skeezix/zikzak/photos/parts-shipment-may27.jpg

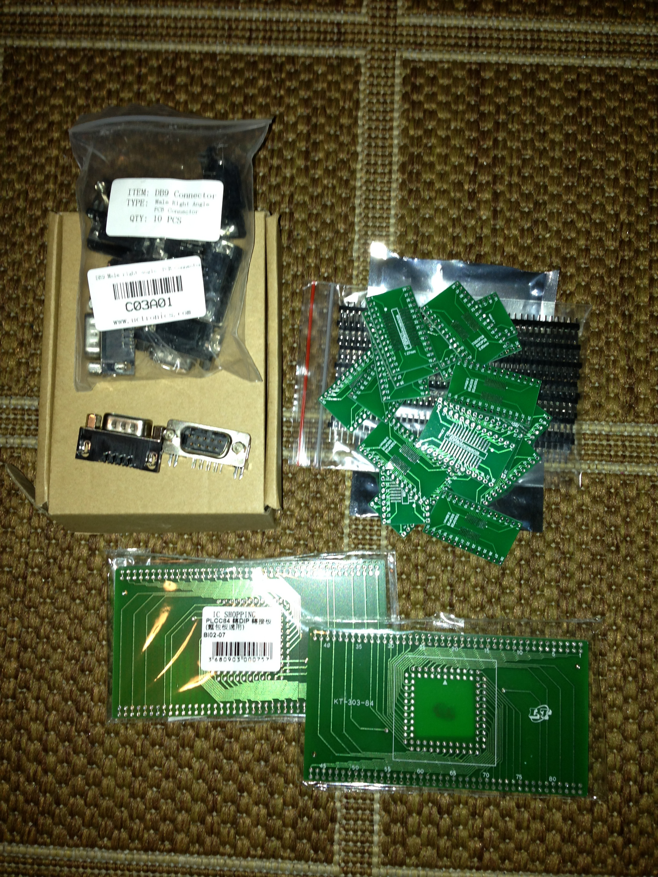
photos/parts-shipment-may27.jpg
