skeezix/zikzak/photos/zik80/zikcase/3d-print-proto/3dprinted-top-001.jpeg

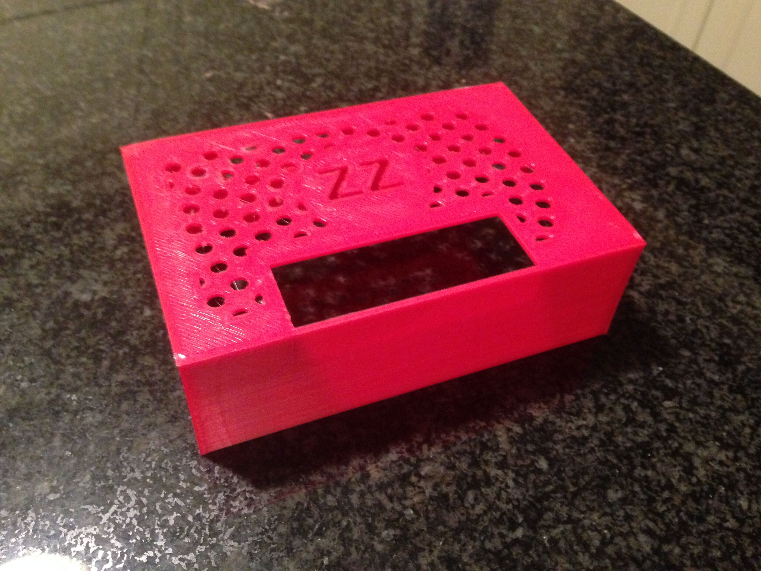
photos/zik80/zikcase/3d-print-proto/3dprinted-top-001.jpeg
