skeezix/zikzak/README.md

zikzak
======

Home designed and built retro-inspired computer; build a full computer from scratch, without using modern do-it-all chips
