skeezix/zikzak/zikzak3-gpu-c-linedemo/notes.txt

See also Pyro Electric:
http://www.pyroelectro.com/tutorials/arduino_basic_vga/software.html
