skeezix/zikzak/zikcart/protocard_2x18/cart-slot-pinout.pdf

Sheet1

36 pin (18x2)
805 Series 3.96mm (0.156”) Pitch 36P 18PX2 PCB Card Edge Connector

Top edge, female edge connector, facing into the mouth of it

## LEFT

TOP | 1 | 2 | 3 | 4 | 5 | 6
| VCC33 | A10 | A9 | A8 | A7 | A6
BOTTOM | 1 | 2 | 3 | 4 | 5 | 6
| VCC5 | A11 | A12 | A13 | A14 | A15

VCC5 – on bottom, since many through-hole parts need 5V so bottom is fine VCC33 – on top, since many surface mount parts may need 3.3V so top is better

Zikzak cartridgr

7 | 8 | 9 | 10 | 11 | 12 | 13
A5 | A4 | A3 | A2 | A1 | A0 | D0
7 | 8 | 9 | 10 | 11 | 12 | 13
A16 | A17 | A18 | A19 | A20 | A21 | D7

## RIGHT

14 | 15 | 16 | 17 | 18
D1 | D2 | D3 | /WE | /CE
14 | 15 | 16 | 17 | 18
D6 | D5 | D4 | /OE | GND
