skeezix/zikzak/zikcart/protocard_2x18/cart-slot-pinout.ods

Zikzak cartridgr
36 pin (18x2)
805 Series 3.96mm (0.156”) Pitch 36P 18PX2 PCB Card Edge Connector
Top edge, female edge connector, facing into the mouth of it
 | LEFT |  |  |  |  |  |  |  |  |  |  |  |  |  |  |  |  | RIGHT
TOP | 1 | 2 | 3 | 4 | 5 | 6 | 7 | 8 | 9 | 10 | 11 | 12 | 13 | 14 | 15 | 16 | 17 | 18
 | VCC33 | A10 | A9 | A8 | A7 | A6 | A5 | A4 | A3 | A2 | A1 | A0 | D0 | D1 | D2 | D3 | /WE | /CE
BOTTOM | 1 | 2 | 3 | 4 | 5 | 6 | 7 | 8 | 9 | 10 | 11 | 12 | 13 | 14 | 15 | 16 | 17 | 18
 | VCC5 | A11 | A12 | A13 | A14 | A15 | A16 | A17 | A18 | A19 | A20 | A21 | D7 | D6 | D5 | D4 | /OE | GND
VCC5 – on bottom, since many through-hole parts need 5V so bottom is fine
VCC33 – on top, since many surface mount parts may need 3.3V so top is better
power on left, gnd on right
includes /CE even though likely not used
Addresses on left
Data on right
least-significant-bits for address and data both on top, so easier to probe the stuff that changes more (the low-end address increment for instance)
