skeezix/zikzak/lazarus-pics/bottom-right-data-lines-25.jpg

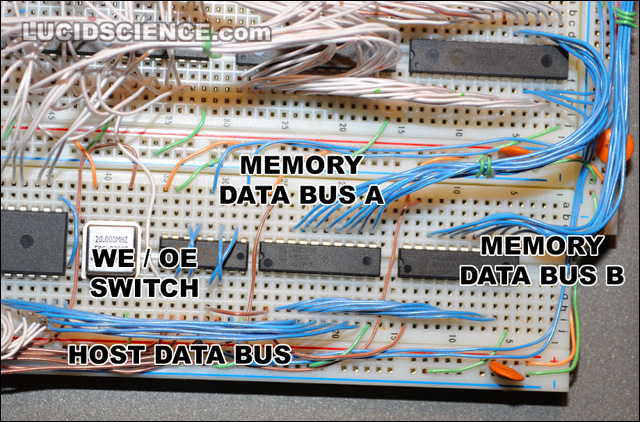
lazarus-pics/bottom-right-data-lines-25.jpg
