skeezix/zikzak/lazarus-pics/control-lines-schem15.jpg

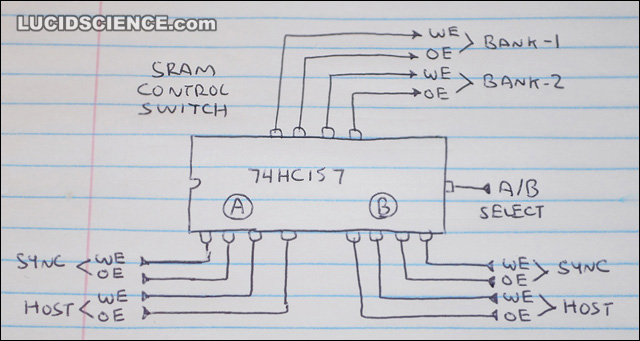
lazarus-pics/control-lines-schem15.jpg
