skeezix/zikzak/lazarus-pics/lazarus-layouts-6.jpg

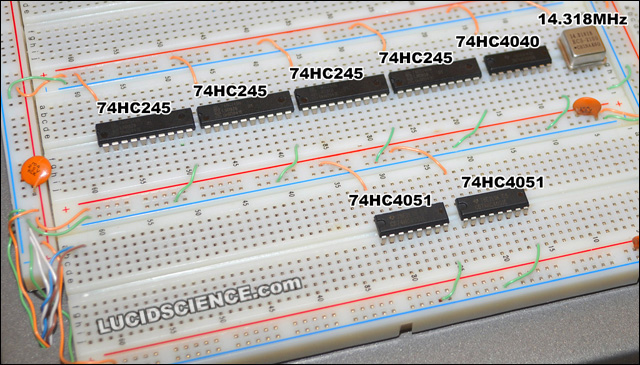
lazarus-pics/lazarus-layouts-6.jpg
