skeezix/zikzak/lazarus-pics/lazarus-layouts-11-great.jpg

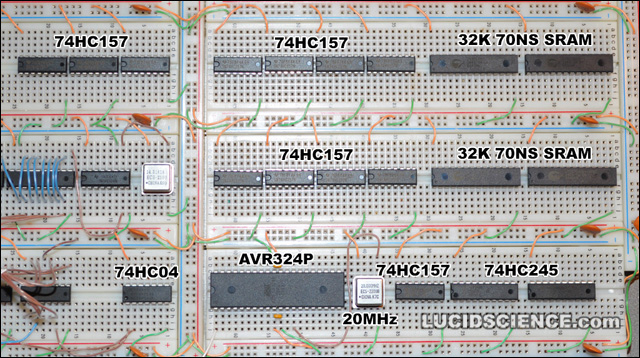
lazarus-pics/lazarus-layouts-11-great.jpg
