skeezix/zikzak/lazarus-pics/lazarus-layouts-14.jpg

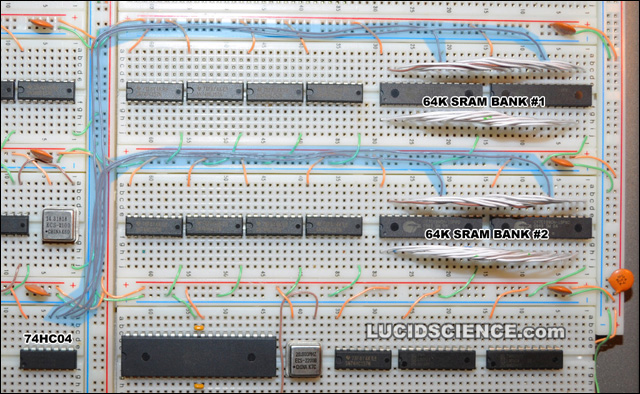
lazarus-pics/lazarus-layouts-14.jpg
