skeezix/zikzak/lazarus-pics/lazarus-layouts-16.jpg

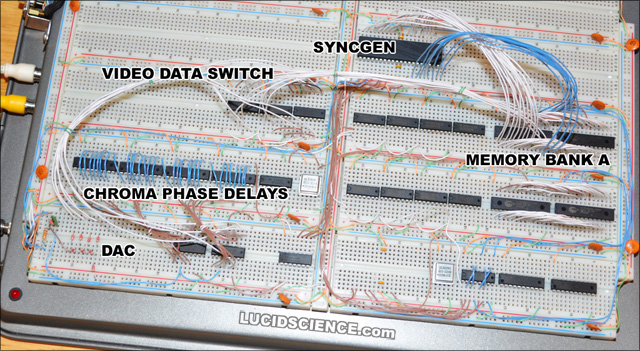
lazarus-pics/lazarus-layouts-16.jpg
