skeezix/zikzak/lazarus-pics/switcher-20.jpg

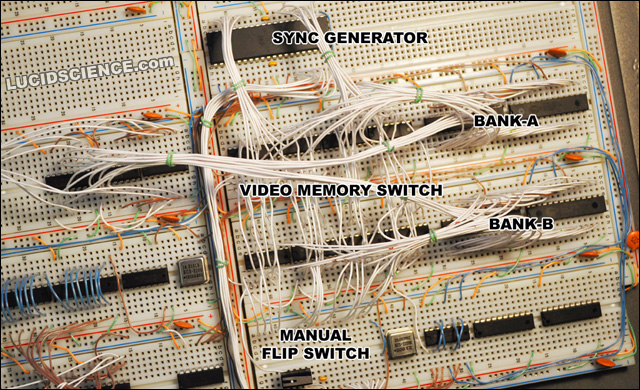
lazarus-pics/switcher-20.jpg
