skeezix/zikzak/lazarus-pics/switcher-schem-19.jpg

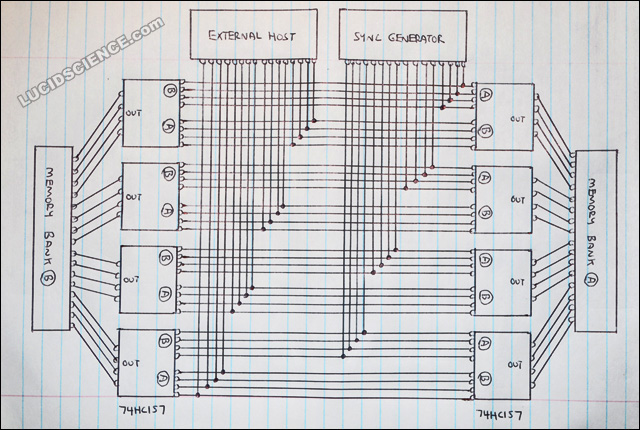
lazarus-pics/switcher-schem-19.jpg
