skeezix/zikzak/photos/atmega644-vic20-text-mode.jpg

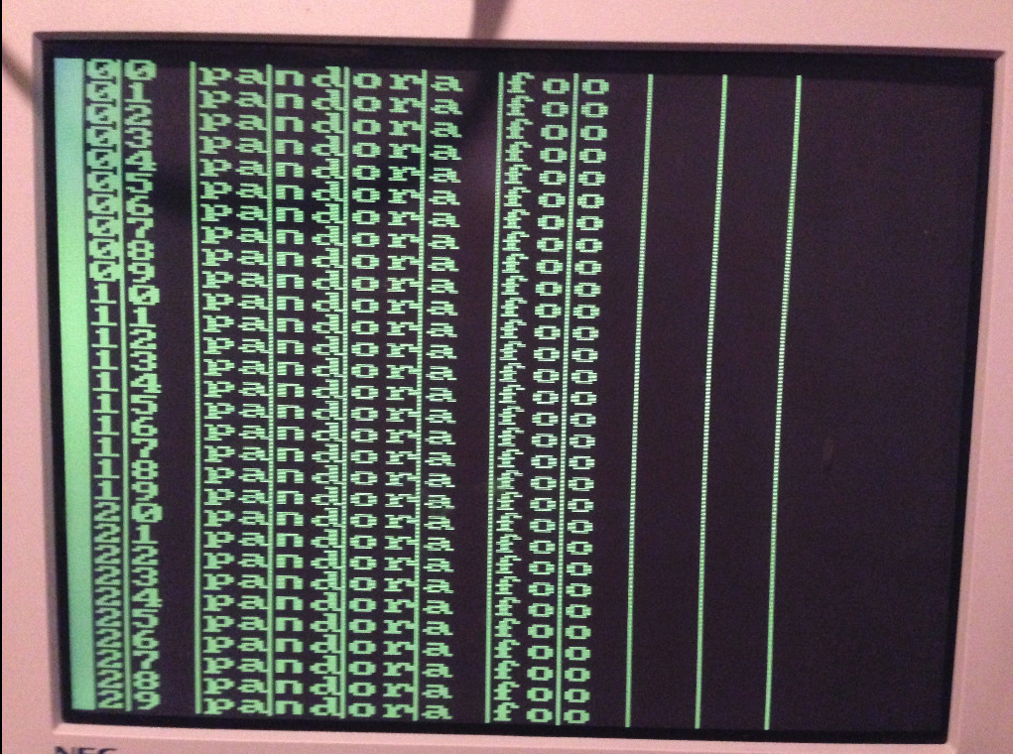
photos/atmega644-vic20-text-mode.jpg
