skeezix/zikzak/photos/zik80/base1-gpu2-power1-001.jpg

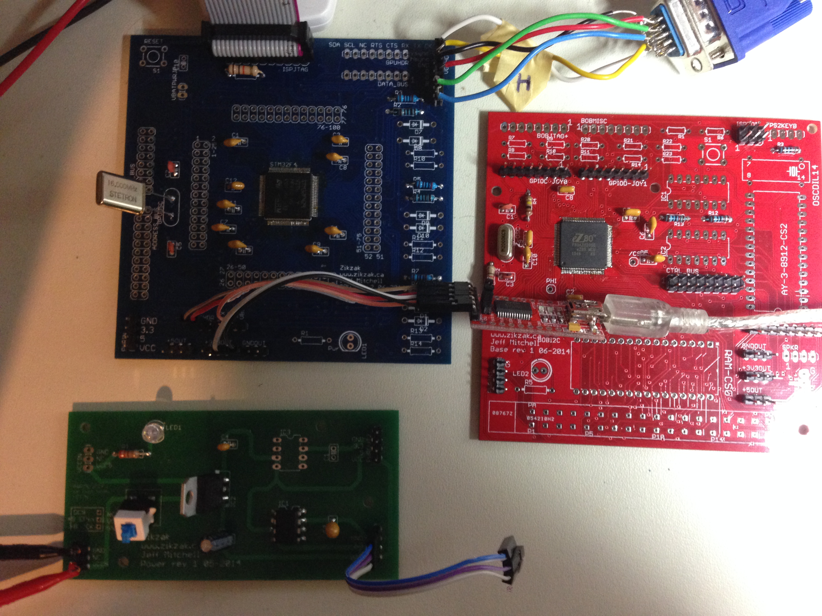
photos/zik80/base1-gpu2-power1-001.jpg
