skeezix/zikzak/photos/zik80/gpu-rev2-001.jpg

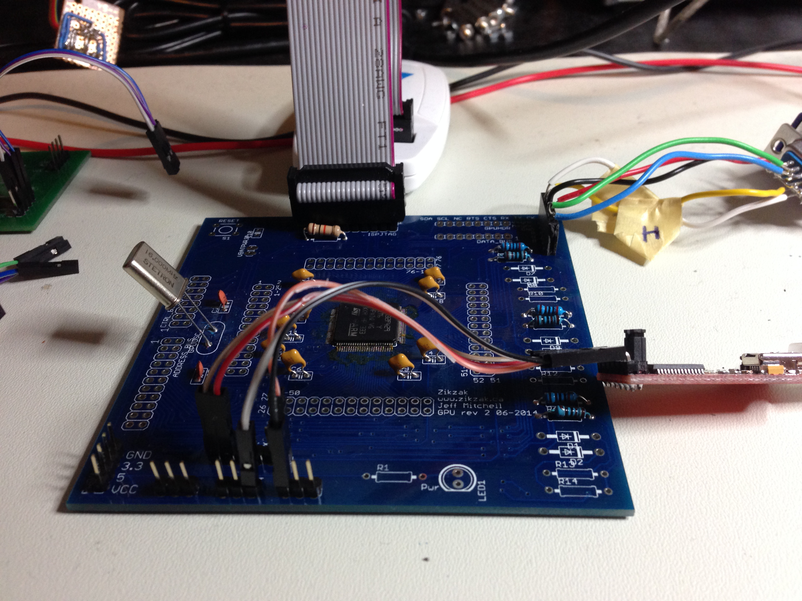
photos/zik80/gpu-rev2-001.jpg
