skeezix/zikzak/photos/zik80/gpu-rev2-rev1-comparison-001.jpg

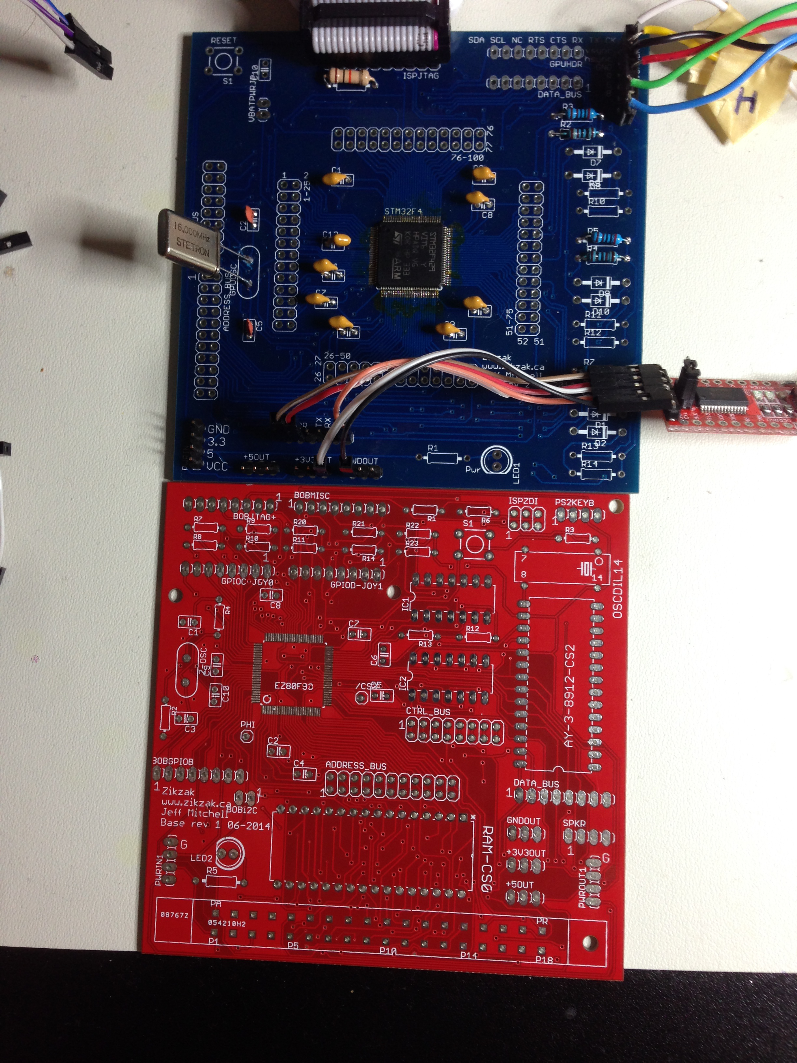
photos/zik80/gpu-rev2-rev1-comparison-001.jpg
