skeezix/zikzak/photos/zik80/gpu_and_power_frontback.jpg

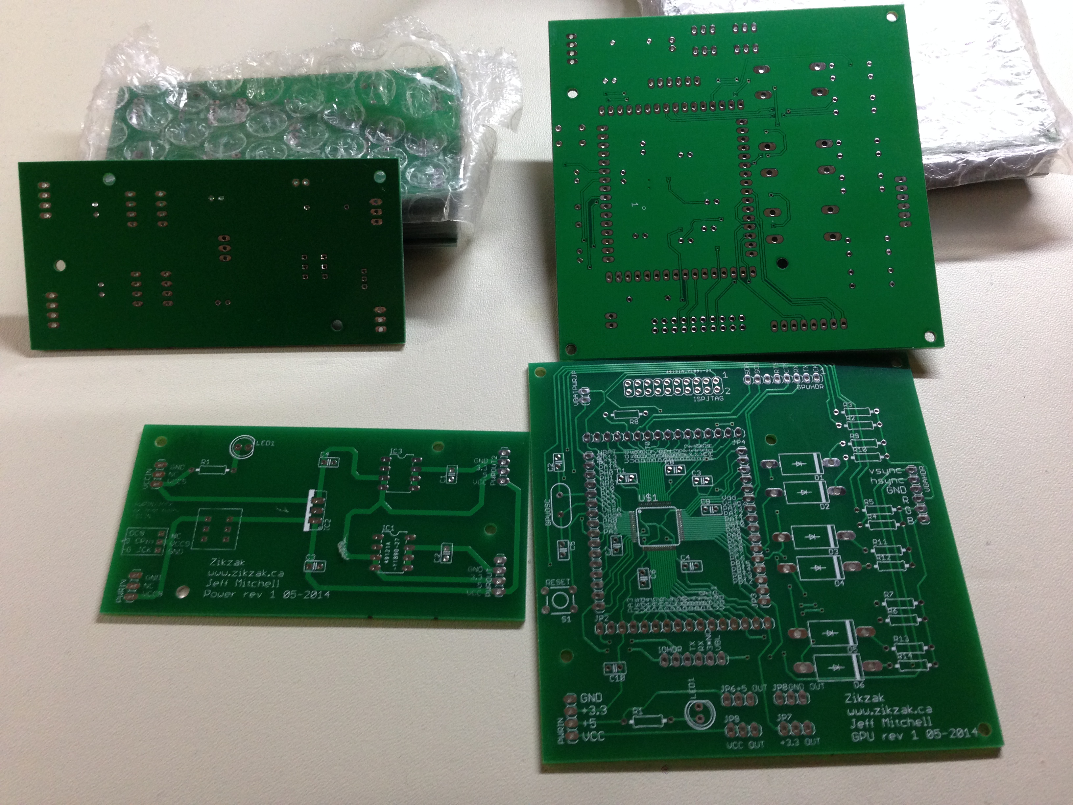
photos/zik80/gpu_and_power_frontback.jpg
