skeezix/zikzak/photos/zik80/gpu_frontback.jpg

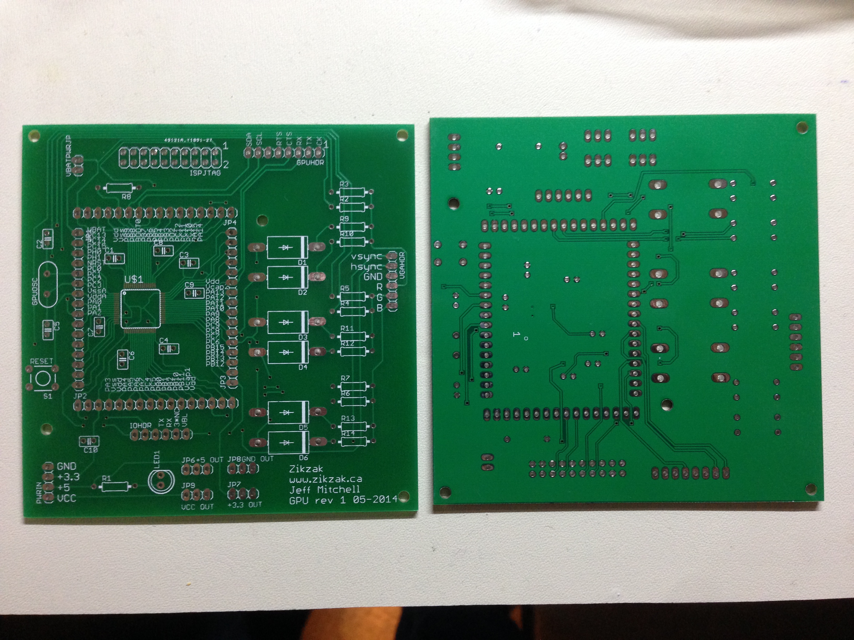
photos/zik80/gpu_frontback.jpg
