skeezix/zikzak/photos/zik80/gpu_proto_r1_running_001.jpg

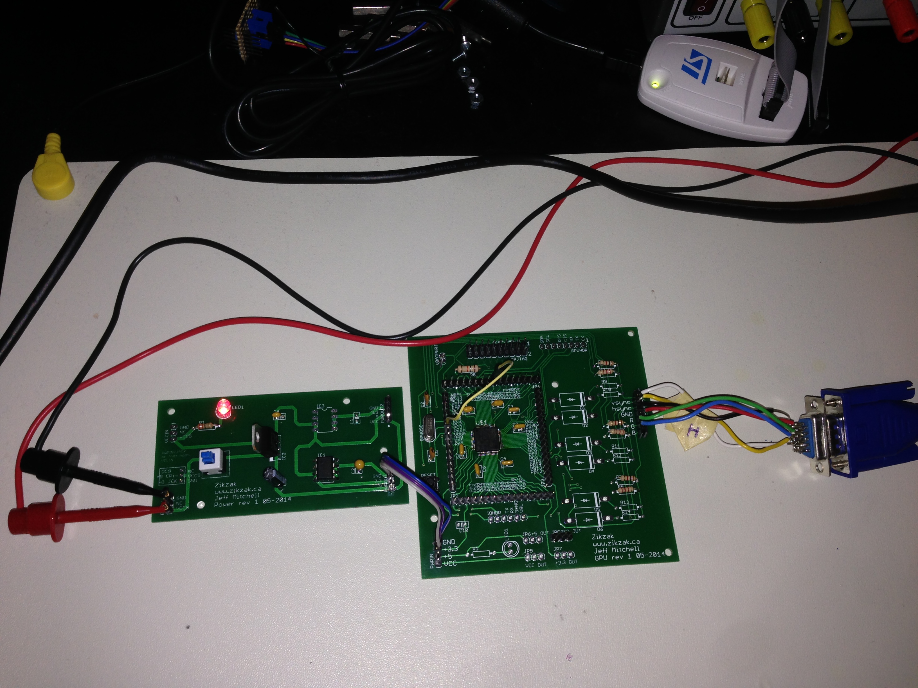
photos/zik80/gpu_proto_r1_running_001.jpg
