skeezix/zikzak/photos/zik80/sram-wtf-cs-oe.bmp

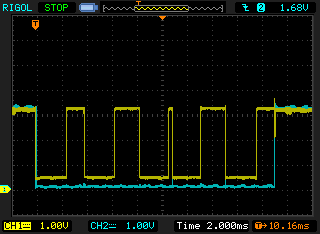
photos/zik80/sram-wtf-cs-oe.bmp
