skeezix/zikzak/photos/zik80/zik80-sbc-pcb-populated-45.jpg

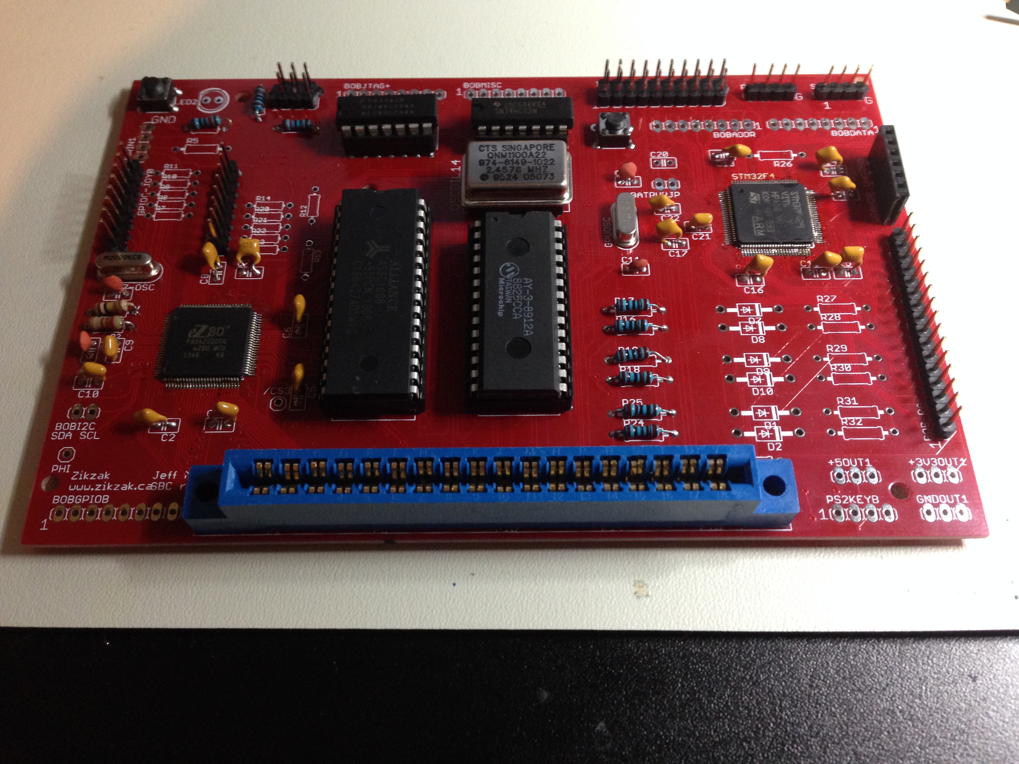
photos/zik80/zik80-sbc-pcb-populated-45.jpg
