skeezix/zikzak/photos/zik80/zik80-sbc-pcb-populated-90.jpg

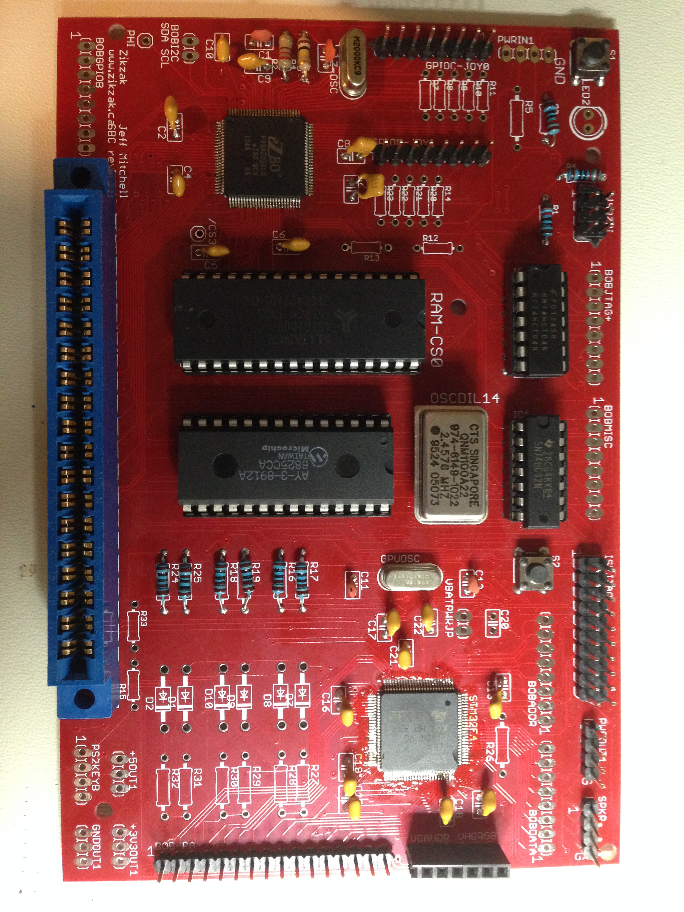
photos/zik80/zik80-sbc-pcb-populated-90.jpg
