skeezix/zikzak/photos/zik80/zik80-sbc-pcb-top.jpg

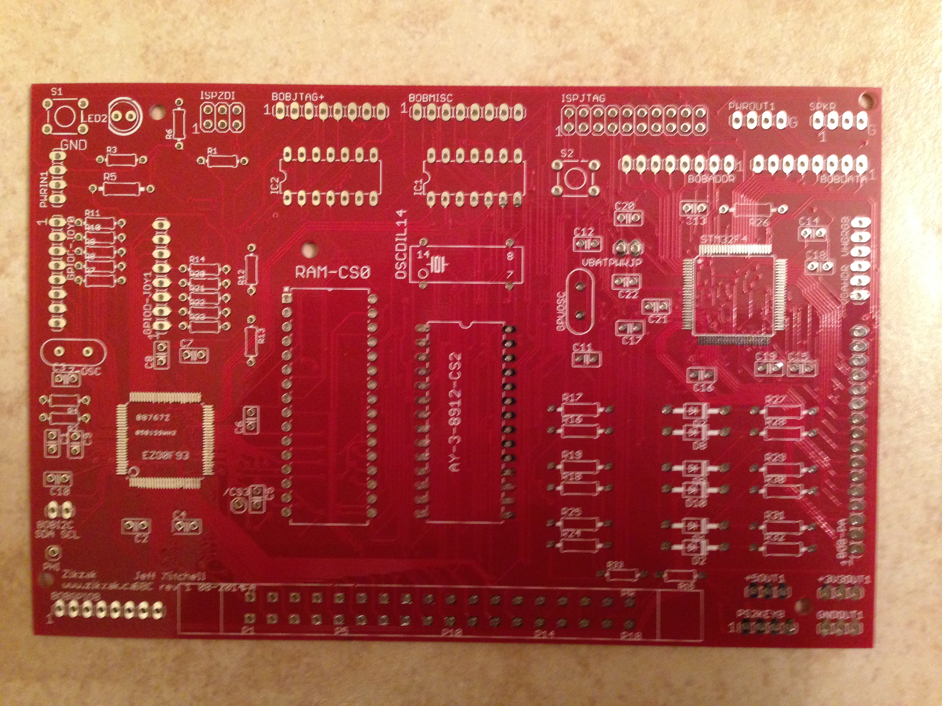
photos/zik80/zik80-sbc-pcb-top.jpg
