skeezix/zikzak/photos/zik80/zik80-sbc-pcb-topbottom.jpg

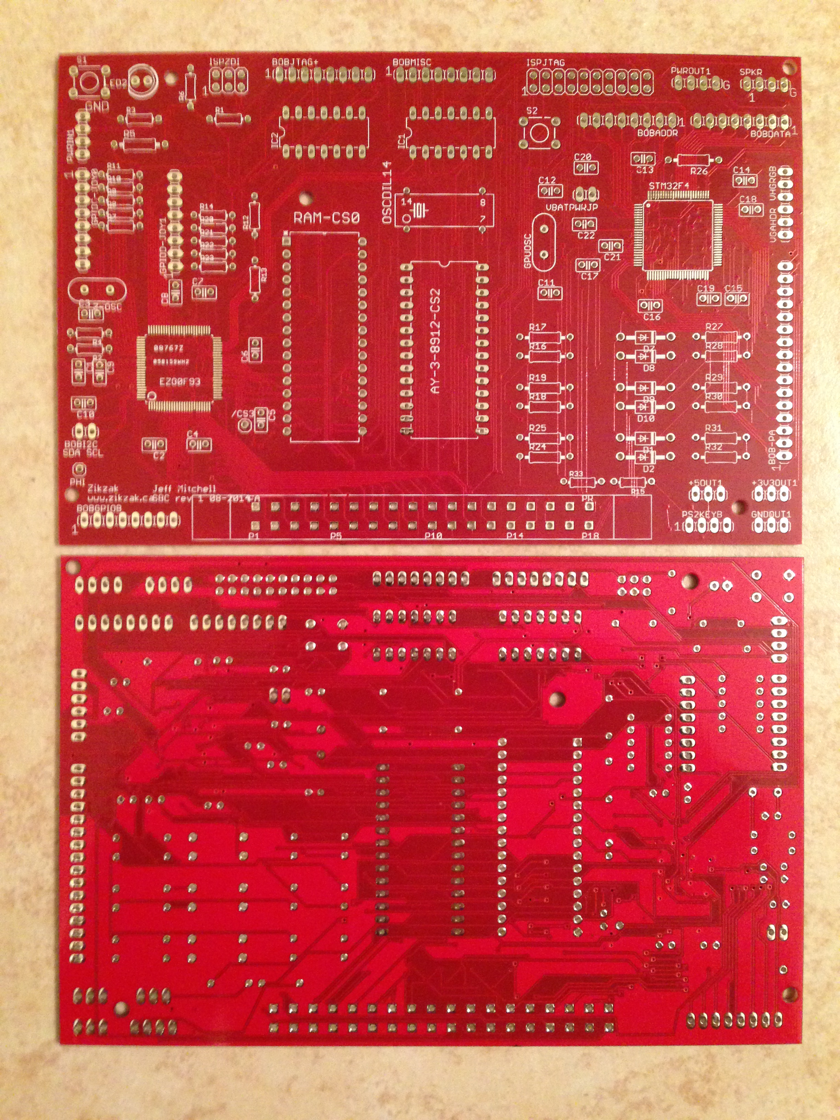
photos/zik80/zik80-sbc-pcb-topbottom.jpg
