skeezix/zikzak/photos/zik80/zikbase_with_cart_001.jpg

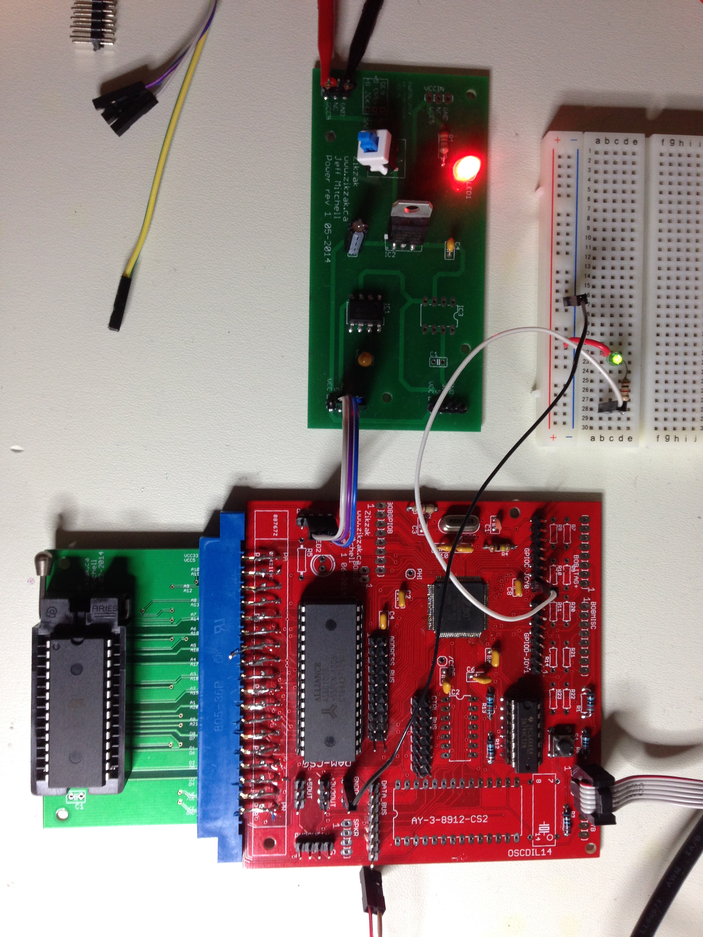
photos/zik80/zikbase_with_cart_001.jpg
