skeezix/zikzak/photos/zik80/zikzak-gpu+cpu-cthulhu-ribbons-001.jpg

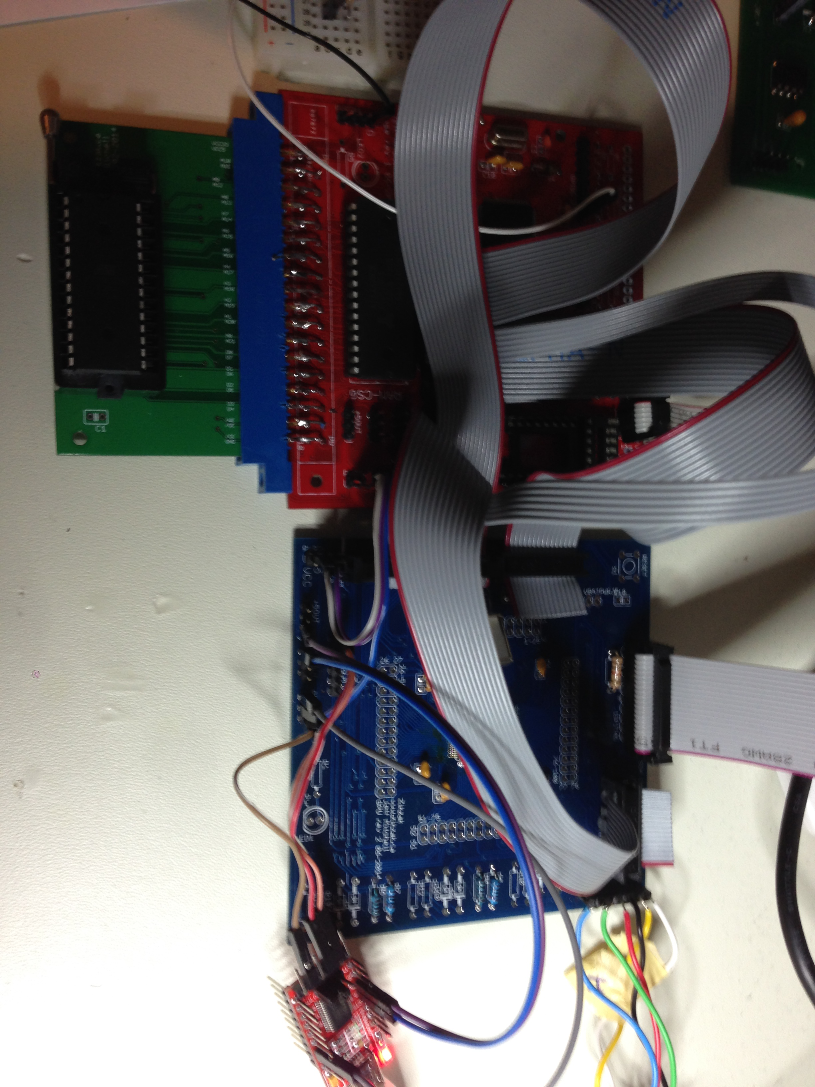
photos/zik80/zikzak-gpu+cpu-cthulhu-ribbons-001.jpg
