skeezix/zikzak/photos/zik80/zikzak-gpu+cpu-sram-framebuffer-001.jpg

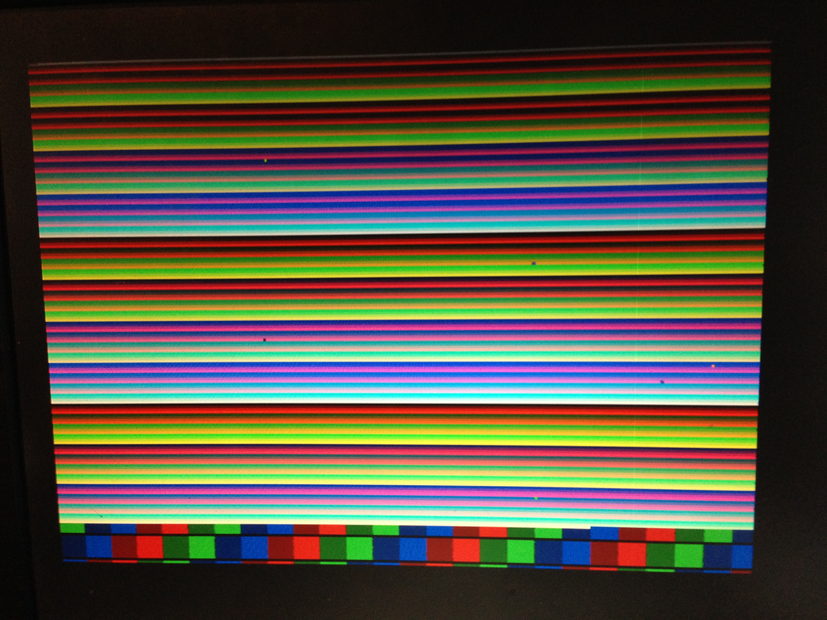
photos/zik80/zikzak-gpu+cpu-sram-framebuffer-001.jpg
