skeezix/zikzak/photos/zik80/zz-sbc-r3-001.jpg

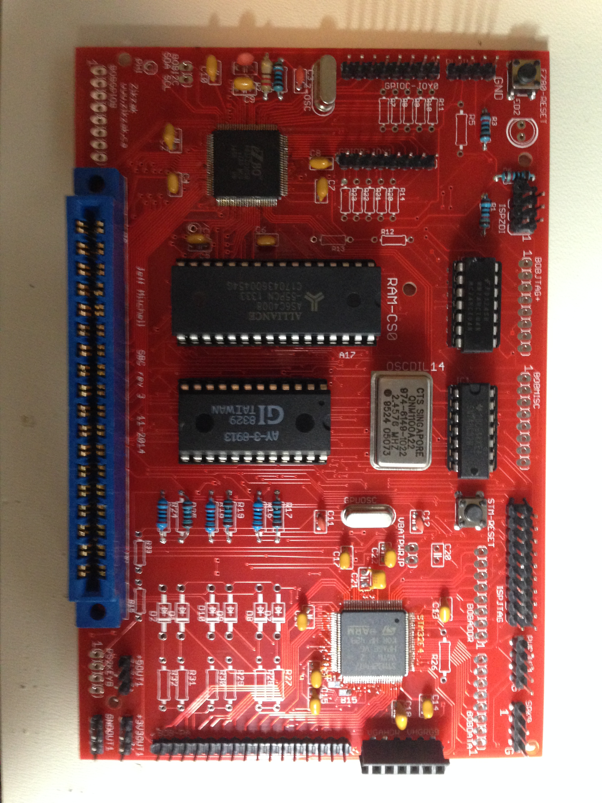
photos/zik80/zz-sbc-r3-001.jpg
