skeezix/zikzak/photos/zik80/zz-sbc-r3-002.jpg

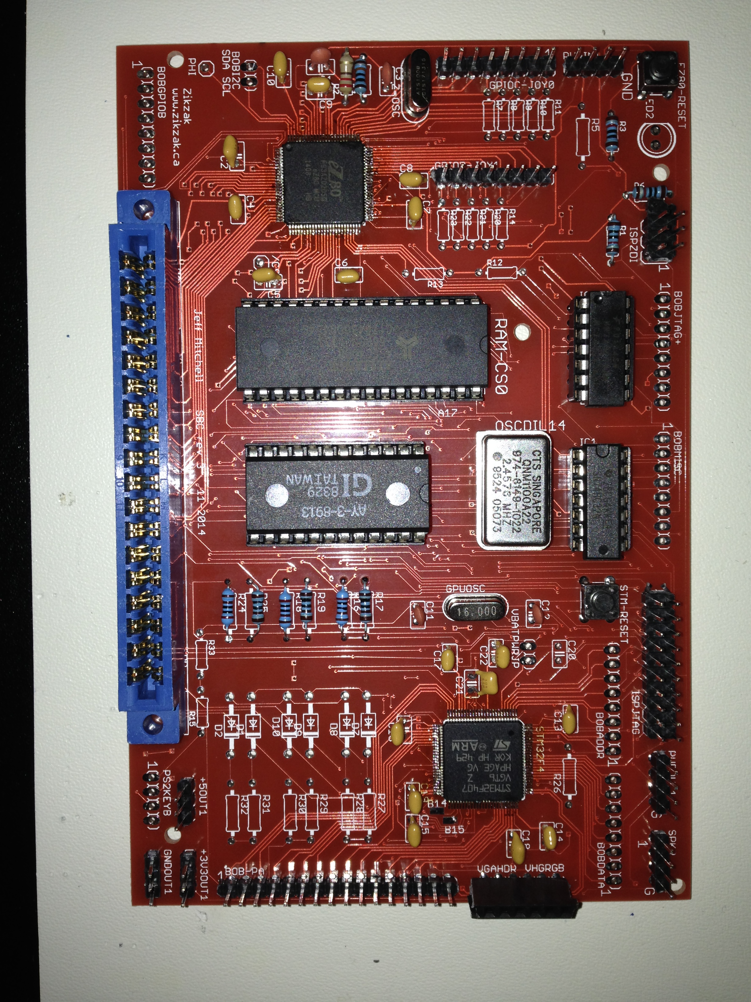
photos/zik80/zz-sbc-r3-002.jpg
