skeezix/zikzak/photos/zik80/zz-sbc-r3-003-RESIZE86.jpg

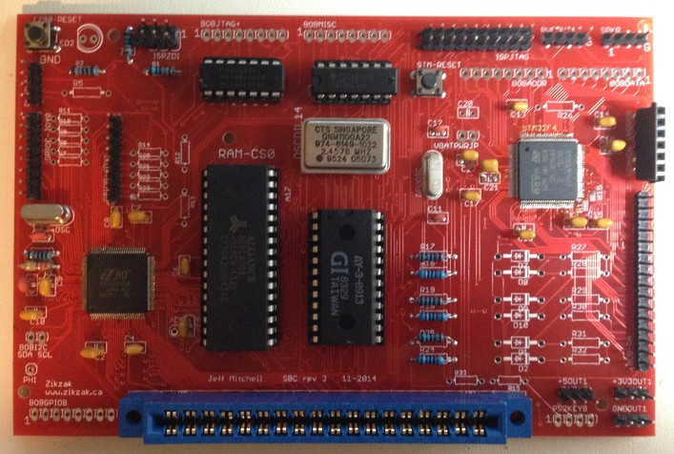
photos/zik80/zz-sbc-r3-003-RESIZE86.jpg
