skeezix/zikzak/photos/zik80/zz-sbc-r3-004-withcart.jpg

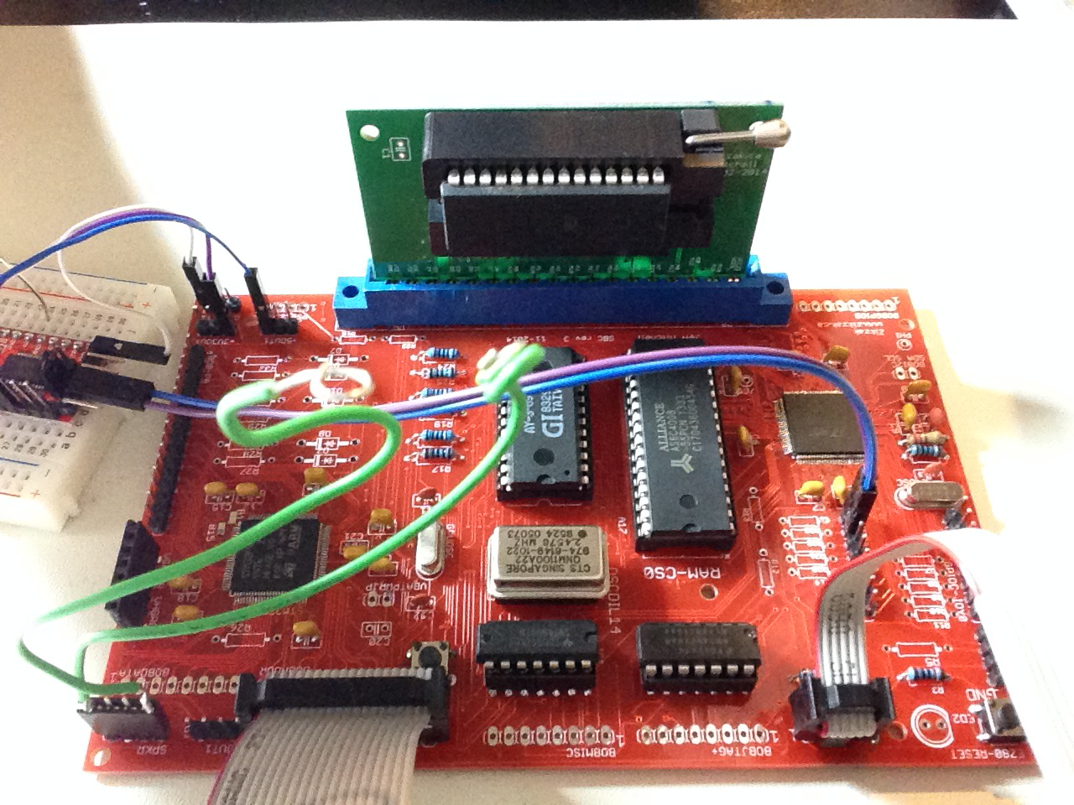
photos/zik80/zz-sbc-r3-004-withcart.jpg
