skeezix/zikzak/photos/zik80/zz-sbc-r3-iso-RESIZE86.jpg

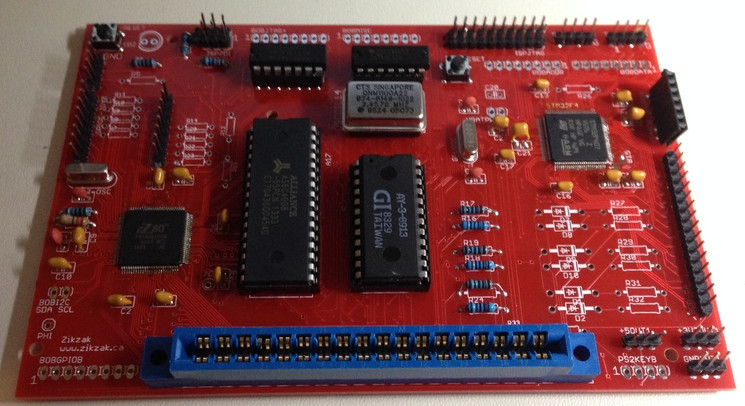
photos/zik80/zz-sbc-r3-iso-RESIZE86.jpg
