skeezix/zikzak/photos/zik80/zz-sbc-r3-iso.jpg

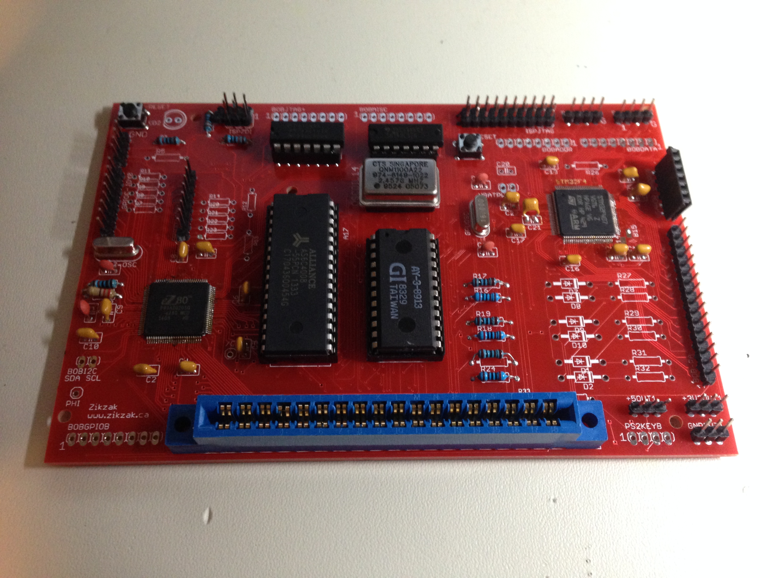
photos/zik80/zz-sbc-r3-iso.jpg
