skeezix/zikzak/photos/zik80/zzr3-shield-r1-progress/zikshield r1 on ZZr3 - 001 - hooked up.jpg

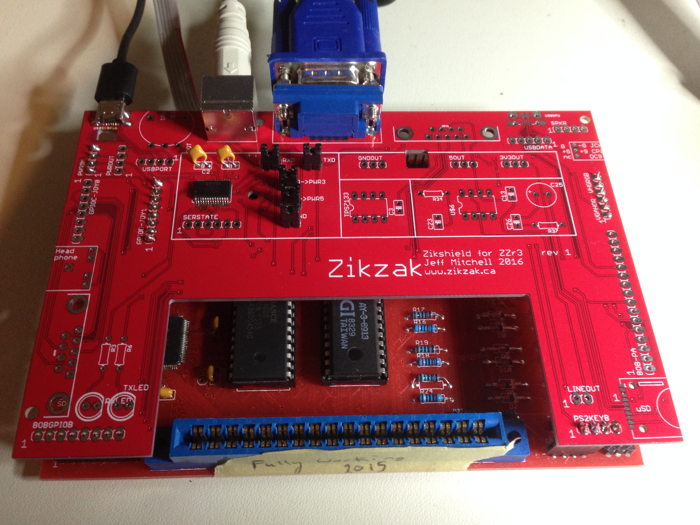
photos/zik80/zzr3-shield-r1-progress/zikshield r1 on ZZr3 - 001 - hooked up.jpg
