skeezix/zikzak/photos/zik80/zzr3-shield-r1-progress/zikshield-wip-002-with-connectors.jpg

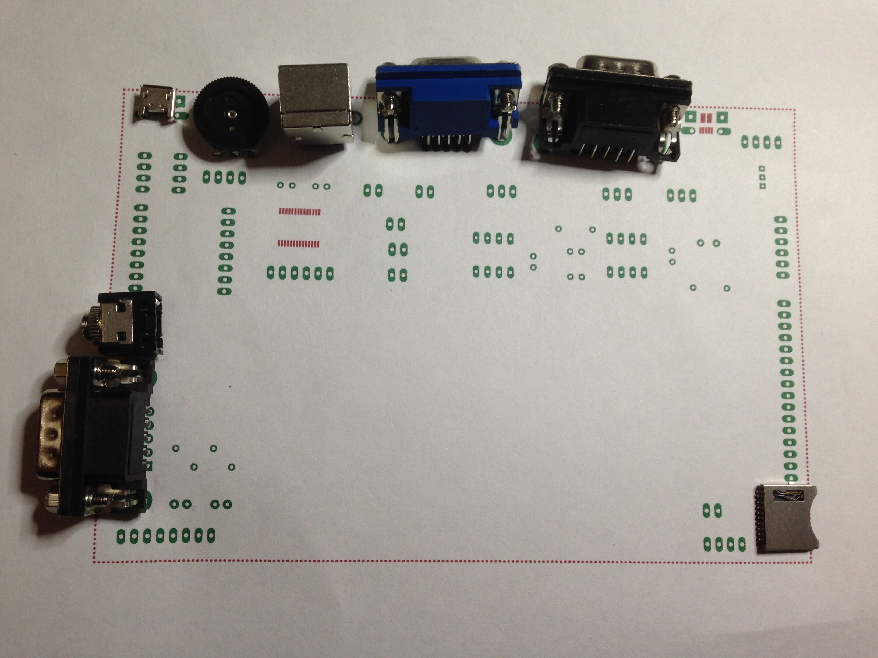
photos/zik80/zzr3-shield-r1-progress/zikshield-wip-002-with-connectors.jpg
