skeezix/zikzak/photos/zik80/zzr3-shield-r1-progress/zzr3-just-pads-etc.png

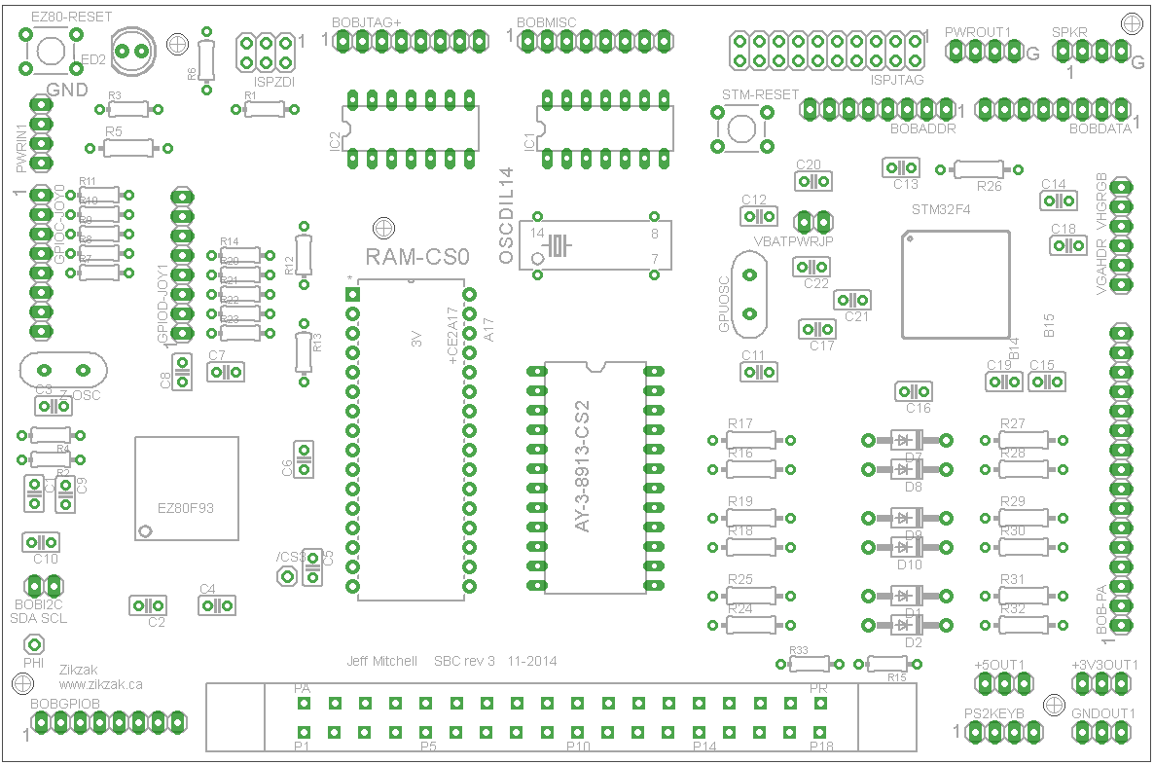
photos/zik80/zzr3-shield-r1-progress/zzr3-just-pads-etc.png
