skeezix/zikzak/photos/zik80/zzr3-shield-r1-progress/zzr3-shield-r1-layout-wip-002.png

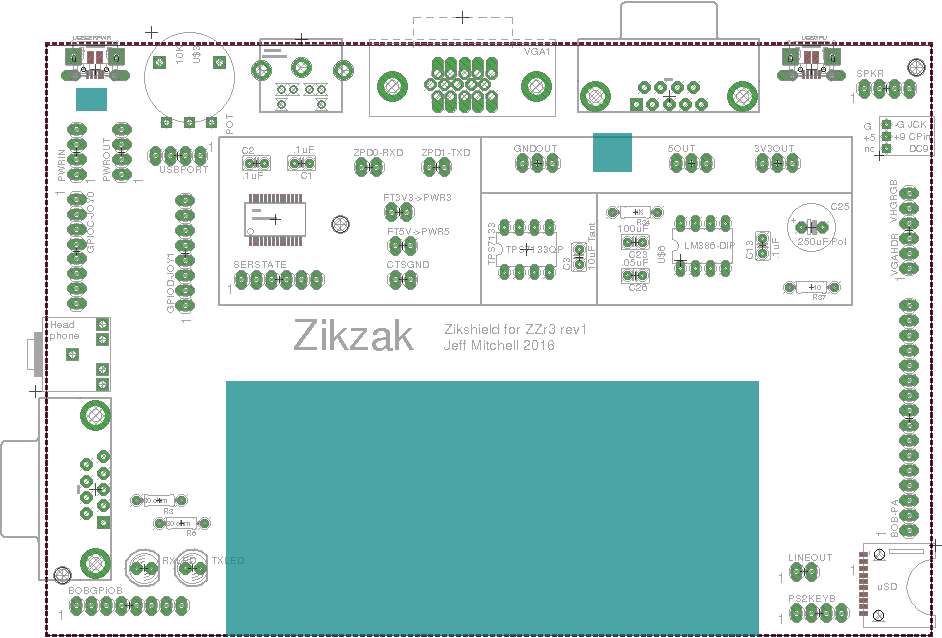
photos/zik80/zzr3-shield-r1-progress/zzr3-shield-r1-layout-wip-002.png
