skeezix/zikzak/photos/zikzak1-ntsc-mono-line-001.jpg

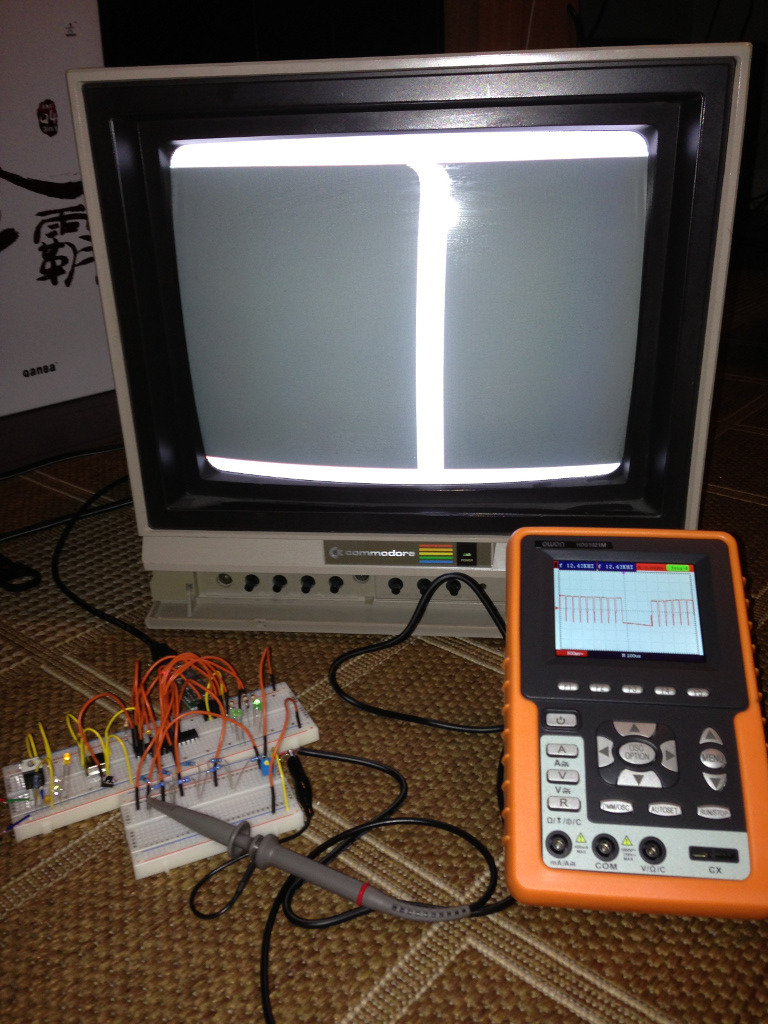
photos/zikzak1-ntsc-mono-line-001.jpg
