skeezix/zikzak/photos/zikzak2-vga-000-schem.jpg

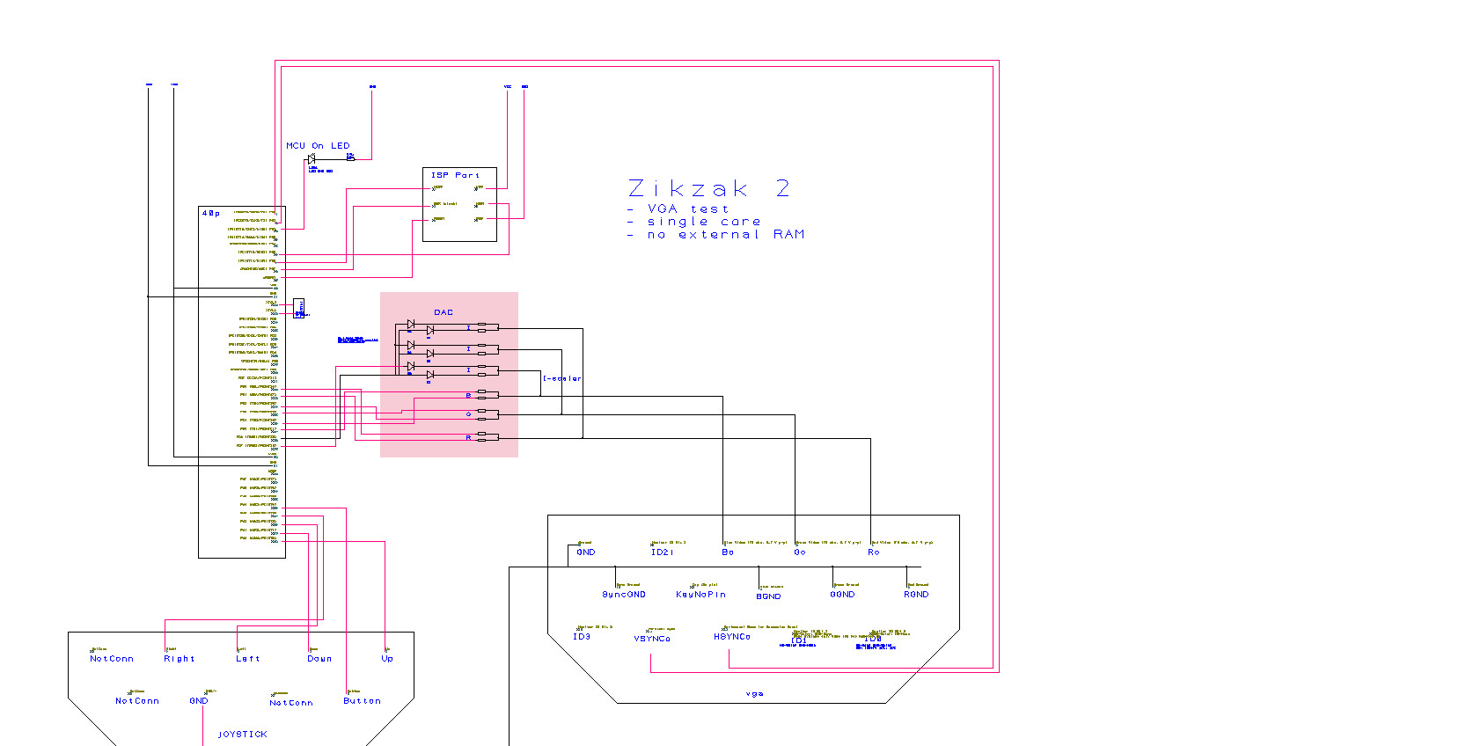
photos/zikzak2-vga-000-schem.jpg
