skeezix/zikzak/photos/zikzak2-vga-001-bb.JPG

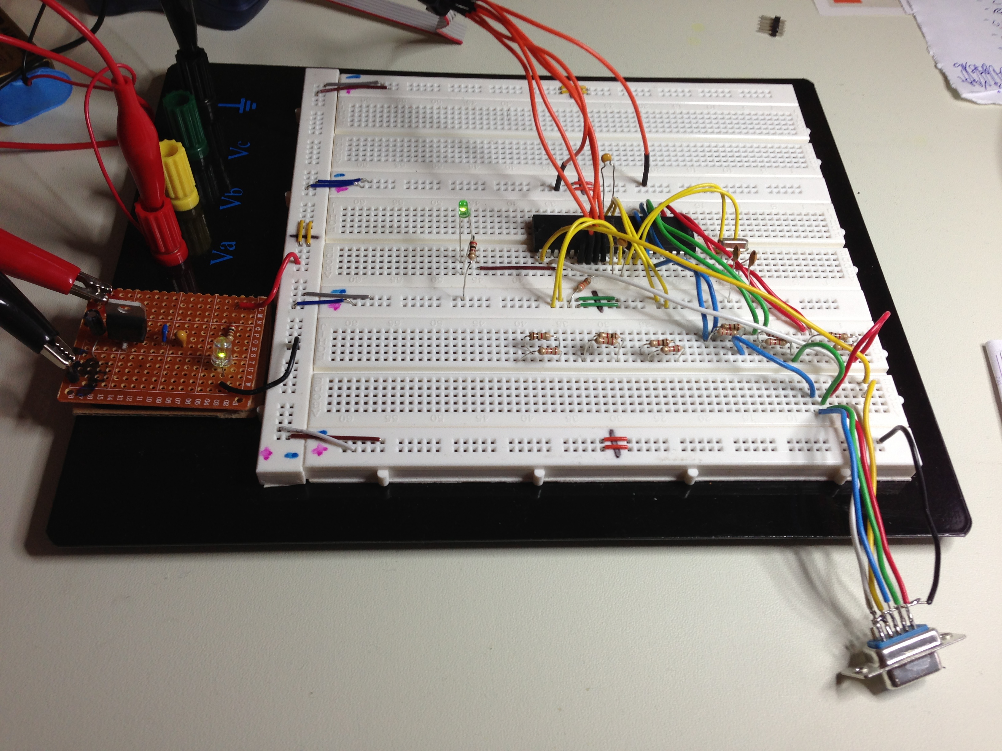
photos/zikzak2-vga-001-bb.JPG
