skeezix/zikzak/photos/zikzak2-vga-002-colour1.jpg

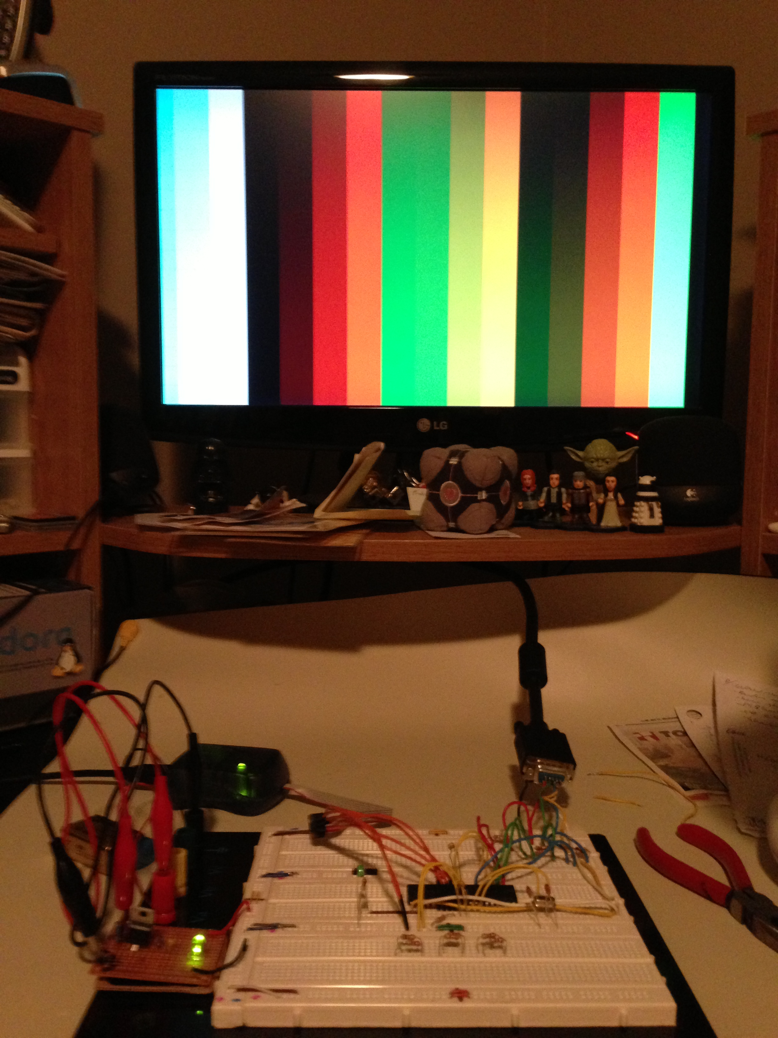
photos/zikzak2-vga-002-colour1.jpg
