skeezix/zikzak/photos/zikzak2-vga-002-colour2.jpg

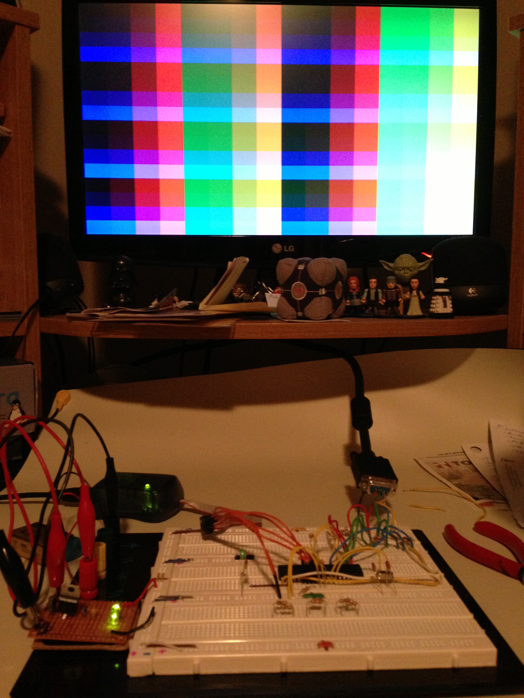
photos/zikzak2-vga-002-colour2.jpg
