skeezix/zikzak/photos/zikzak2-vga-002-redbar-r.JPG

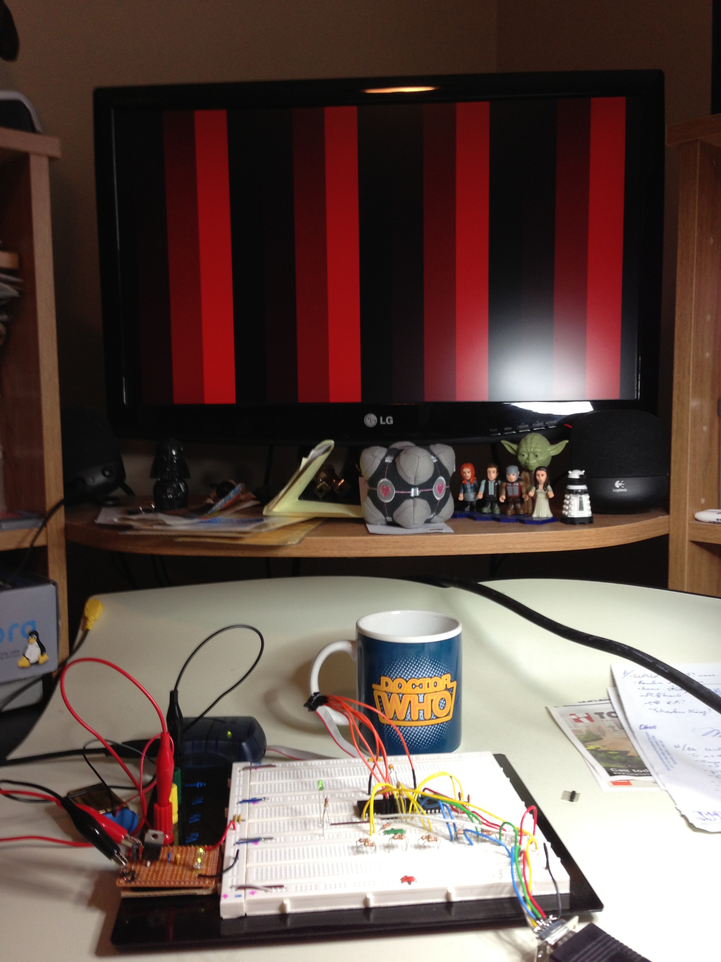
photos/zikzak2-vga-002-redbar-r.JPG
