skeezix/zikzak/photos/zikzak3-gpu-memswitch-complete.JPG

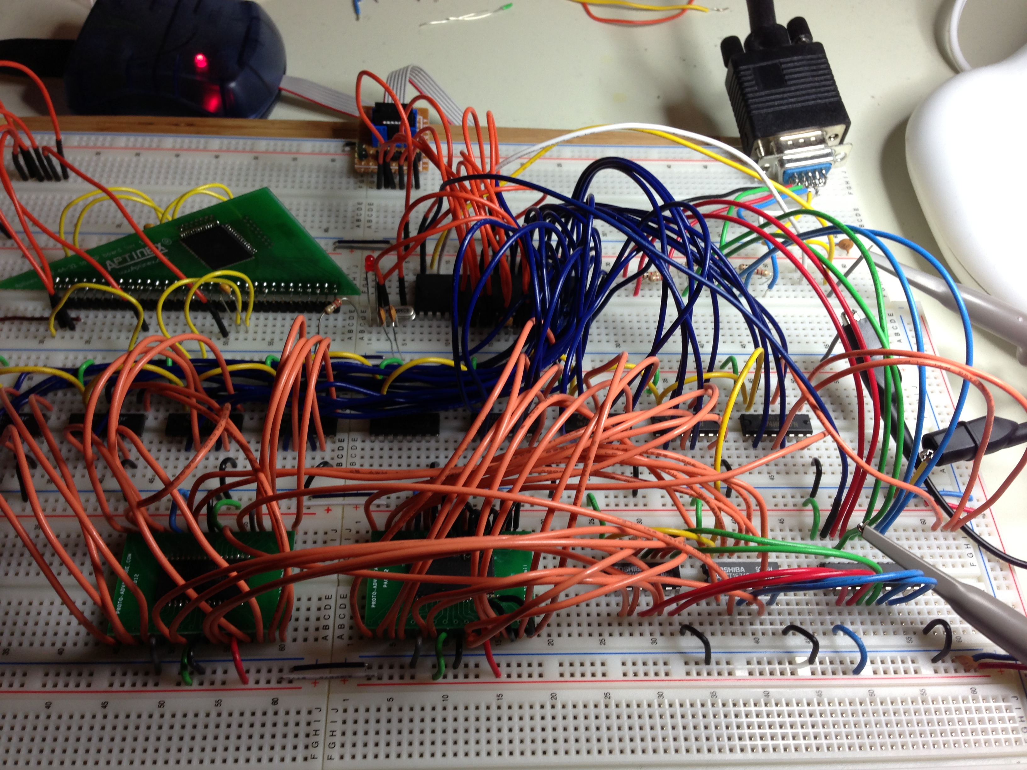
photos/zikzak3-gpu-memswitch-complete.JPG
