skeezix/zikzak/photos/zikzak3-memswitch2.png

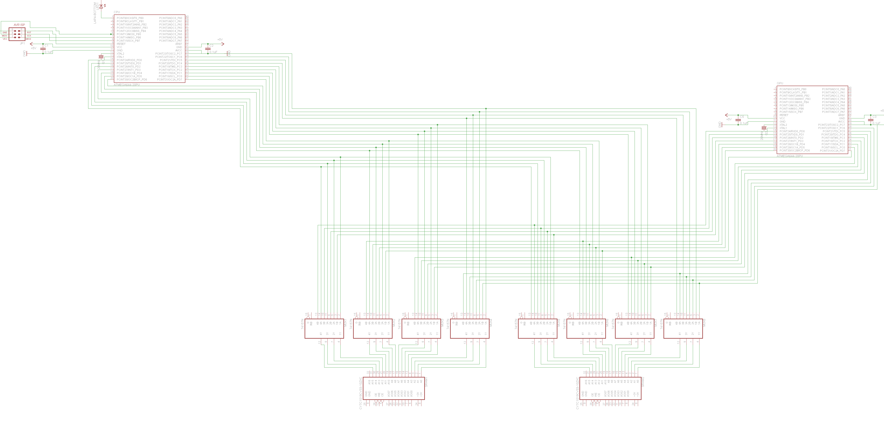
photos/zikzak3-memswitch2.png
