skeezix/zikzak/photos/zikzak3-memswitch3.png

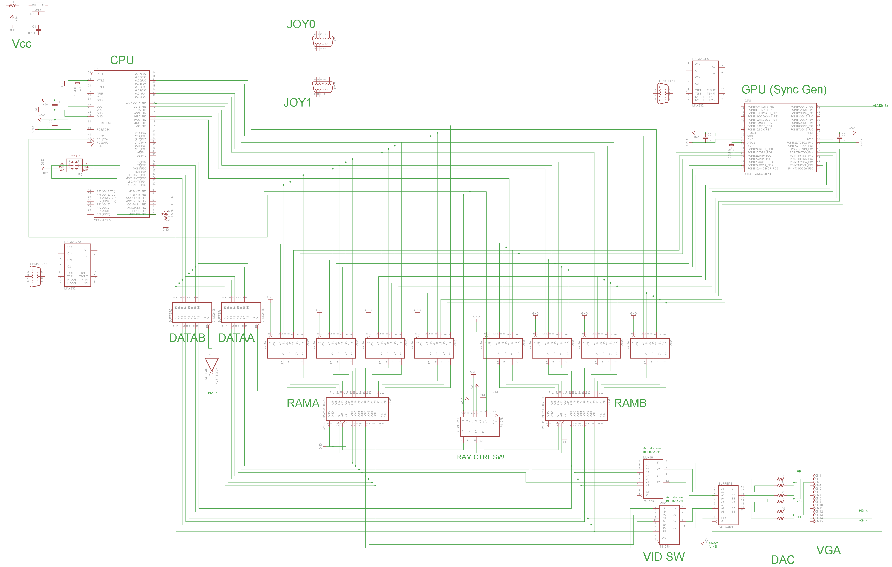
photos/zikzak3-memswitch3.png
