skeezix/zikzak/photos/zikzak_giant_breadboard.jpg

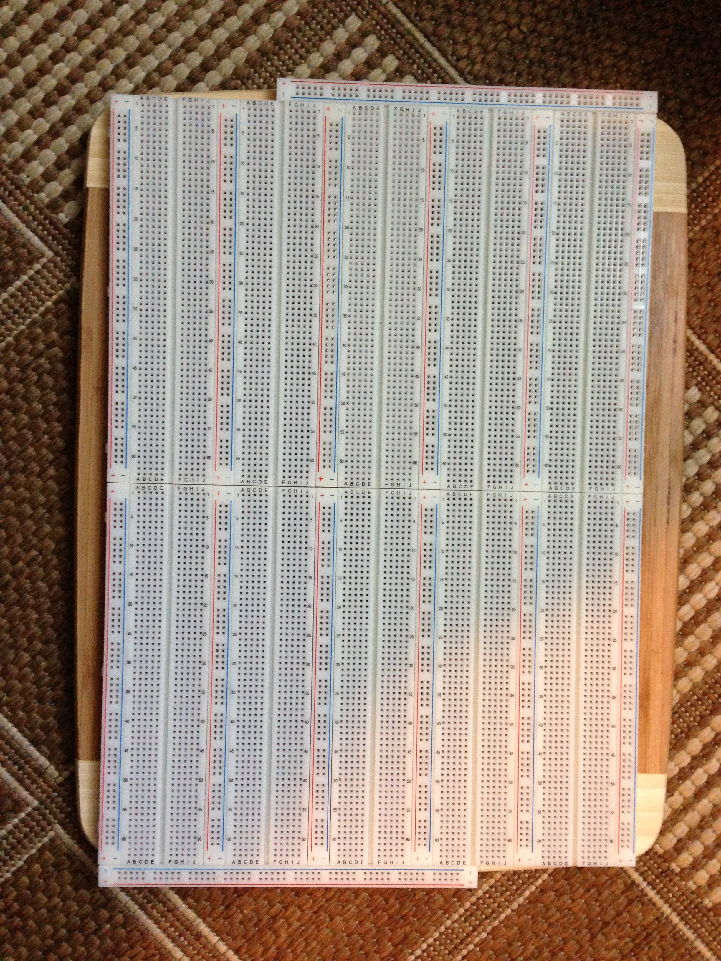
photos/zikzak_giant_breadboard.jpg
