skeezix/zikzak/photos/zikzak_memswitch001.png

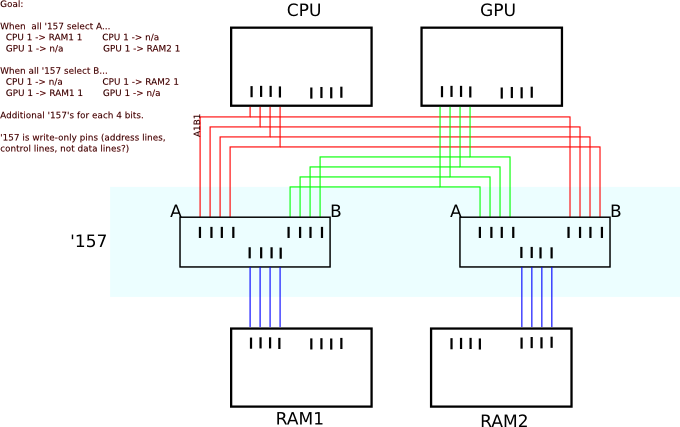
photos/zikzak_memswitch001.png
