skeezix/zikzak/zik80/_reference/stm32f4-vga-build/Documentation/Schematic.png

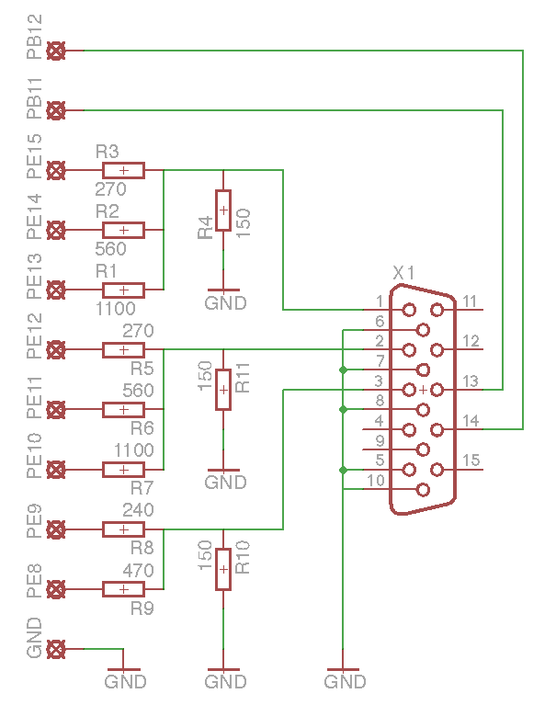
zik80/_reference/stm32f4-vga-build/Documentation/Schematic.png
