skeezix/zikzak/zik80/audio-gen/ym6-file-format-html/ym6_files/news_data/fondpageblanc.gif

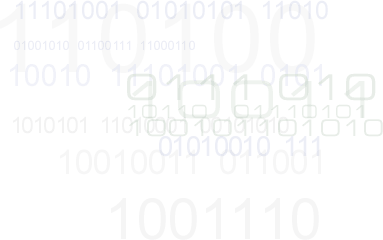
zik80/audio-gen/ym6-file-format-html/ym6_files/news_data/fondpageblanc.gif
