skeezix/zikzak/zik80/downconvert/alinktothepast_screen.jpg

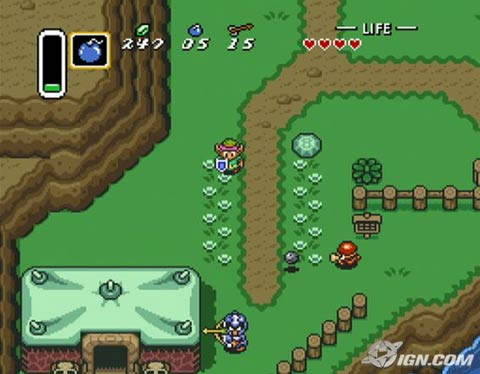
zik80/downconvert/alinktothepast_screen.jpg
