skeezix/zikzak/zik80/downconvert/firefly_mmo.jpg

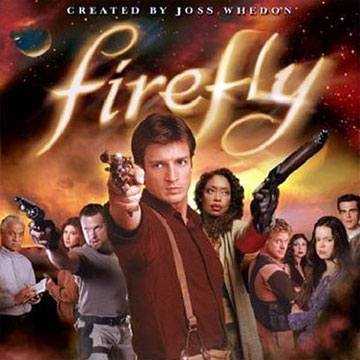
zik80/downconvert/firefly_mmo.jpg
