skeezix/zikzak/zik80/downconvert/gabi.jpg

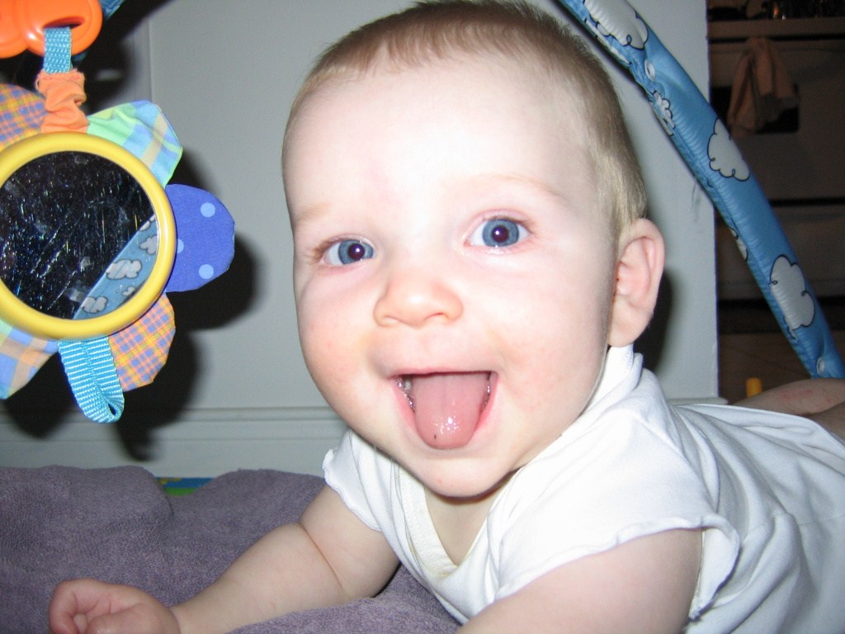
zik80/downconvert/gabi.jpg
