skeezix/zikzak/zik80/downconvert/yuehui-tang-01.jpg

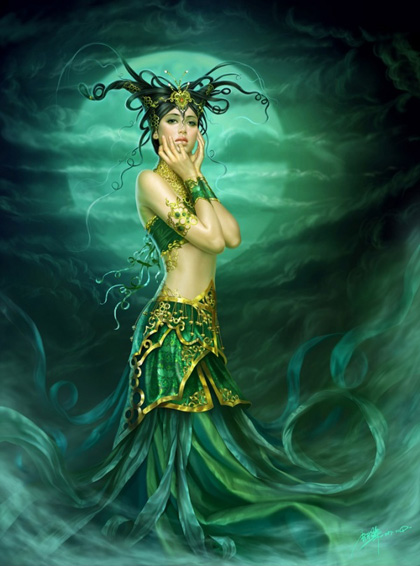
zik80/downconvert/yuehui-tang-01.jpg
