skeezix/zikzak/zik80/schem/zik80-001-schem.png

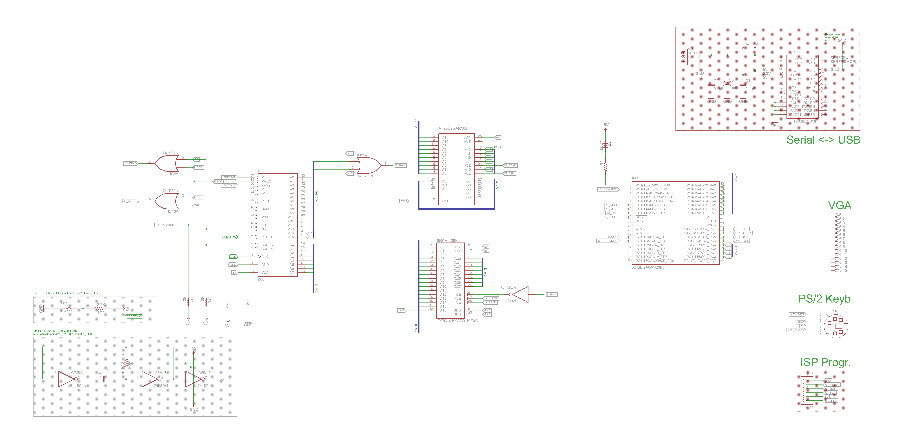
zik80/schem/zik80-001-schem.png
