skeezix/zikzak/zik80/schem/zik80-002-schem.png

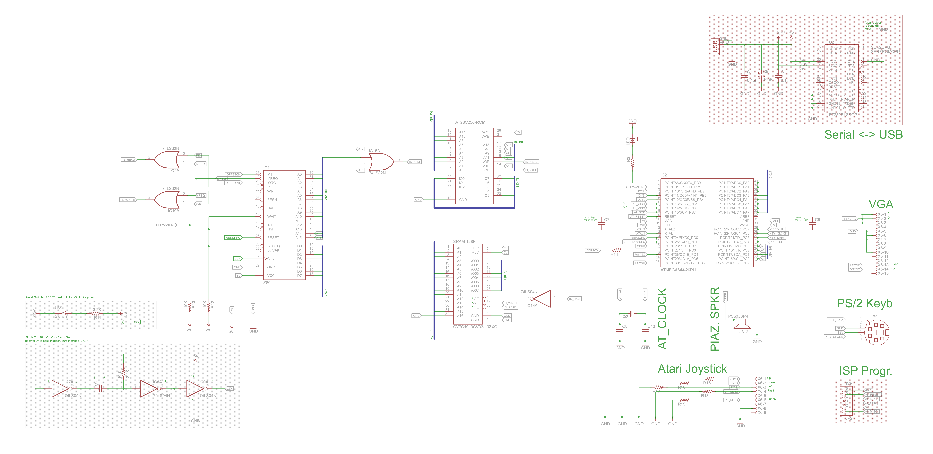
zik80/schem/zik80-002-schem.png
