skeezix/zikzak/zik80/schem/zik80-003-schem.png

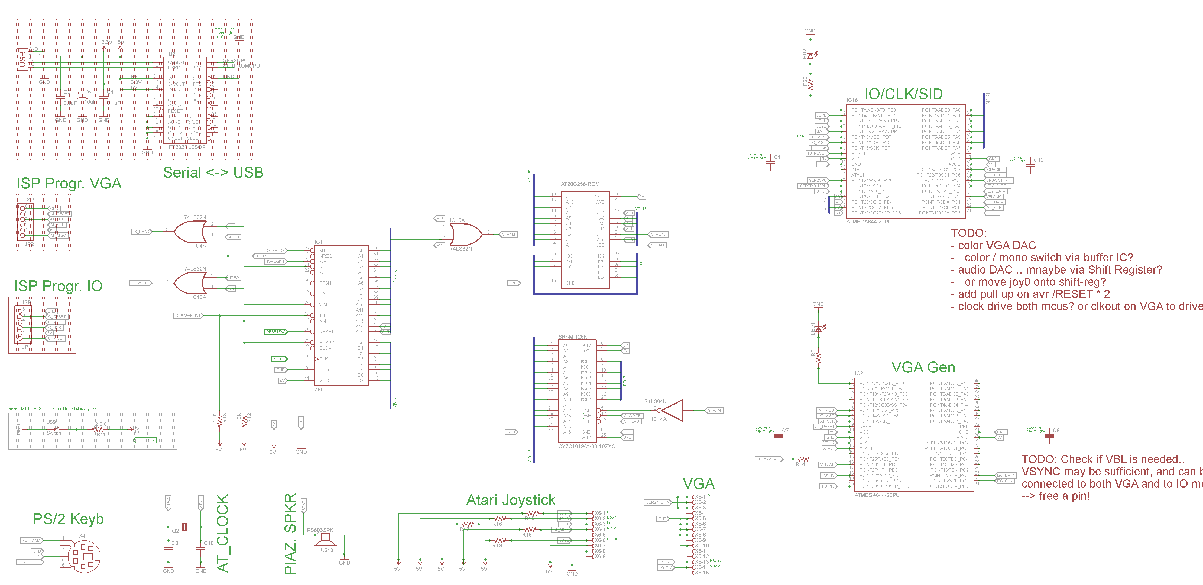
zik80/schem/zik80-003-schem.png
