skeezix/zikzak/zik80/schem/zik80-base-bussed-rev1-schem.png

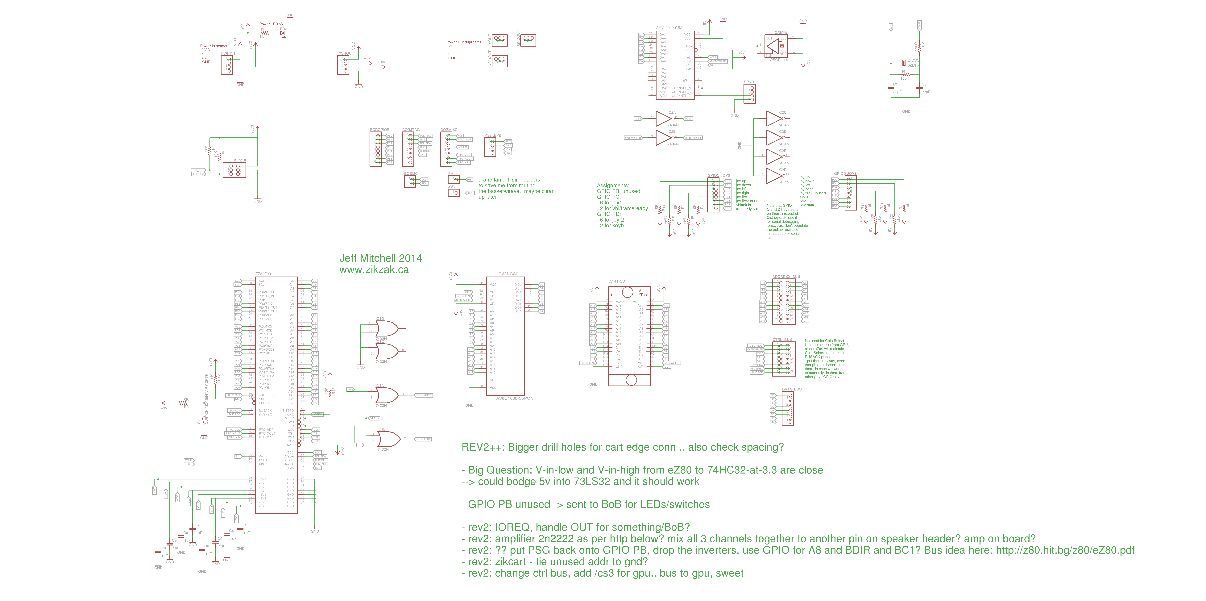
zik80/schem/zik80-base-bussed-rev1-schem.png
