skeezix/zikzak/zik80/schem/zik80-base-pwr-001.png

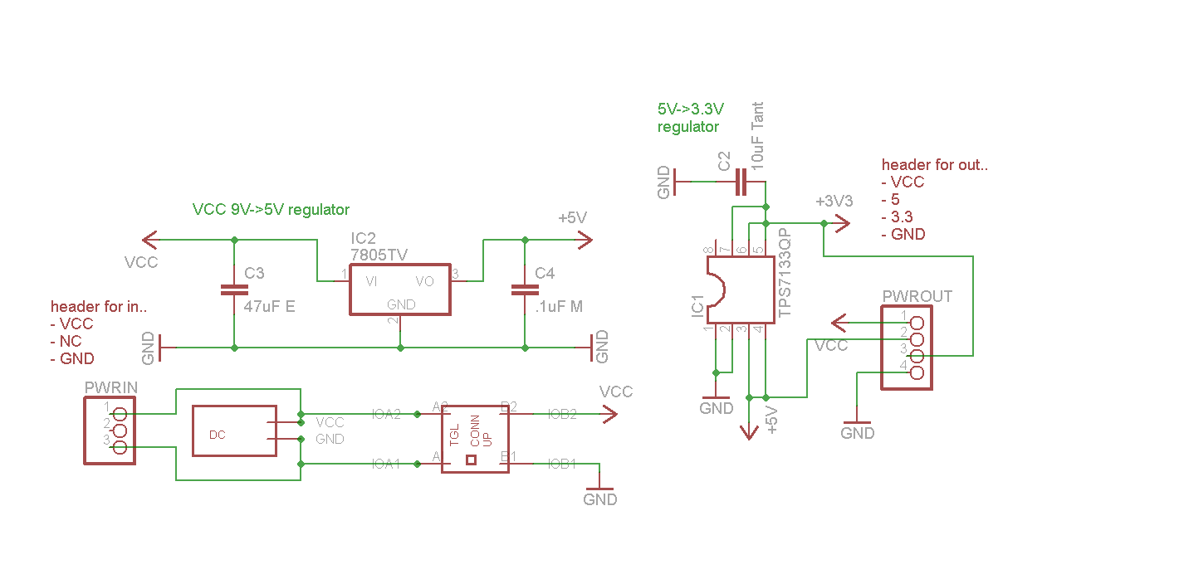
zik80/schem/zik80-base-pwr-001.png
