skeezix/zikzak/zik80/schem/zik80-gpu-pcb-002.png

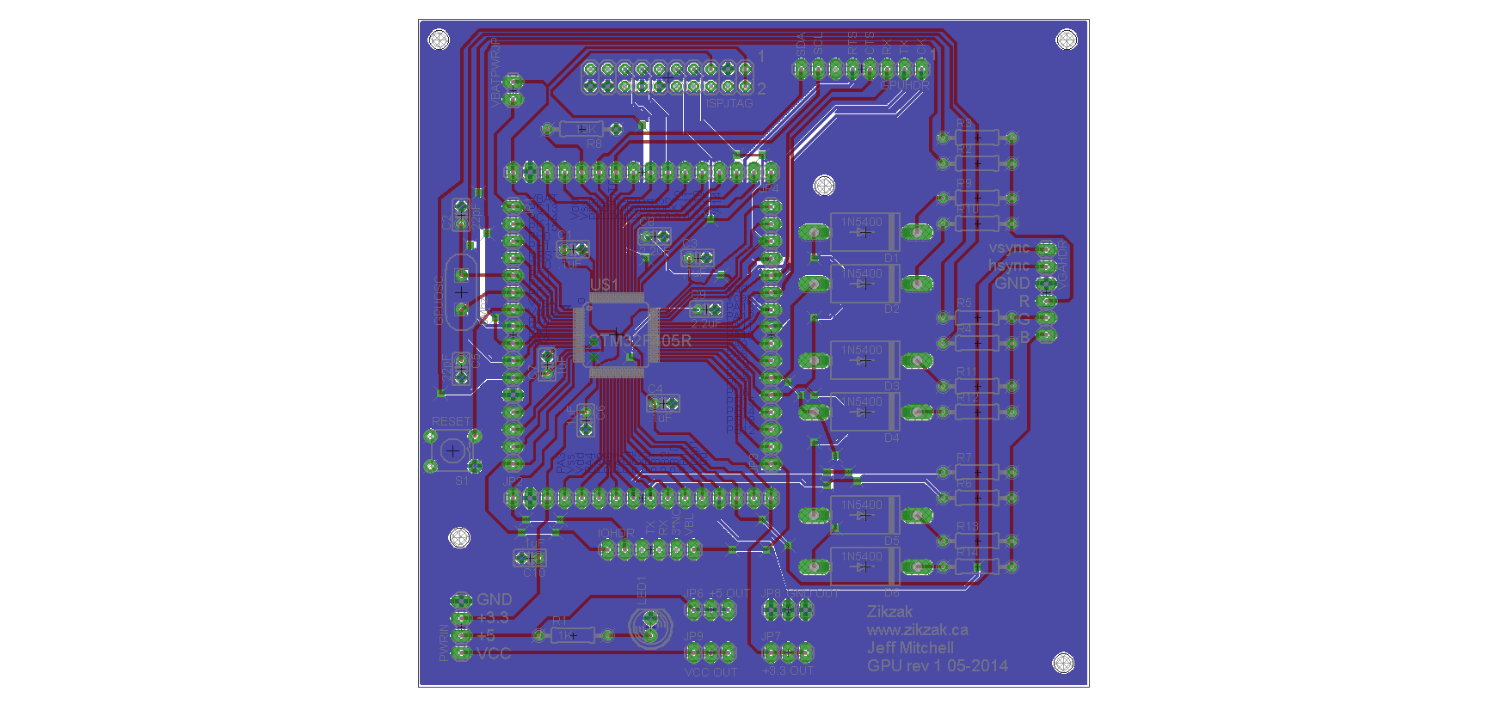
zik80/schem/zik80-gpu-pcb-002.png
