skeezix/zikzak/zik80/schem/zik80-gpu-schem-001.png

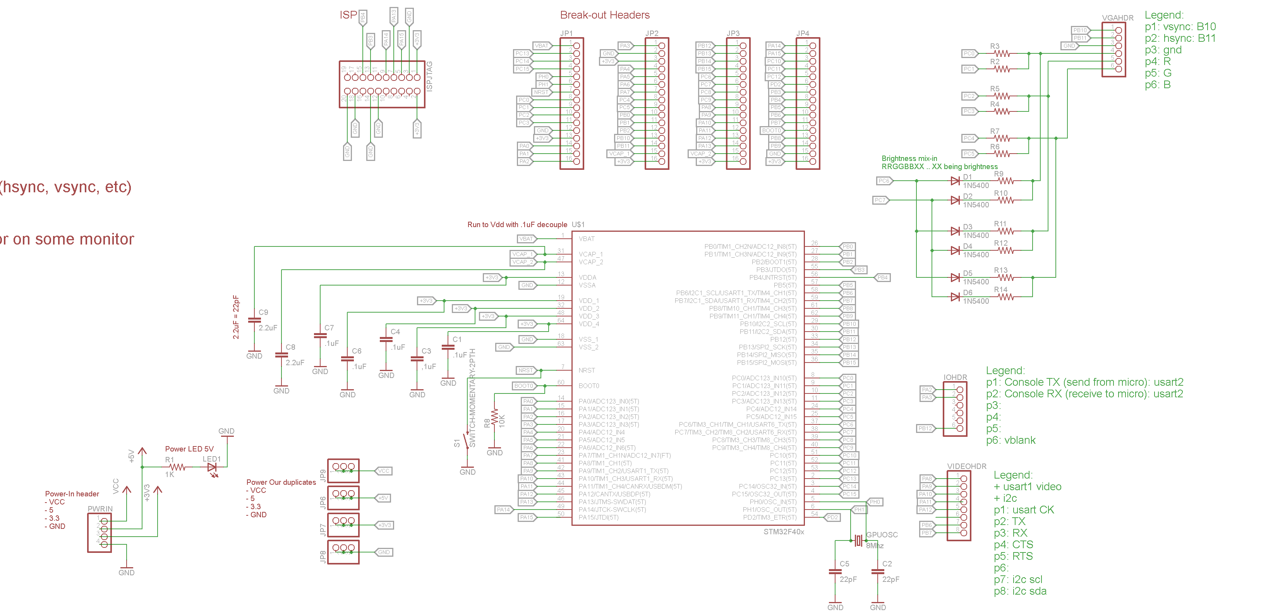
zik80/schem/zik80-gpu-schem-001.png
