skeezix/zikzak/zik80/schem/zik80-gpu-schem-002.png

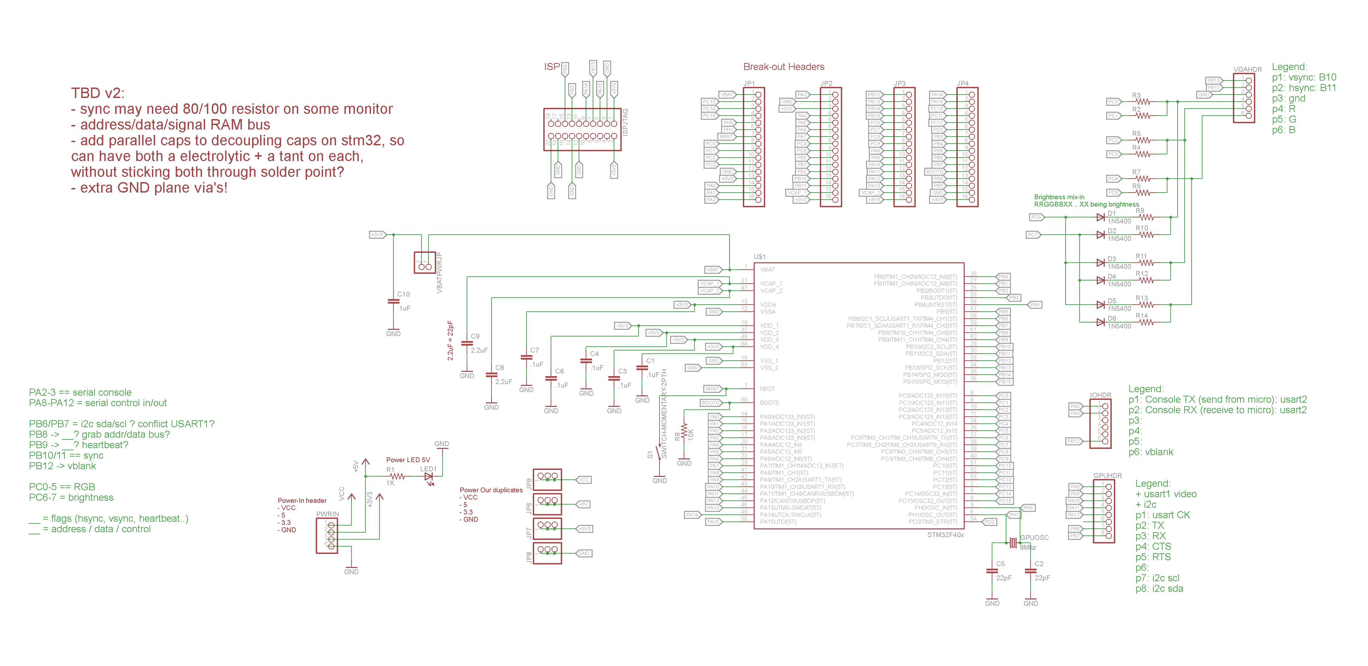
zik80/schem/zik80-gpu-schem-002.png
