skeezix/zikzak/zik80/schem/zik80-pwr-pcb-002.png

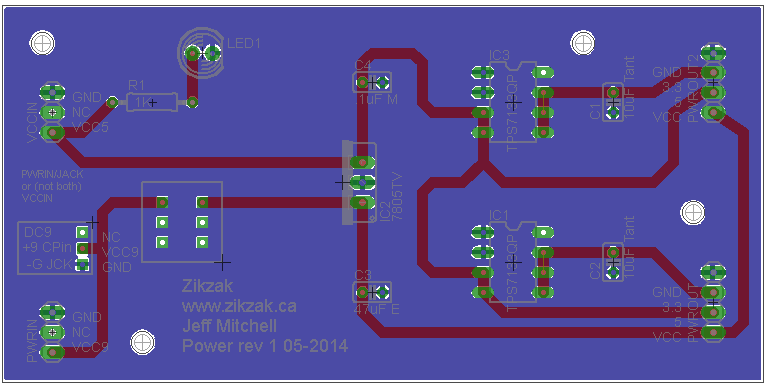
zik80/schem/zik80-pwr-pcb-002.png
