skeezix/zikzak/zik80/schem/zik80-pwr-schem-002.png

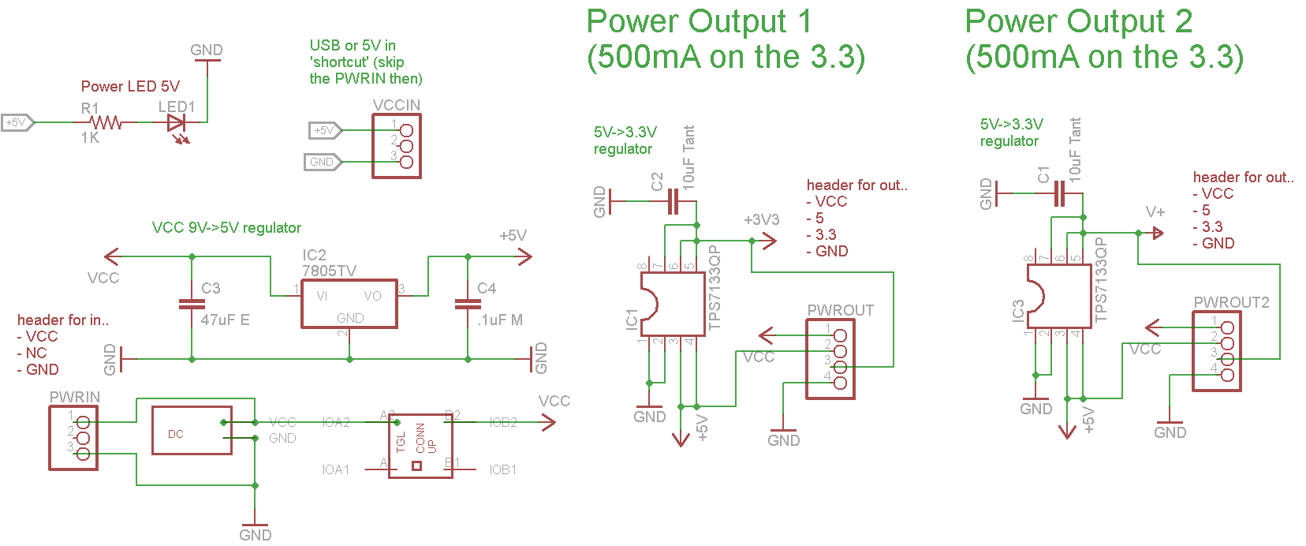
zik80/schem/zik80-pwr-schem-002.png
