skeezix/zikzak/zik80/schem/zik80-r4-audio-001.png

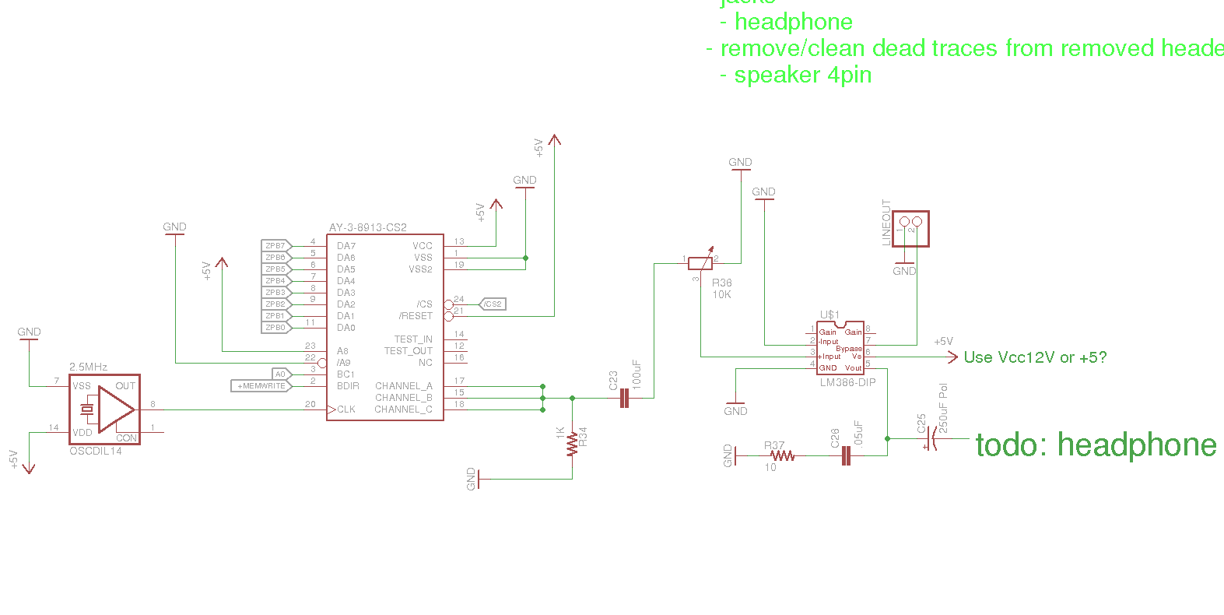
zik80/schem/zik80-r4-audio-001.png
