skeezix/zikzak/zik80/schem/zikzak-sbc-ez80stm100p-rev2.png

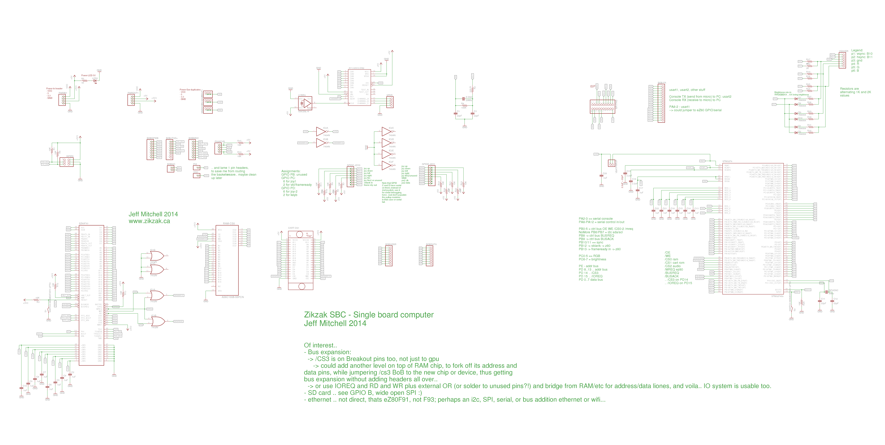
zik80/schem/zikzak-sbc-ez80stm100p-rev2.png
