skeezix/zikzak/zik80/schem/zikzak-sbc-rev3-schem.png

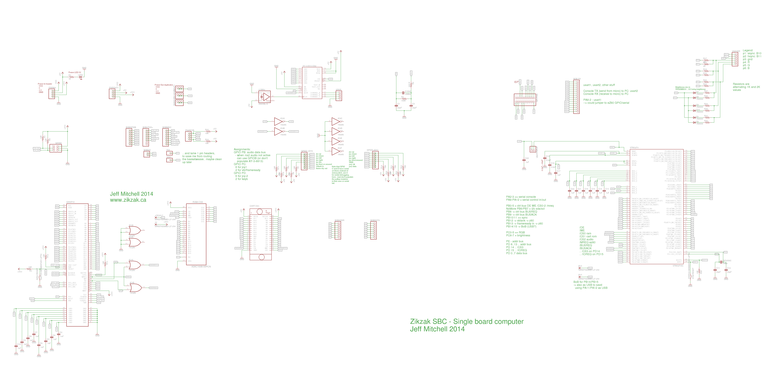
zik80/schem/zikzak-sbc-rev3-schem.png
