skeezix/zikzak/zik80/schem/zok-atmega-bob-r1-001-schem.png

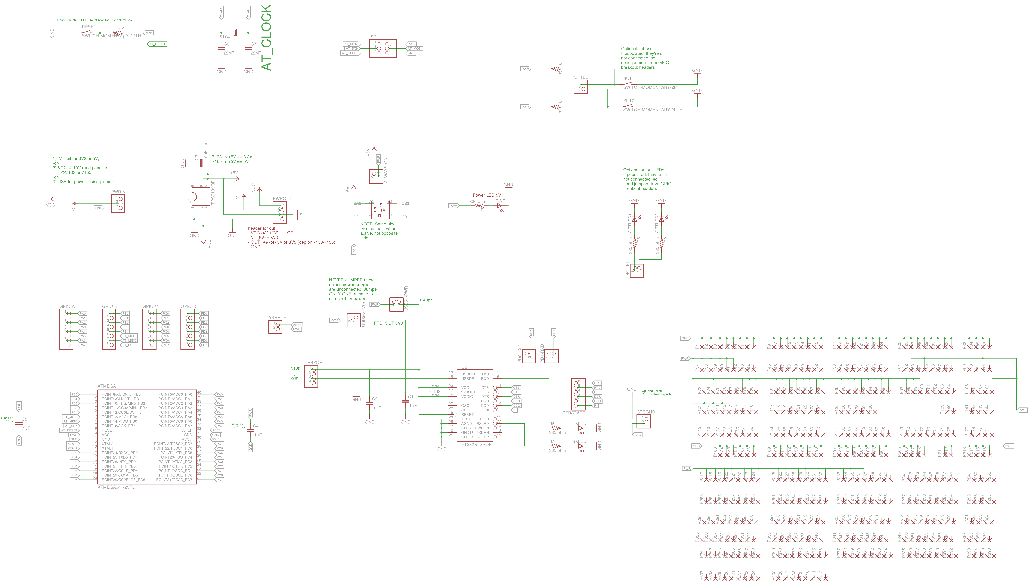
zik80/schem/zok-atmega-bob-r1-001-schem.png
