skeezix/zikzak/zik80/stm-f2-vga/stateoftheart.jpg

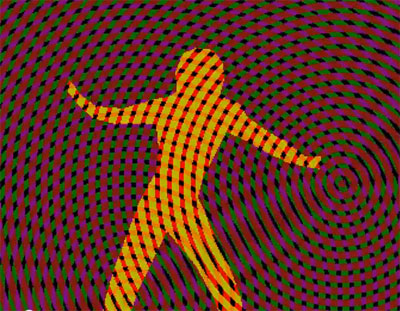
zik80/stm-f2-vga/stateoftheart.jpg
