skeezix/zikzak/zik80/zz-sbc-r3-ez80-firmware/ZDSII-Release-working-settings/Screenshot-8.png

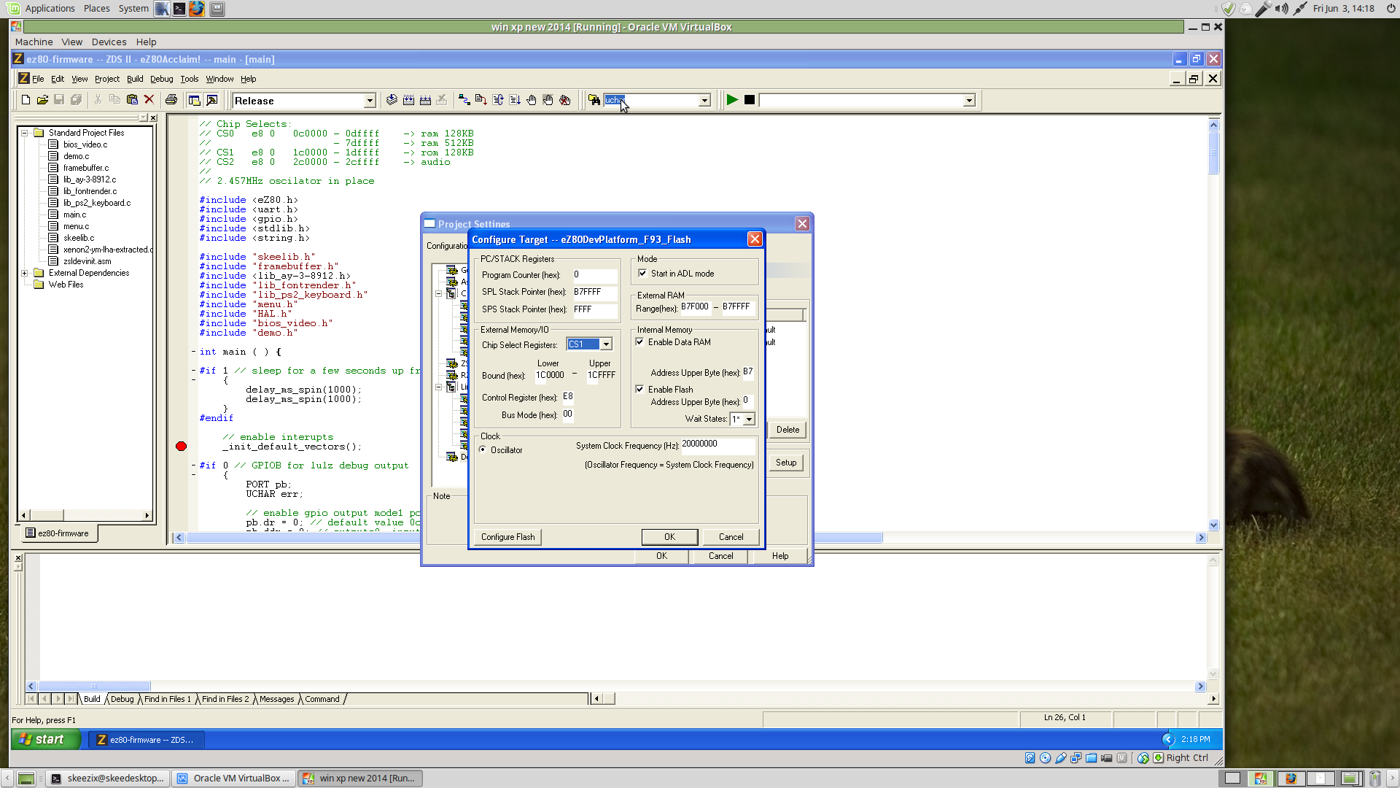
zik80/zz-sbc-r3-ez80-firmware/ZDSII-Release-working-settings/Screenshot-8.png
