skeezix/zikzak/zikcart/protocard_2x18/pics/rev1-bottom.jpg

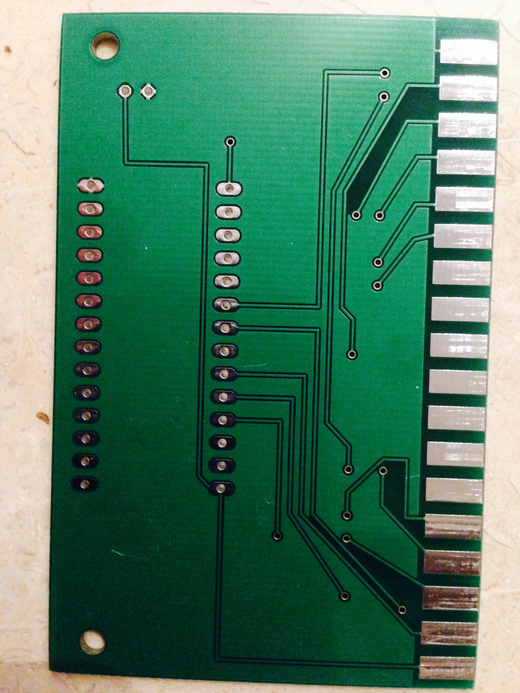
zikcart/protocard_2x18/pics/rev1-bottom.jpg
