skeezix/zikzak/zikcart/protocard_2x18/pics/rev1-top-horizontal.jpg

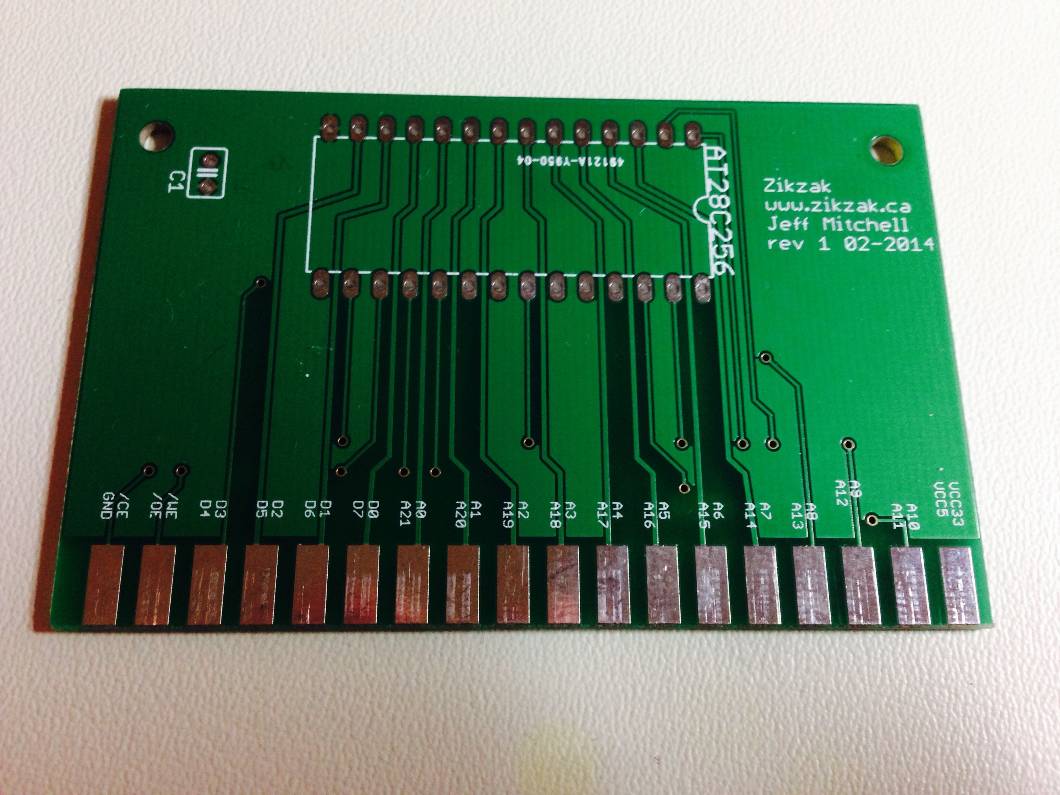
zikcart/protocard_2x18/pics/rev1-top-horizontal.jpg
