skeezix/zikzak/zikcart/protocard_2x18/pics/rev1-top.jpg

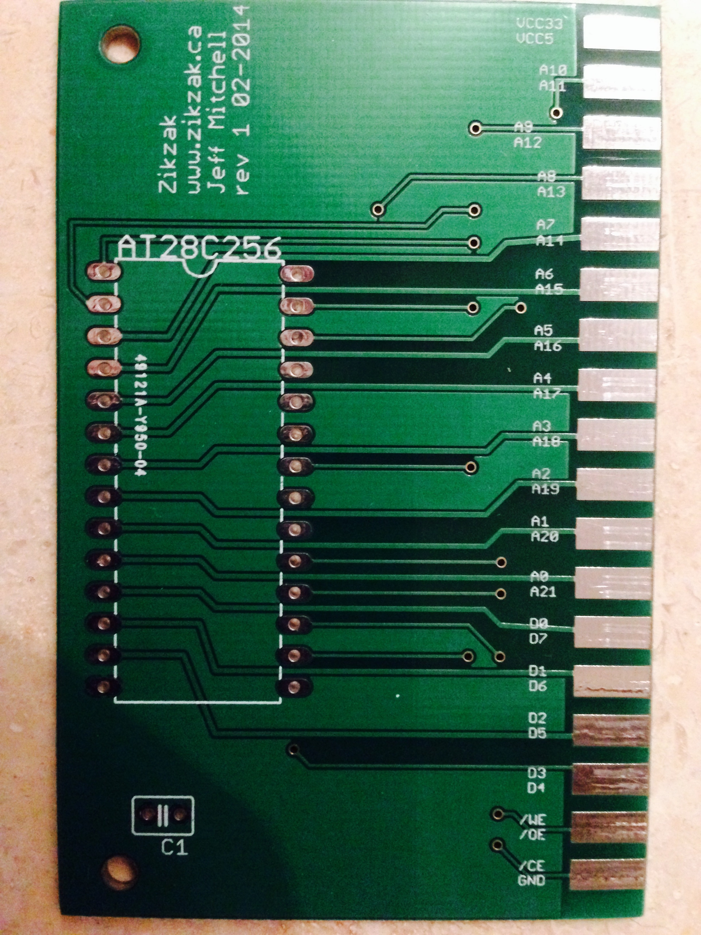
zikcart/protocard_2x18/pics/rev1-top.jpg
