skeezix/zikzak/zikcart/protocard_2x18/pinout.png

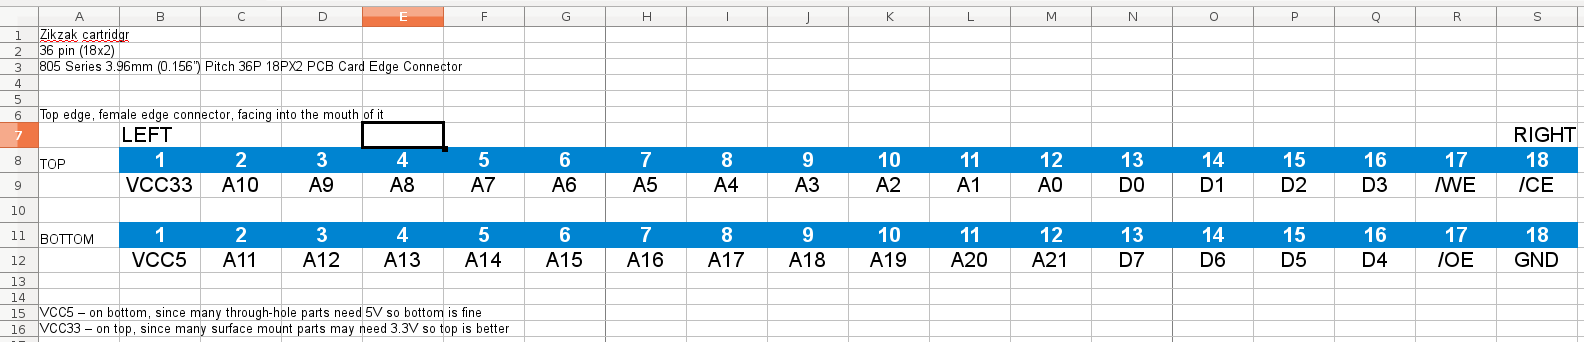
zikcart/protocard_2x18/pinout.png
