skeezix/zikzak/zikcart/protocard_2x18/zikcart/zikcart-2x18-001-brd.png

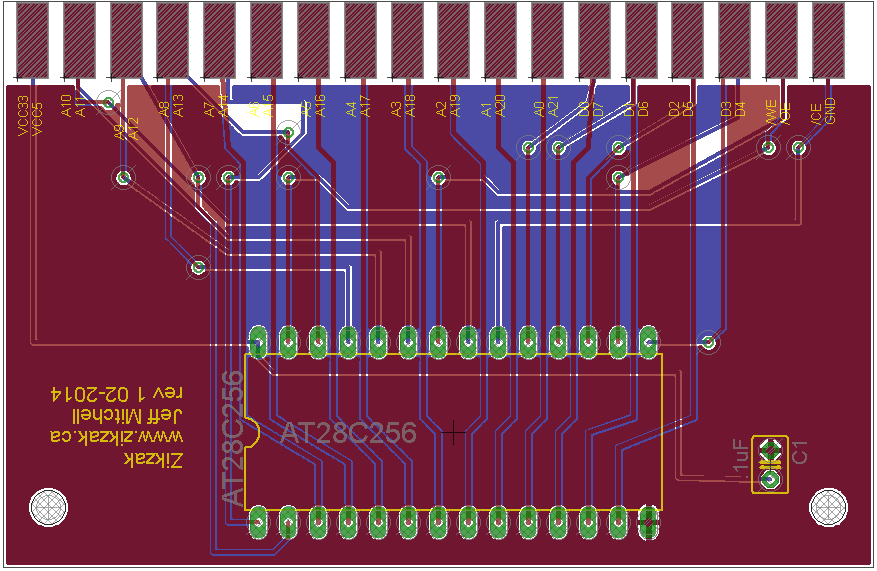
zikcart/protocard_2x18/zikcart/zikcart-2x18-001-brd.png
