skeezix/zikzak/zikzak3/zikzak3-module-gpu-board1.png

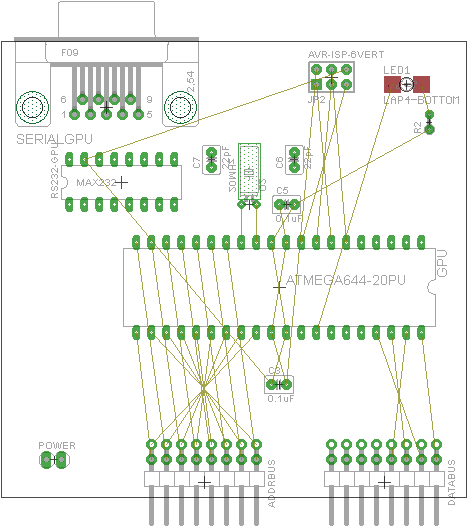
zikzak3/zikzak3-module-gpu-board1.png
