skeezix/zikzak/zikzak3/zikzak3-module-gpu-sch1.png

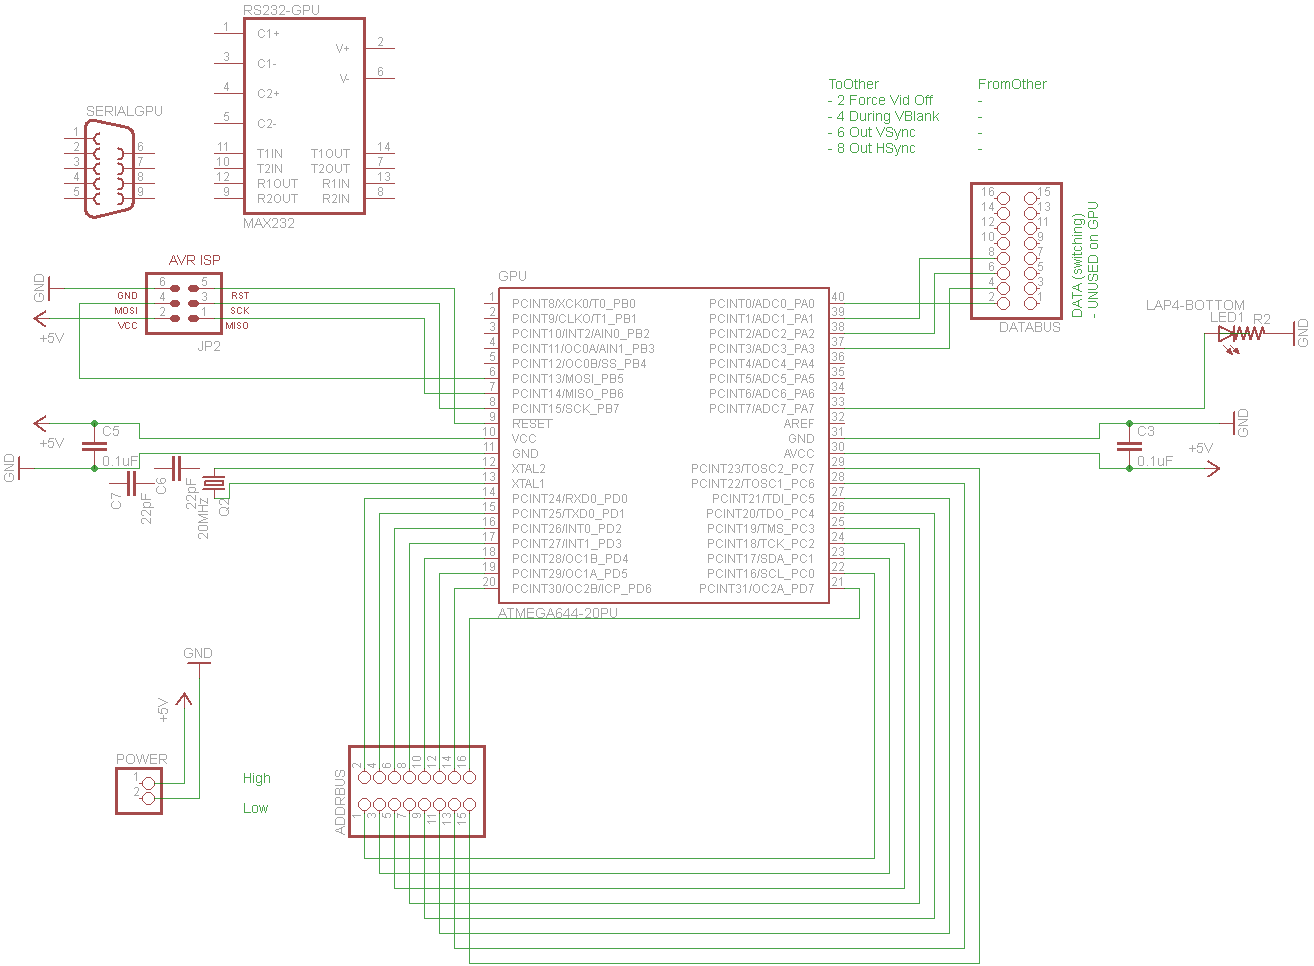
zikzak3/zikzak3-module-gpu-sch1.png
