skeezix/zikzak/zik80/parts-sources/edge-connectors-2x18p.txt

http://www.ebay.ca/itm/190836670110?ssPageName=STRK:MEWNX:IT&_trksid=p3984.m1439.l2649
805 Series 3.96mm Pitch 36P 18PX2 PCB Card Edge Connector

.156" pin spacing

seller:  sellerbible
http://www.ebay.ca/usr/sellerbible
