skeezix/zikzak/zikcase/openscad-zzr3-case-r1/export-stl/zikcase-right-bottom-front-1.stl

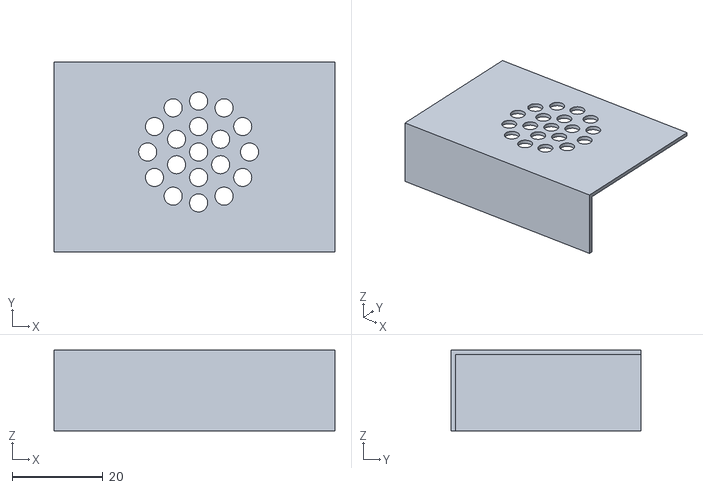
[picture p84: CAD file, 2016-05-27]
zikcase/openscad-zzr3-case-r1/export-stl/zikcase-right-bottom-front-1.stl
61.8 x 41.8 x 17.8
