skeezix/zikzak/photos/zik80/zik80-sbc-badsolder-1.jpg

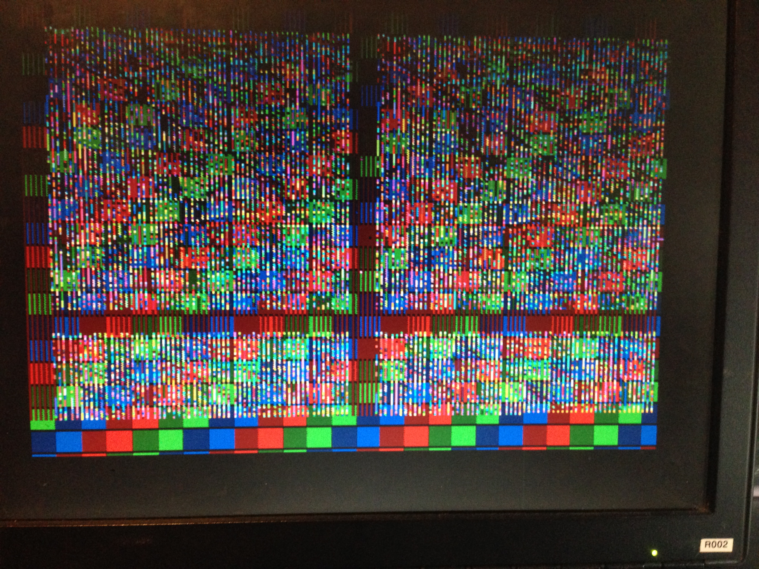
photos/zik80/zik80-sbc-badsolder-1.jpg
