skeezix/zikzak/avr-ftdi-test/README.txt

Just trying to test the FTDI FT232RL is right on Zok, so that the schematic circuit can be bounced over
to zikzak r3 shield or zz r4 design.
