skeezix/zikzak/avr-ftdi-test/zok-populated-ftdi-test-002.jpg

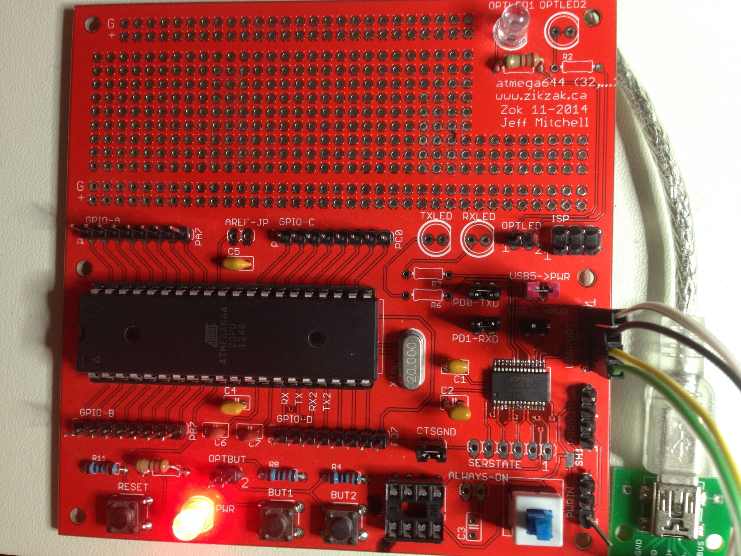
avr-ftdi-test/zok-populated-ftdi-test-002.jpg
