skeezix/zikzak/photos/zikzak_lcd_test_001.JPG

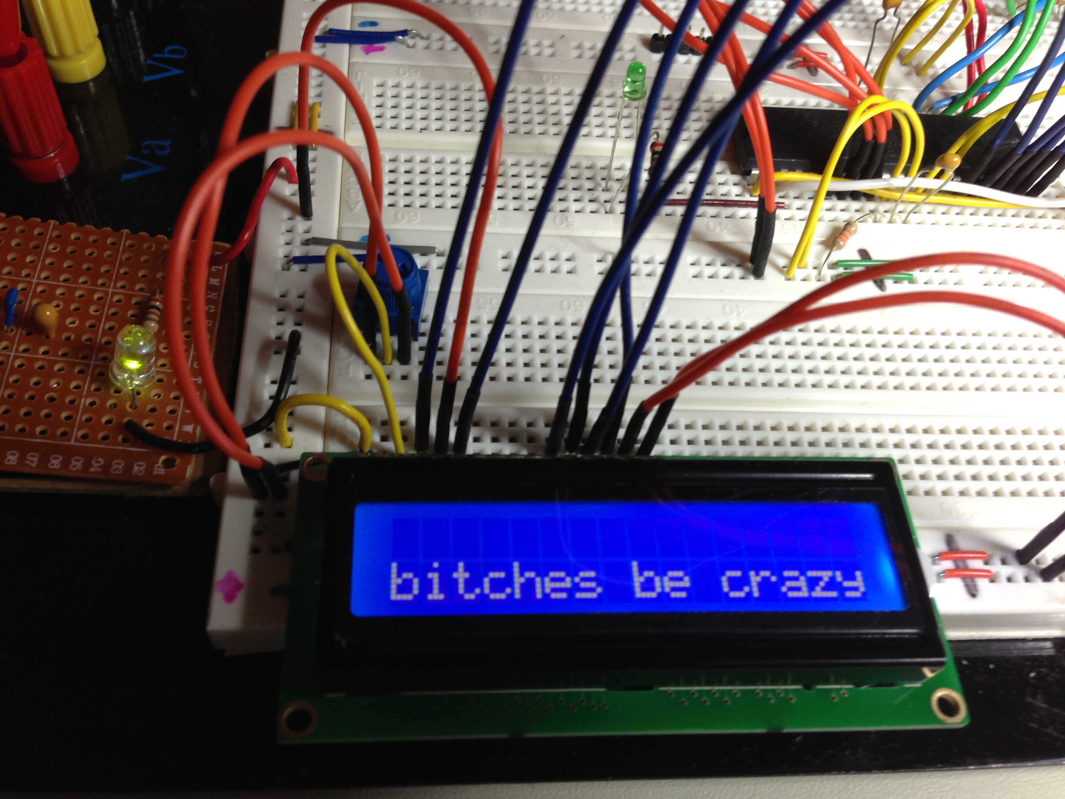
photos/zikzak_lcd_test_001.JPG
