skeezix/zikzak/zik80/schem/zik-pcb-sbc-ez80stm100p-r3-shield-r1.brd

## EAGLE design zik80/schem/zik-pcb-sbc-ez80stm100p-r3-shield-r1.brd (2016-05-17)

Schematic: zik-pcb-sbc-ez80stm100p-r3-shield-r1.sch

Parts:
3V3OUT, 5OUT: PINHD-1X3; 1X03
BARREL: DCJACKZIK
BOB-PA: PINHD-1X16; 1X16
BOBGPIOB: PINHD-1X8; 1X08
C1, C2, C13: .1uF; C025-025X050
C3: 10uF Tant; C025-025X050
C23: 100uF; C025-025X050
C25: 250uF Pol; E3,5-8
C26: .05uF; C025-025X050
CTSGND: PINHD-1X2; 1X02
FT3V3->PWR3, FT5V->PWR5: PINHD-1X2; 1X02
FTDI: FT232RLSSOP; SSOP28DB
GNDOUT: PINHD-1X3; 1X03
GPIOC-JOY0: PINHD-1X8; 1X08
GPIOD-JOY1: PINHD-1X8; 1X08
HEADPHONE: STEREOHEADPHONEJACK
JOY0, JOY1: DB9FEMALE; DB9
LINEOUT: PINHD-1X2; 1X02
PS2KEYB: PINHD-1X4; 1X04
PS/2KEYB: MINI-DIN6PTH; MINI-DIN6
PWRIN: PINHD-1X4; 1X04
PWROUT: PINHD-1X4; 1X04
R3, R6: 330 ohm; 0204/7
R34: 1K; 0204/7
R37: 10; 0204/7
RXLED: LED5MM
SERSTATE: PINHD-1X6; 1X06
SPKR: PINHD-1X4; 1X04
TPS7133: TPS7133QP; DIL08
TXLED: LED5MM
U$2: MICROSD10
U$3: 10K; POTWHEEL
U$6: LM386-DIP; LM386-DIP8
USBDATA: PINHD-1X5; 1X05
USBGPU: USBMICRO_20329; 4UCONN_20329
USBPORT: PINHD-1X4; 1X04
USBSERPWR: USBMICRO_20329; 4UCONN_20329
VGA1: VGA-F90B; DB-15-F90+SHIELD-BIG_PADS
VGAHDR: PINHD-1X6; 1X06
ZPD0-RXD, ZPD1-TXD: PINHD-1X2; 1X02

Connections:
CTS: CTSGND.2, FTDI.11 (CTS), SERSTATE.6
DCD: FTDI.10 (DCD), SERSTATE.2
DSR: FTDI.9 (DSR), SERSTATE.3
DTR: FTDI.2 (DTR), SERSTATE.4
FTDI3: C1.1, FT3V3->PWR3.1, FTDI.17 (3V3OUT)
GND: BARREL.JACKET (GND), C1.2, C2.2, C3.1, C13.2, CTSGND.1, FTDI.7 (GND7), FTDI.18 (GND18), FTDI.21 (GND21), FTDI.25 (AGND), FTDI.26 (TEST), GNDOUT.1, GNDOUT.2, GNDOUT.3, HEADPHONE.SG (S), JOY0.7, JOY1.7, LINEOUT.1, PS2KEYB.2, PS/2KEYB.3, PWRIN.4, PWROUT.4, R34.2, R37.1, RXLED.K (C), SPKR.4, TPS7133.1, TPS7133.2, TXLED.K (C), U$2.P8 (SD6), U$3.P$2 (CW), U$6.2, U$6.4, USBDATA.5, USBGPU.BASE@1 (GND), USBGPU.BASE@2 (GND), USBGPU.GND, USBGPU.SPRT@1 (GND), USBGPU.SPRT@2 (GND), USBGPU.SPRT@3 (GND), USBGPU.SPRT@4 (GND), USBPORT.4, USBSERPWR.BASE@1 (GND), USBSERPWR.BASE@2 (GND), USBSERPWR.GND, USBSERPWR.SPRT@1 (GND), USBSERPWR.SPRT@2 (GND), USBSERPWR.SPRT@3 (GND), USBSERPWR.SPRT@4 (GND), VGA1.5 (GND), VGA1.6 (VGA-R-), VGA1.7 (VGA-G-), VGA1.8 (VGA-B-), VGA1.10 (GND), VGAHDR.3
unnamed: C23.2, U$3.P$3 (CCW)
unnamed: U$3.P$1 (LO), U$6.3
unnamed: LINEOUT.2, U$6.7
unnamed: R6.2, TXLED.A
unnamed: C23.1, R34.1, SPKR.1, SPKR.2, SPKR.3
unnamed: FTDI.23 (TXLED), R6.1
unnamed: R3.2, RXLED.A
unnamed: FTDI.22 (RXLED), R3.1
unnamed: FTDI.1 (TXD), ZPD1-TXD.1
unnamed: FTDI.5 (RXD), ZPD0-RXD.1
unnamed: C25.+, C26.2, U$6.5
unnamed: C25.-, HEADPHONE.R, HEADPHONE.T
unnamed: C26.1, R37.2
PWR3: 3V3OUT.1, 3V3OUT.2, 3V3OUT.3, C3.2, FT3V3->PWR3.2, PWRIN.3, PWROUT.3, TPS7133.5, TPS7133.6, TPS7133.7, U$2.P6 (SD4)
PWR5: 5OUT.1, 5OUT.2, 5OUT.3, BARREL.CPIN (VCC), C13.1, FT5V->PWR5.2, JOY0.8, JOY1.8, PS2KEYB.3, PS/2KEYB.4, PWRIN.2, PWROUT.2, TPS7133.3, TPS7133.4, U$6.6, USBDATA.1, USBGPU.VBUS, VGA1.9 (+5V)
RI: FTDI.6 (RI), SERSTATE.1
RTS: FTDI.3 (RTS), SERSTATE.5
SB: VGA1.3 (VGA-B), VGAHDR.6
SG: VGA1.2 (VGA-G), VGAHDR.5
SH: VGA1.13 (VGA-HSYNC), VGAHDR.2
SPA0: BOB-PA.1
SPA10: BOB-PA.11, USBDATA.4, USBGPU.ID
SPA11: BOB-PA.12, USBDATA.2, USBGPU.D-
SPA12: BOB-PA.13, USBDATA.3, USBGPU.D+
SR: VGA1.1 (VGA-R), VGAHDR.4
SV: VGA1.14 (VGA-VSYNC), VGAHDR.1
USB5: C2.1, FT5V->PWR5.1, FTDI.4 (VCCIO), FTDI.19 (RESET), FTDI.20 (VCC), USBPORT.1, USBSERPWR.VBUS
USB_D+: FTDI.15 (USBDP), USBPORT.3, USBSERPWR.D+
USB_D-: FTDI.16 (USBDM), USBPORT.2, USBSERPWR.D-
VCC: PWRIN.1, PWROUT.1
ZPB0: BOBGPIOB.1
ZPB2-SS: BOB-PA.5, BOBGPIOB.3, U$2.P4 (SD2)
ZPB3-SCK: BOB-PA.6, BOBGPIOB.4, U$2.P7 (SD5)
ZPB6-MISO: BOB-PA.7, BOBGPIOB.7, U$2.P9 (SD7)
ZPB7-MOSI: BOB-PA.8, BOBGPIOB.8, U$2.P5 (SD3)
ZPC0: GPIOC-JOY0.1, JOY0.5
ZPC1: GPIOC-JOY0.2, JOY0.4
ZPC2: GPIOC-JOY0.3, JOY0.3
ZPC3: GPIOC-JOY0.4, JOY0.2
ZPC4: GPIOC-JOY0.5, JOY0.9
ZPC5: GPIOC-JOY0.6
ZPC6: GPIOC-JOY0.7
ZPC7: GPIOC-JOY0.8
ZPD0: GPIOD-JOY1.1, JOY1.5, ZPD0-RXD.2
ZPD1: GPIOD-JOY1.2, JOY1.4, ZPD1-TXD.2
ZPD2: GPIOD-JOY1.3, JOY1.3
ZPD3: GPIOD-JOY1.4, JOY1.2
ZPD4: GPIOD-JOY1.5, JOY1.9
ZPD5: GPIOD-JOY1.6
ZPD6: GPIOD-JOY1.7
ZPD6_DATA: PS2KEYB.4, PS/2KEYB.1
ZPD7: GPIOD-JOY1.8
ZPD7_CLK: PS2KEYB.1, PS/2KEYB.5

Notes on the sheet:
Optional force CTS to always (gnd)
VBUS D- D+ GND
USB 5V
FTDI OUT 3V3
- NEVER JUMPER enable these unless barrel power jack or headers are unconnected! - Jumper 5V to feed the board from USB (including TPS) - Jump 3V to enable FTDI to feed board; do not do this if TPS7133 is populated
5V->3.3V regulator
header for out.. - VCC - 5 - 3.3 - GND
Power Block
Use Vcc12V or +5?
Audio Amp
Powering PCB Notes
One of: - USB jack, then jumper enable 5v (populated TPS7133) - USB jack, jumper enable 5v and 3v3v (unpopulated TPS7133); pray FTDI can supply enough amp on 3V line - Barrel jack with 5V input brick (populated TPS7133) .. needs TPS - PWRIN header with VCC, 5V, 3V3, GND (unpopulated TPS7133) .. cir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
VCC 5V 3V3 GND
joy up (z80 tx0) joy down (zip rx0) joy left joy right joy fire GND (unused i think actually) ps2 clk ps2 data
joy up joy down joy left joy right joy fire unused I think vblank in frame rdy out
FTDI TX -> mcu RX
FTDI RX -> mcu TX
OTG_FS_ID OTG_FS_DM OTG_FS_DP
Schem pins not same order as physical jack pin order
Checked - ZZ hdr to jack pcb - PS/2 keyb ... ok - SD slot seems okay - JOY0 seems ok - JOY1 seems ok - USB PWR seem ok - USB Data seem ok - vga seems ok - pot wheel seems ok - Barrel ? unchecked, not relevent; probably right, and can specify polarity on male side eventually - headphone .. should be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
SPA4 SPI1 NSS SPA5 SPI1 SCK SPA6 SPI1 MISO SPA7 SPI1 MOSI
NOTE: This connects STM32 SPI1 to eZ80 SPI .. both are GPIO, so one or both side should be highZ mode!
Legend: p1: vsync: B10 p2: hsync: B11 p3: gnd p4: R p5: G p6: B
Should p9 be + or GND? It _can_ power PNP chip in monitor (or monitor can self power.) If monitor self powers and its gnd on board, short wipes board. If pwr on board and or monitor, will monitor handle PNP chip without SPI on cable? Have to assume yes. So we should either not connect the pin at al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
NOTE: SD from eZ80 was added later and can conflict with audio. SD activity shouldn't bother audio but possibly audio will fight with SD..
V+ D- D+ ID GND

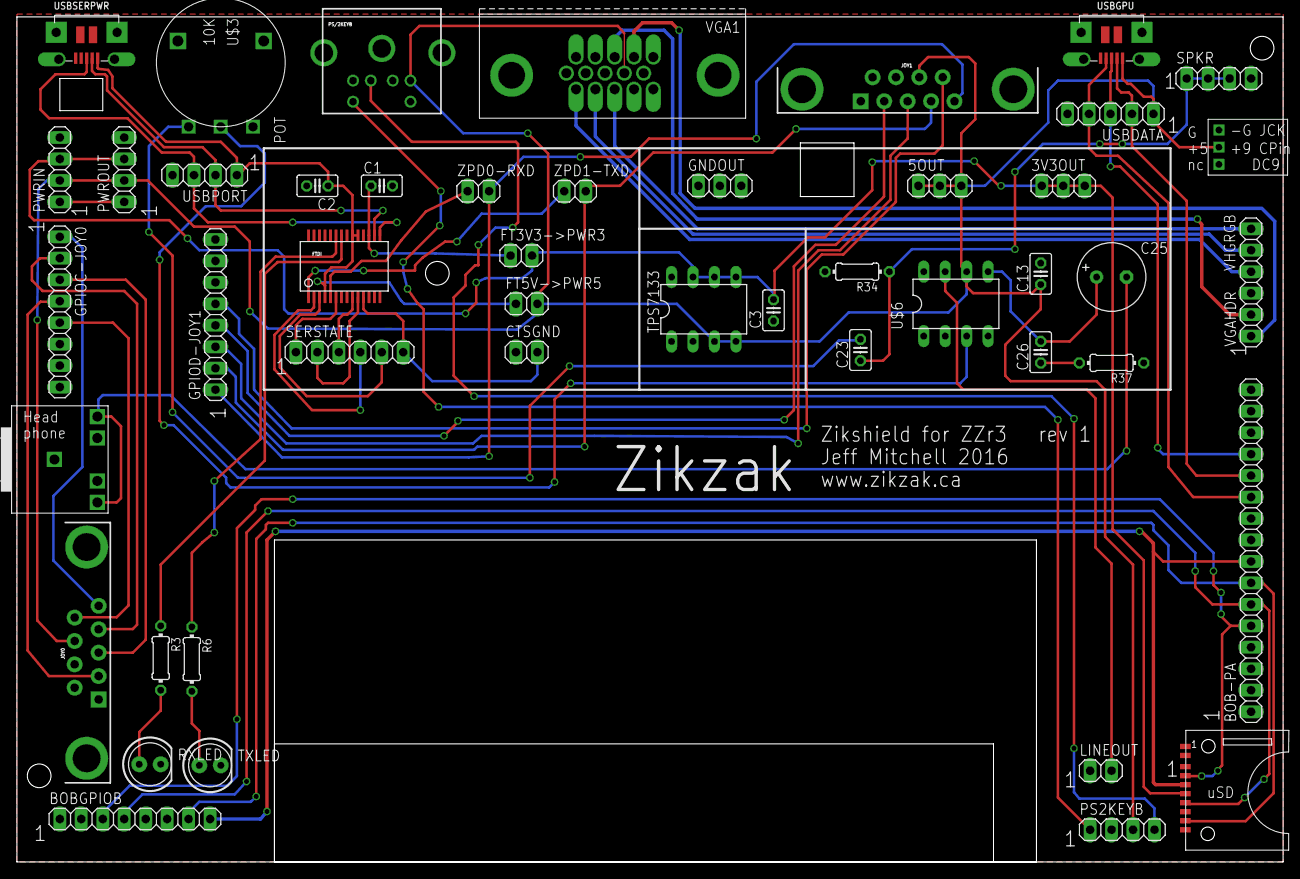
[picture p89: board zik-pcb-sbc-ez80stm100p-r3-shield-r1.brd from above]

Board: 2 copper layers, 149.8 x 100.0 mm, 47 parts (0 on the bottom side), 51 nets.
