skeezix/zikzak/zik80/schem/zok-atmega644-bob.brd

## EAGLE design zik80/schem/zok-atmega644-bob.brd (2014-11-25)

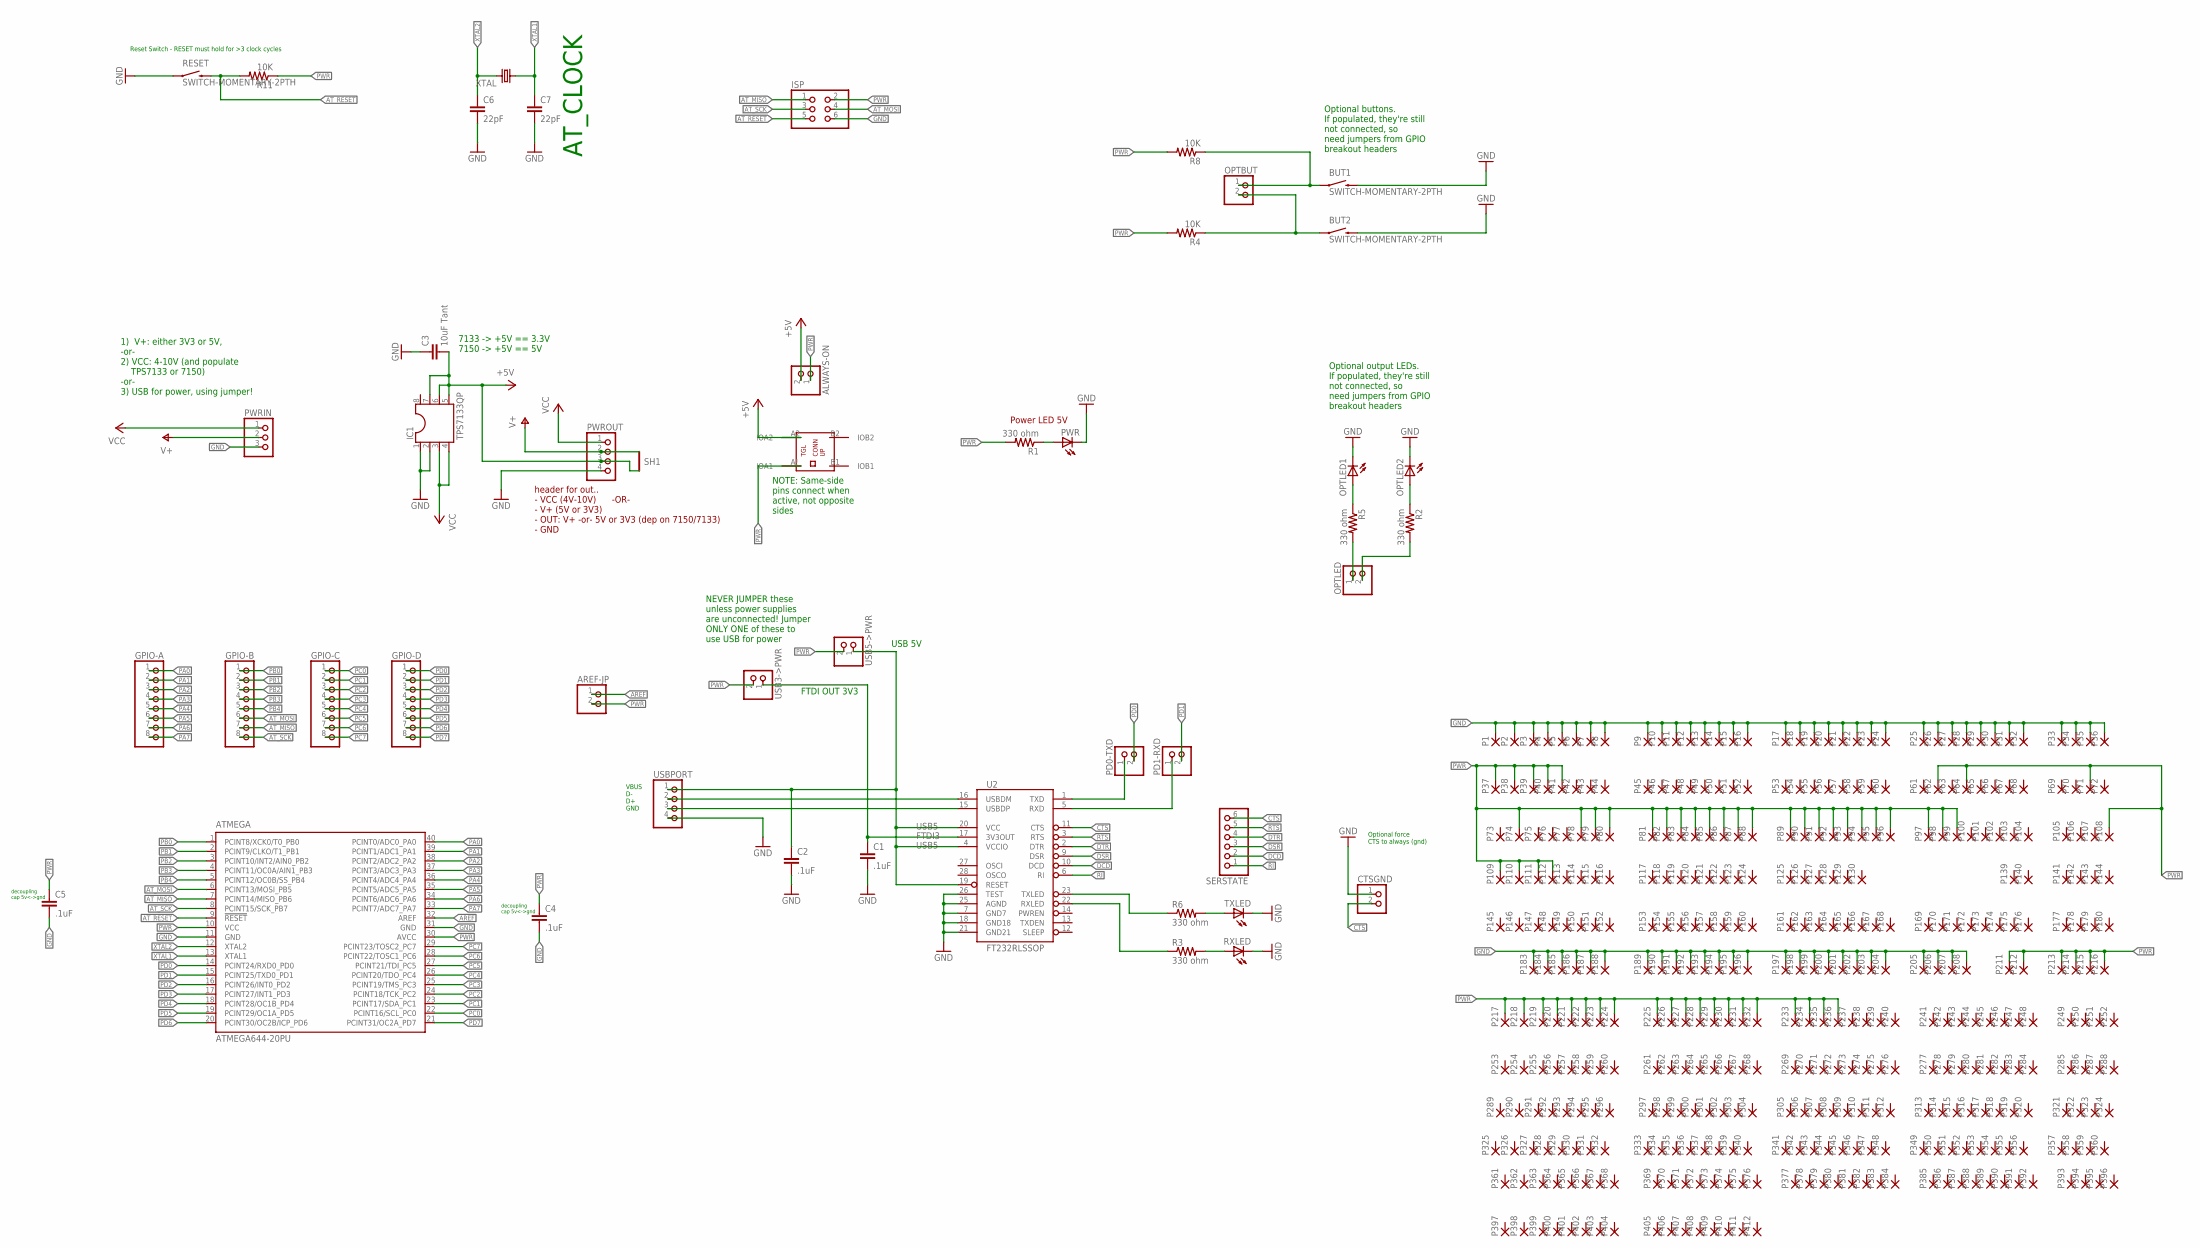
[picture p100: schematic zok-atmega644-bob.sch]

Parts:
ALWAYS-ON: PINHD-1X2; 1X02
AREF-JP: PINHD-1X2; 1X02
ATMEGA: ATMEGA644-20PU; DIL40
BUT1, BUT2: SWITCH-MOMENTARY-2PTH; TACTILE-PTH
C1, C2, C4, C5: .1uF; C025-025X050
C3: 10uF Tant; C025-025X050
C6, C7: 22pF; C025-025X050
CTSGND: PINHD-1X2; 1X02
GPIO-A: PINHD-1X8; 1X08
GPIO-B: PINHD-1X8; 1X08
GPIO-C: PINHD-1X8; 1X08
GPIO-D: PINHD-1X8; 1X08
IC1: TPS7133QP; DIL08
ISP: PINHD-2X3; 2X03
OPTBUT: PINHD-1X2; 1X02
OPTLED: PINHD-1X2; 1X02
OPTLED1, OPTLED2: LED5MM
P1, P2, P3, P4, P5, P6, P7, P8, P9, P10, P11, P12, P13, P14, P15, P16, P17, P18, P19, P20, P21, P22, P23, P24, P25, P26, P27, P28, P29, P30, P31, P32, P33, P34, P35, P36, P37, P38, P39, P40, P41, P42, P43, P44, P45, P46, P47, P48, P49, P50, P51, P52, P53, P54, P55, P56, P57, P58, P59, P60, P61, P62, P63, P64, P65, P66, P67, P68, P69, P70, P71, P72, P73, P74, P75, P76, P77, P78, P79, P80, P81, P82, P83, P84, P85, P86, P87, P88, P89, P90, P91, P92, P93, P94, P95, P96, P97, P98, P99, P100, P101, P102, P103, P104, P105, P106, P107, P108, P109, P110, P111, P112, P113, P114, P115, P116, P117, P118, P119, P120, P121, P122, P123, P124, P125, P126, P127, P128, P129, P130, P139, P140, P141, P142, P143, P144, P145, P146, P147, P148, P149, P150, P151, P152, P153, P154, P155, P156, P157, P158, P159, P160, P161, P162, P163, P164, P165, P166, P167, P168, P169, P170, P171, P172, P173, P174, P175, P176, P177, P178, P179, P180, P183, P184, P185, P186, P187, P188, P189, P190, P191, P192, P193, P194, P195, P196, P197, P198, P199, P200, P201, P202, P203, P204, P205, P206, P207, P208, P211, P212, P213, P214, P215, P216, P217, P218, P219, P220, P221, P222, P223, P224, P225, P226, P227, P228, P229, P230, P231, P232, P233, P234, P235, P236, P237, P238, P239, P240, P241, P242, P243, P244, P245, P246, P247, P248, P249, P250, P251, P252, P253, P254, P255, P256, P257, P258, P259, P260, P261, P262, P263, P264, P265, P266, P267, P268, P269, P270, P271, P272, P273, P274, P275, P276, P277, P278, P279, P280, P281, P282, P283, P284, P285, P286, P287, P288, P289, P290, P291, P292, P293, P294, P295, P296, P297, P298, P299, P300, P301, P302, P303, P304, P305, P306, P307, P308, P309, P310, P311, P312, P313, P314, P315, P316, P317, P318, P319, P320, P321, P322, P323, P324, P325, P326, P327, P328, P329, P330, P331, P332, P333, P334, P335, P336, P337, P338, P339, P340, P341, P342, P343, P344, P345, P346, P347, P348, P349, P350, P351, P352, P353, P354, P355, P356, P357, P358, P359, P360, P361, P362, P363, P364, P365, P366, P367, P368, P369, P370, P371, P372, P373, P374, P375, P376, P377, P378, P379, P380, P381, P382, P383, P384, P385, P386, P387, P388, P389, P390, P391, P392, P393, P394, P395, P396, P397, P398, P399, P400, P401, P402, P403, P404, P405, P406, P407, P408, P409, P410, P411, P412: 1,6/0,9
PD0-TXD, PD1-RXD: PINHD-1X2; 1X02
PWR: LED5MM
PWRIN: PINHD-1X3; 1X03
PWROUT: PINHD-1X4; 1X04
R1, R2, R3, R5, R6: 330 ohm; 0204/7
R4, R8, R11: 10K; 0204/7
RESET: SWITCH-MOMENTARY-2PTH; TACTILE-PTH
RXLED: LED5MM
SERSTATE: PINHD-1X6; 1X06
SH1: SHORT-VT5; SHORT_TOP-50
TXLED: LED5MM
U2: FT232RLSSOP; SSOP28DB
U$4: TOGGLE-CYAN-L-ZIK; TOGGLE-CYAN-LG-ZIK
USB3->PWR, USB5->PWR: PINHD-1X2; 1X02
USBPORT: PINHD-1X4; 1X04
XTAL: CRYSTALHC49S; HC49/S

Connections:
+5V: ALWAYS-ON.2, C3.2, IC1.5, IC1.6, IC1.7, PWROUT.3, SH1.1, U$4.A2 (IOA2)
AREF: AREF-JP.1, ATMEGA.32 (AREF)
AT_MISO: ATMEGA.7 (PCINT14/MISO_PB6), GPIO-B.7, ISP.1
AT_MOSI: ATMEGA.6 (PCINT13/MOSI_PB5), GPIO-B.6, ISP.4
AT_RESET: ATMEGA.9 (!RESET), ISP.5, R11.2, RESET.3 (2)
AT_SCK: ATMEGA.8 (PCINT15/SCK_PB7), GPIO-B.8, ISP.3
CTS: CTSGND.2, SERSTATE.6, U2.11 (CTS)
DCD: SERSTATE.2, U2.10 (DCD)
DSR: SERSTATE.3, U2.9 (DSR)
DTR: SERSTATE.4, U2.2 (DTR)
FTDI3: C1.1, U2.17 (3V3OUT), USB3->PWR.1
GND: ATMEGA.11 (GND), ATMEGA.31 (GND), BUT1.3 (2), BUT2.3 (2), C1.2, C2.2, C3.1, C4.2, C5.2, C6.2, C7.2, CTSGND.1, IC1.1, IC1.2, ISP.6, OPTLED1.K (C), OPTLED2.K (C), P1.1, P2.1, P3.1, P4.1, P5.1, P6.1, P7.1, P8.1, P9.1, P10.1, P11.1, P12.1, P13.1, P14.1, P15.1, P16.1, P17.1, P18.1, P19.1, P20.1, P21.1, P22.1, P23.1, P24.1, P25.1, P26.1, P27.1, P28.1, P29.1, P30.1, P31.1, P32.1, P33.1, P34.1, P35.1, P36.1, P183.1, P184.1, P185.1, P186.1, P187.1, P188.1, P189.1, P190.1, P191.1, P192.1, P193.1, P194.1, P195.1, P196.1, P197.1, P198.1, P199.1, P200.1, P201.1, P202.1, P203.1, P204.1, P205.1, P206.1, P207.1, P208.1, PWR.K (C), PWRIN.3, PWROUT.4, RESET.1, RXLED.K (C), TXLED.K (C), U2.7 (GND7), U2.18 (GND18), U2.21 (GND21), U2.25 (AGND), U2.26 (TEST), USBPORT.4
unnamed: BUT1.1, OPTBUT.1, R8.1
unnamed: BUT2.1, OPTBUT.2, R4.1
unnamed: PWR.A, R1.1
unnamed: R6.2, TXLED.A
unnamed: OPTLED.1, R5.2
unnamed: OPTLED2.A, R2.1
unnamed: OPTLED.2, R2.2
unnamed: R6.1, U2.23 (TXLED)
unnamed: OPTLED1.A, R5.1
unnamed: R3.2, RXLED.A
unnamed: R3.1, U2.22 (RXLED)
unnamed: PD0-TXD.1, U2.1 (TXD)
unnamed: PD1-RXD.1, U2.5 (RXD)
PA0: ATMEGA.40 (PCINT0/ADC0_PA0), GPIO-A.1
PA1: ATMEGA.39 (PCINT1/ADC1_PA1), GPIO-A.2
PA2: ATMEGA.38 (PCINT2/ADC2_PA2), GPIO-A.3
PA3: ATMEGA.37 (PCINT3/ADC3_PA3), GPIO-A.4
PA4: ATMEGA.36 (PCINT4/ADC4_PA4), GPIO-A.5
PA5: ATMEGA.35 (PCINT5/ADC5_PA5), GPIO-A.6
PA6: ATMEGA.34 (PCINT6/ADC6_PA6), GPIO-A.7
PA7: ATMEGA.33 (PCINT7/ADC7_PA7), GPIO-A.8
PB0: ATMEGA.1 (PCINT8/XCK0/T0_PB0), GPIO-B.1
PB1: ATMEGA.2 (PCINT9/CLKO/T1_PB1), GPIO-B.2
PB2: ATMEGA.3 (PCINT10/INT2/AIN0_PB2), GPIO-B.3
PB3: ATMEGA.4 (PCINT11/OC0A/AIN1_PB3), GPIO-B.4
PB4: ATMEGA.5 (PCINT12/OC0B/SS_PB4), GPIO-B.5
PC0: ATMEGA.22 (PCINT16/SCL_PC0), GPIO-C.1
PC1: ATMEGA.23 (PCINT17/SDA_PC1), GPIO-C.2
PC2: ATMEGA.24 (PCINT18/TCK_PC2), GPIO-C.3
PC3: ATMEGA.25 (PCINT19/TMS_PC3), GPIO-C.4
PC4: ATMEGA.26 (PCINT20/TDO_PC4), GPIO-C.5
PC5: ATMEGA.27 (PCINT21/TDI_PC5), GPIO-C.6
PC6: ATMEGA.28 (PCINT22/TOSC1_PC6), GPIO-C.7
PC7: ATMEGA.29 (PCINT23/TOSC2_PC7), GPIO-C.8
PD0: ATMEGA.14 (PCINT24/RXD0_PD0), GPIO-D.1, PD0-TXD.2
PD1: ATMEGA.15 (PCINT25/TXD0_PD1), GPIO-D.2, PD1-RXD.2
PD2: ATMEGA.16 (PCINT26/INT0_PD2), GPIO-D.3
PD3: ATMEGA.17 (PCINT27/INT1_PD3), GPIO-D.4
PD4: ATMEGA.18 (PCINT28/OC1B_PD4), GPIO-D.5
PD5: ATMEGA.19 (PCINT29/OC1A_PD5), GPIO-D.6
PD6: ATMEGA.20 (PCINT30/OC2B/ICP_PD6), GPIO-D.7
PD7: ATMEGA.21 (PCINT31/OC2A_PD7), GPIO-D.8
PWR: ALWAYS-ON.1, AREF-JP.2, ATMEGA.10 (VCC), ATMEGA.30 (AVCC), C4.1, C5.1, ISP.2, P37.1, P38.1, P39.1, P40.1, P41.1, P62.1, P64.1, P71.1, P74.1, P78.1, P79.1, P80.1, P81.1, P82.1, P83.1, P84.1, P85.1, P86.1, P87.1, P88.1, P89.1, P90.1, P91.1, P92.1, P93.1, P94.1, P95.1, P96.1, P97.1, P98.1, P99.1, P108.1, P109.1, P110.1, P111.1, P112.1, P211.1, P212.1, P213.1, P214.1, P215.1, P216.1, P217.1, P218.1, P219.1, P220.1, P221.1, P222.1, P223.1, P224.1, P225.1, P226.1, P227.1, P228.1, P229.1, P230.1, P231.1, P232.1, P233.1, P234.1, P235.1, P236.1, R1.2, R4.2, R8.2, R11.1, U$4.A! (IOA1), USB3->PWR.2, USB5->PWR.2
RI: SERSTATE.1, U2.6 (RI)
RTS: SERSTATE.5, U2.3 (RTS)
USB5: C2.1, U2.4 (VCCIO), U2.19 (RESET), U2.20 (VCC), USB5->PWR.1, USBPORT.1
USB_D+: U2.15 (USBDP), USBPORT.3
USB_D-: U2.16 (USBDM), USBPORT.2
V+: PWRIN.2, PWROUT.2, SH1.2
VCC: IC1.3, IC1.4, PWRIN.1, PWROUT.1
XTAL1: ATMEGA.13 (XTAL1), C7.1, XTAL.1
XTAL2: ATMEGA.12 (XTAL2), C6.1, XTAL.2

Notes on the sheet:
Optional force CTS to always (gnd)
header for out.. - VCC (4V-10V) -OR- - V+ (5V or 3V3) - OUT: V+ -or- 5V or 3V3 (dep on 7150/7133) - GND
1) V+: either 3V3 or 5V, -or- 2) VCC: 4-10V (and populate TPS7133 or 7150) -or- 3) USB for power, using jumper!
Power LED 5V
NOTE: Same-side pins connect when active, not opposite sides
7133 -> +5V == 3.3V 7150 -> +5V == 5V
decoupling cap 5v<->gnd
Optional output LEDs. If populated, they're still not connected, so need jumpers from GPIO breakout headers
Reset Switch - RESET must hold for >3 clock cycles
AT_CLOCK
Optional buttons. If populated, they're still not connected, so need jumpers from GPIO breakout headers
VBUS D- D+ GND
USB 5V
FTDI OUT 3V3
NEVER JUMPER these unless power supplies are unconnected! Jumper ONLY ONE of these to use USB for power

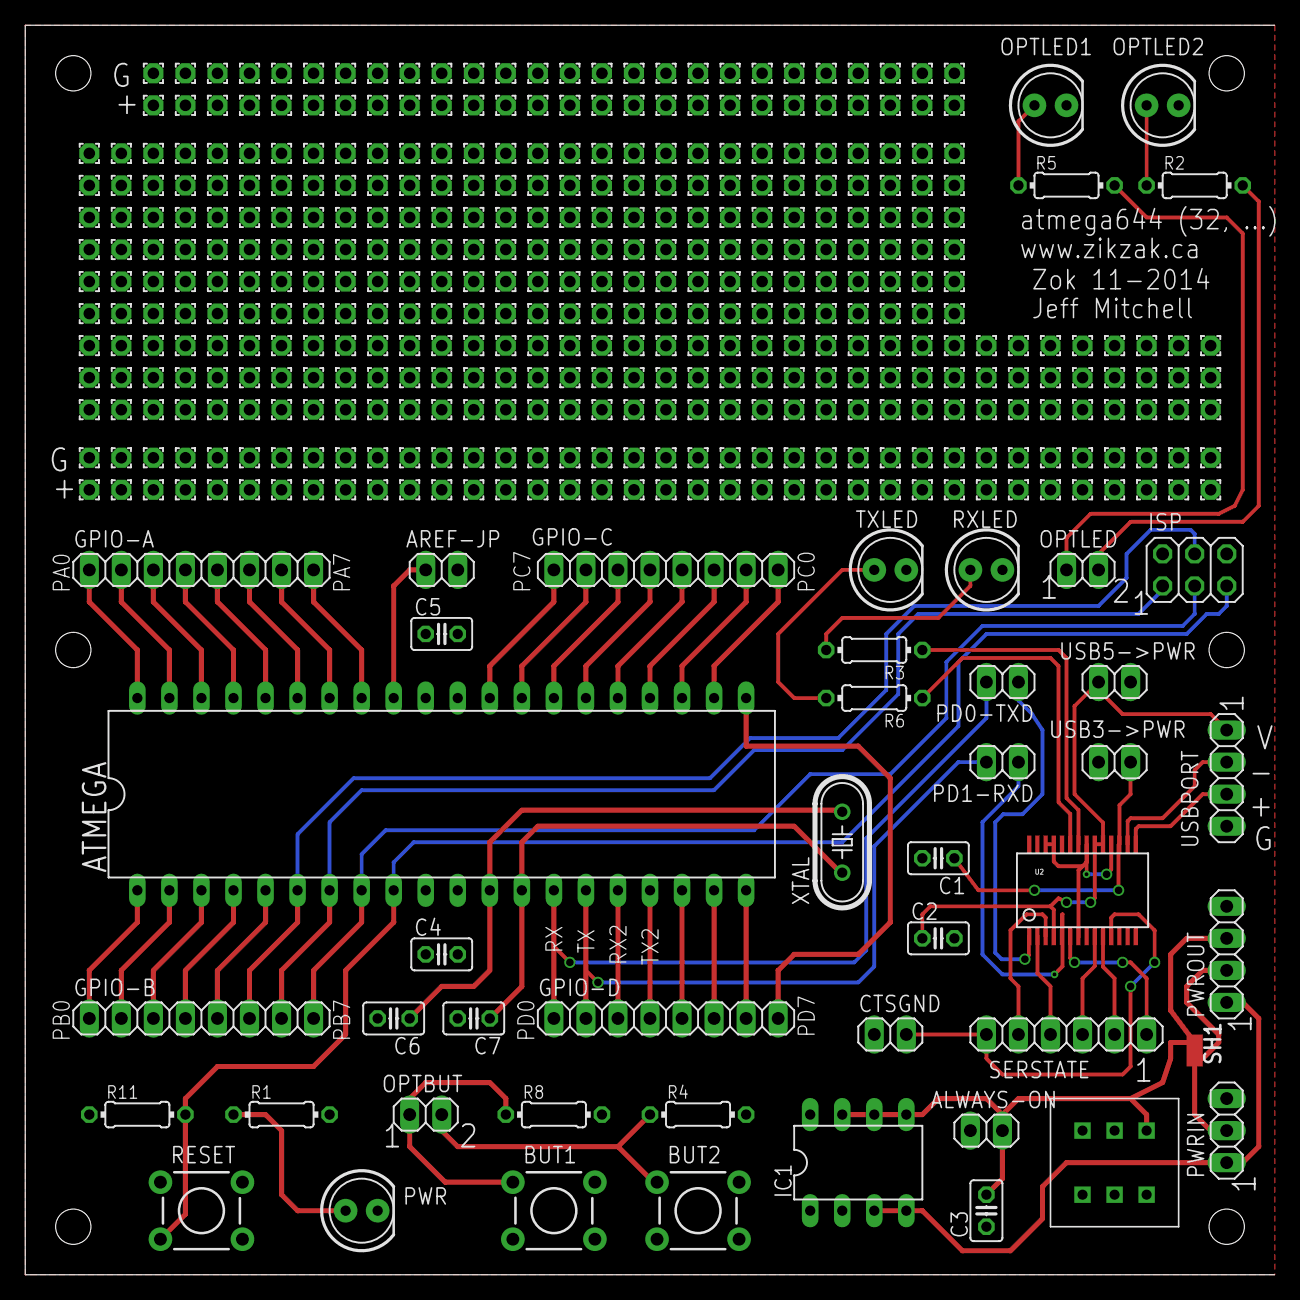
[picture p101: board zok-atmega644-bob.brd from above]

Board: 2 copper layers, 99.1 x 99.1 mm, 447 parts (0 on the bottom side), 64 nets.
