skeezix/zikzak/zik80/schem/zik-pcb-base-bussed.brd

## EAGLE design zik80/schem/zik-pcb-base-bussed.brd (2014-06-28)

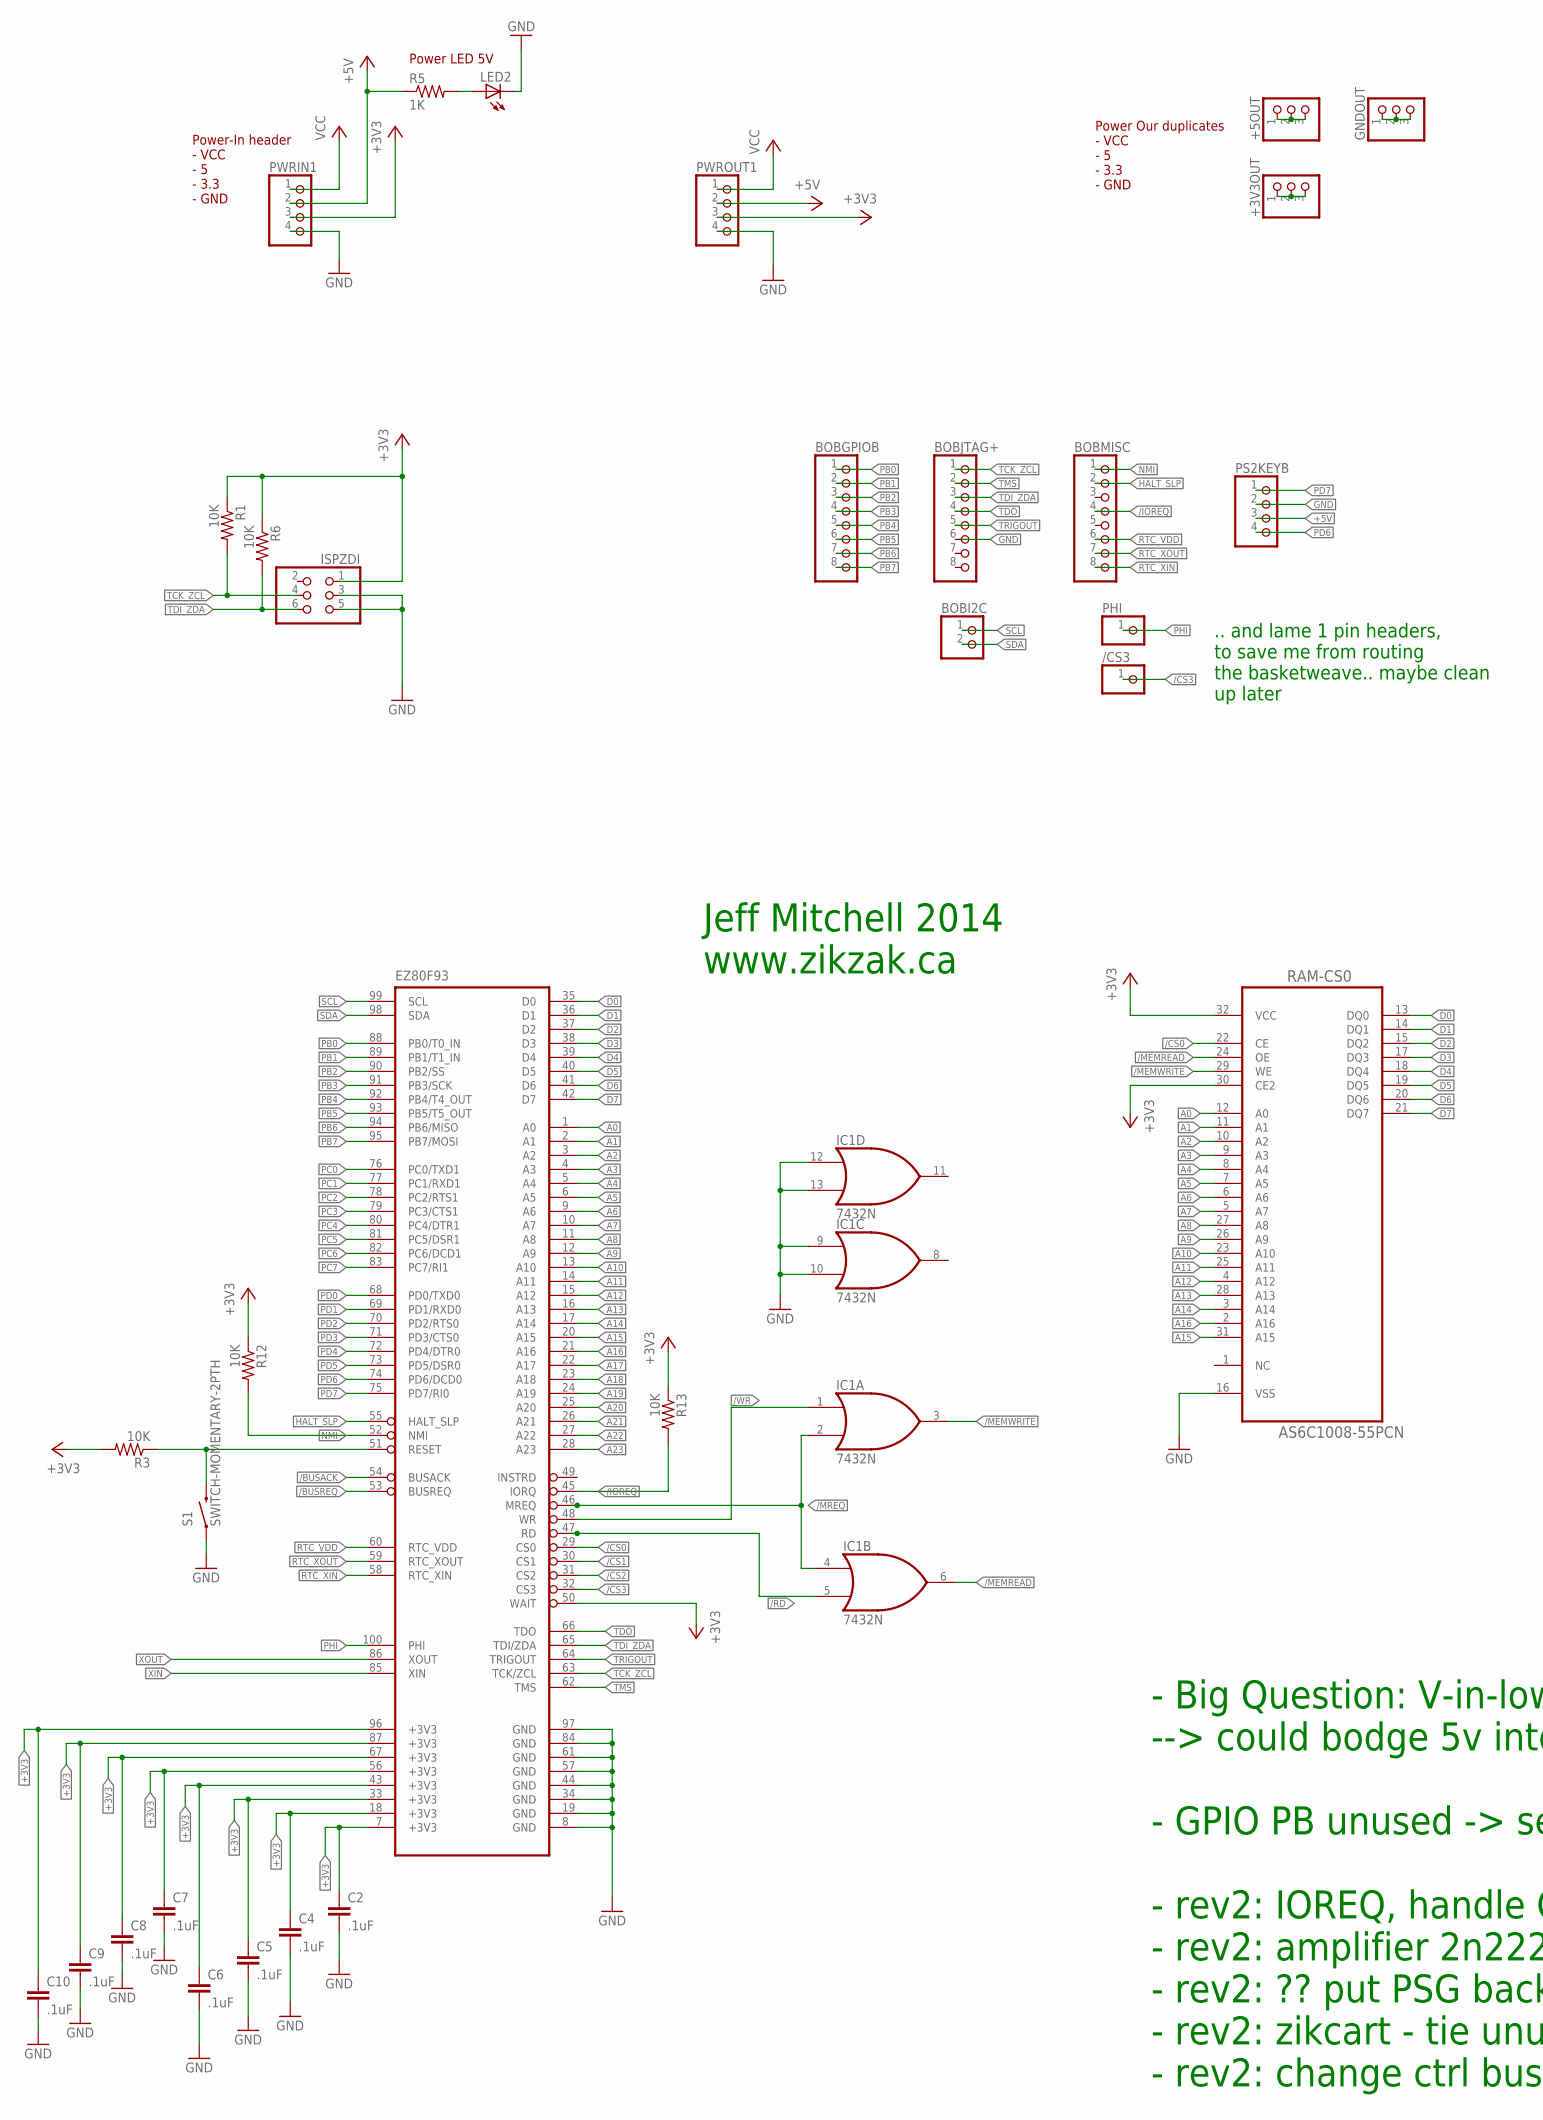
[picture p102: schematic zik-pcb-base-bussed.sch, part in row 1, column 1]

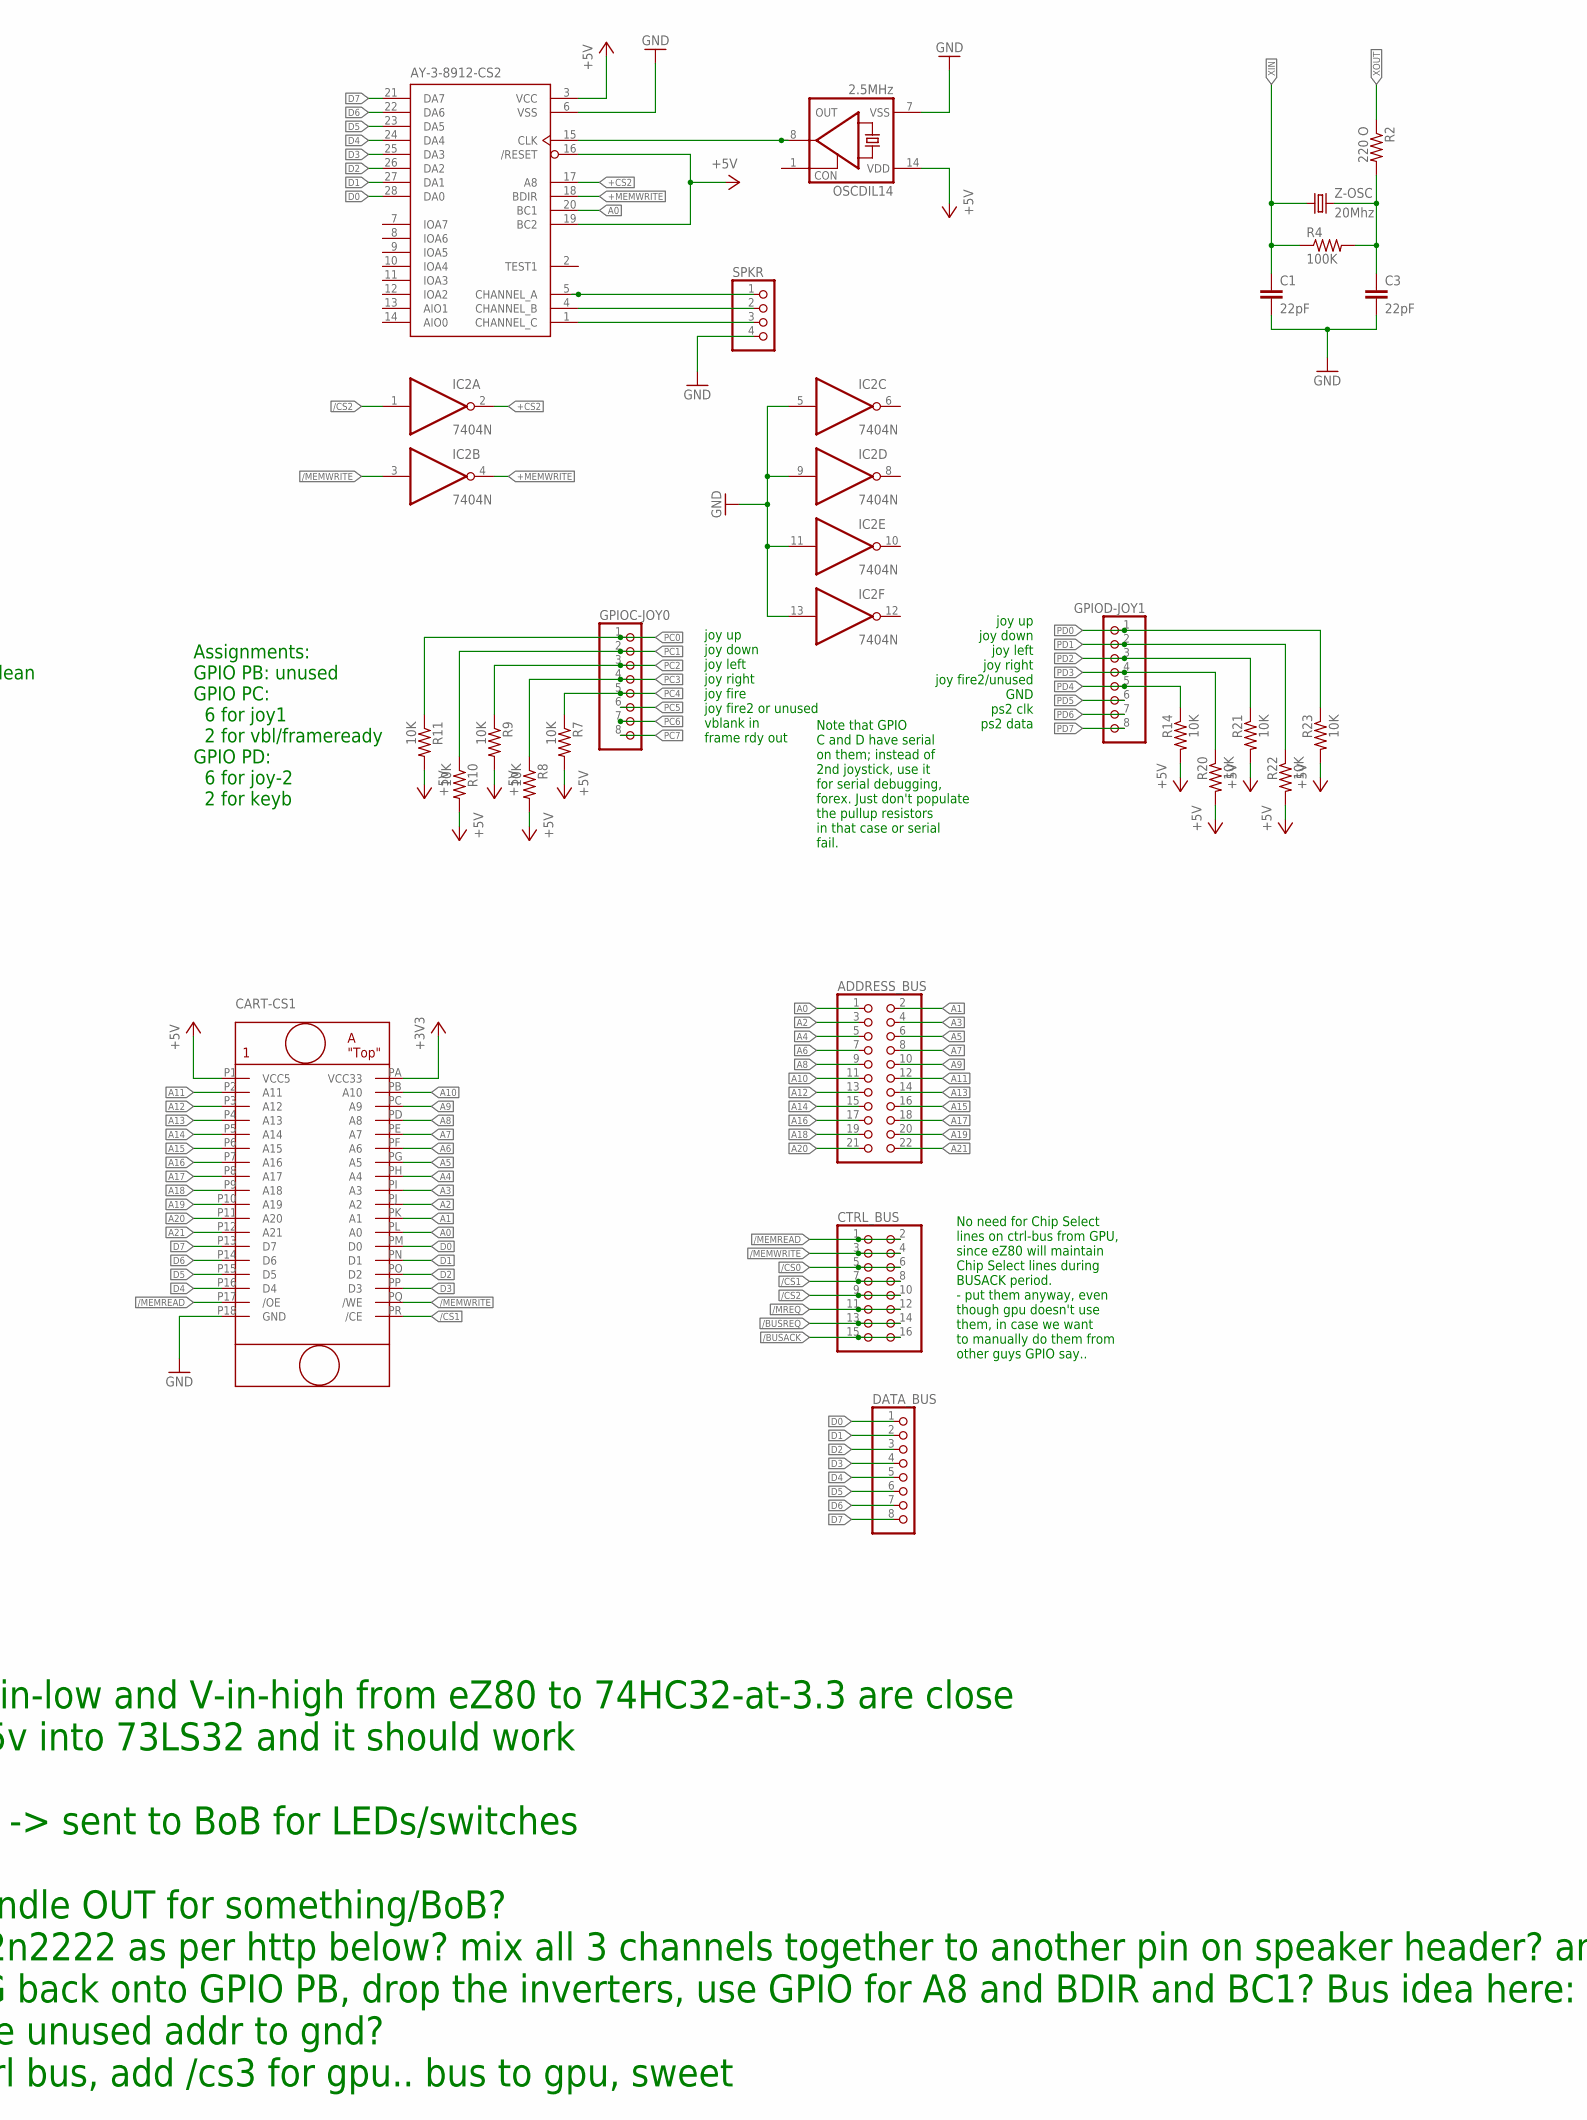
[picture p103: schematic zik-pcb-base-bussed.sch, part in row 1, column 2]

Parts:
+3V3OUT, +5OUT: PINHD-1X3; 1X03
/CS3: PINHD-1X1; 1X01
ADDRESS_BUS: PINHD-2X11; 2X11
AY-3-8912-CS2: AY-3-8912_28PIN; DIL28
BOBGPIOB: PINHD-1X8; 1X08
BOBI2C: PINHD-1X2; 1X02
BOBJTAG+: PINHD-1X8; 1X08
BOBMISC: PINHD-1X8; 1X08
C1, C3: 22pF; C025-025X050
C2, C4, C5, C6, C7, C8, C9, C10: .1uF; C025-025X050
CART-CS1: ZIKCART36; ZIKCARTSLOT
CTRL_BUS: PINHD-2X8; 2X08
DATA_BUS: PINHD-1X8; 1X08
EZ80F93: EZ80F92AZ; SQFP-S-14X14-100
GNDOUT: PINHD-1X3; 1X03
GPIOC-JOY0: PINHD-1X8; 1X08
GPIOD-JOY1: PINHD-1X8; 1X08
IC1: 7432N; DIL14
IC2: 7404N; DIL14
ISPZDI: PINHD-2X3; 2X03
LED2: LED5MM
OSCDIL14: 2.5MHz; SG51
PHI: PINHD-1X1; 1X01
PS2KEYB: PINHD-1X4; 1X04
PWRIN1: PINHD-1X4; 1X04
PWROUT1: PINHD-1X4; 1X04
R1, R3, R6, R7, R8, R9, R10, R11, R12, R13, R14, R20, R21, R22, R23: 10K; 0204/7
R2: 220 O; 0204/7
R4: 100K; 0204/7
R5: 1K; 0207/10
RAM-CS0: AS6C1008-55PCN; DIP254P1524X393-32
S1: SWITCH-MOMENTARY-2PTH; TACTILE-PTH
SPKR: PINHD-1X4; 1X04
Z-OSC: 20Mhz; HC49US

Connections:
+3V3: +3V3OUT.1, +3V3OUT.2, +3V3OUT.3, C2.1, C4.1, C5.1, C6.1, C7.1, C8.1, C9.1, C10.1, CART-CS1.PA (VCC33), EZ80F93.7 (+3V3), EZ80F93.18 (+3V3), EZ80F93.33 (+3V3), EZ80F93.43 (+3V3), EZ80F93.50 (WAIT), EZ80F93.56 (+3V3), EZ80F93.67 (+3V3), EZ80F93.87 (+3V3), EZ80F93.96 (+3V3), IC1.14 (+3V3), ISPZDI.1, PWRIN1.3, PWROUT1.3, R1.1, R3.2, R6.1, R12.1, R13.1, RAM-CS0.30 (CE2), RAM-CS0.32 (VCC)
+5V: +5OUT.1, +5OUT.2, +5OUT.3, AY-3-8912-CS2.3 (VCC), AY-3-8912-CS2.16 (/RESET), AY-3-8912-CS2.19 (BC2), CART-CS1.P1 (VCC5), IC2.14 (+5V), OSCDIL14.14 (VDD), PS2KEYB.3, PWRIN1.2, PWROUT1.2, R5.1, R7.2, R8.2, R9.2, R10.2, R11.2, R14.2, R20.2, R21.2, R22.2, R23.2
+CS2: AY-3-8912-CS2.17 (A8), IC2.2 (O)
+MEMWRITE: AY-3-8912-CS2.18 (BDIR), IC2.4 (O)
/BUSACK: CTRL_BUS.15, CTRL_BUS.16, EZ80F93.54 (BUSACK)
/BUSREQ: CTRL_BUS.13, CTRL_BUS.14, EZ80F93.53 (BUSREQ)
/CS0: CTRL_BUS.5, CTRL_BUS.6, EZ80F93.29 (CS0), RAM-CS0.22 (CE)
/CS1: CART-CS1.PR (/CE), CTRL_BUS.7, CTRL_BUS.8, EZ80F93.30 (CS1)
/CS2: CTRL_BUS.9, CTRL_BUS.10, EZ80F93.31 (CS2), IC2.1 (I)
/CS3: /CS3.1, EZ80F93.32 (CS3)
/IOREQ: BOBMISC.4, EZ80F93.45 (IORQ), R13.2
/MEMREAD: CART-CS1.P17 (/OE), CTRL_BUS.1, CTRL_BUS.2, IC1.6 (O), RAM-CS0.24 (OE)
/MEMWRITE: CART-CS1.PQ (/WE), CTRL_BUS.3, CTRL_BUS.4, IC1.3 (O), IC2.3 (I), RAM-CS0.29 (WE)
/MREQ: CTRL_BUS.11, CTRL_BUS.12, EZ80F93.46 (MREQ), IC1.2 (I1), IC1.4 (I0)
/RD: EZ80F93.47 (RD), IC1.5 (I1)
/WR: EZ80F93.48 (WR), IC1.1 (I0)
A0: ADDRESS_BUS.1, AY-3-8912-CS2.20 (BC1), CART-CS1.PL (A0), EZ80F93.1 (A0), RAM-CS0.12 (A0)
A1: ADDRESS_BUS.2, CART-CS1.PK (A1), EZ80F93.2 (A1), RAM-CS0.11 (A1)
A2: ADDRESS_BUS.3, CART-CS1.PJ (A2), EZ80F93.3 (A2), RAM-CS0.10 (A2)
A3: ADDRESS_BUS.4, CART-CS1.PI (A3), EZ80F93.4 (A3), RAM-CS0.9 (A3)
A4: ADDRESS_BUS.5, CART-CS1.PH (A4), EZ80F93.5 (A4), RAM-CS0.8 (A4)
A5: ADDRESS_BUS.6, CART-CS1.PG (A5), EZ80F93.6 (A5), RAM-CS0.7 (A5)
A6: ADDRESS_BUS.7, CART-CS1.PF (A6), EZ80F93.9 (A6), RAM-CS0.6 (A6)
A7: ADDRESS_BUS.8, CART-CS1.PE (A7), EZ80F93.10 (A7), RAM-CS0.5 (A7)
A8: ADDRESS_BUS.9, CART-CS1.PD (A8), EZ80F93.11 (A8), RAM-CS0.27 (A8)
A9: ADDRESS_BUS.10, CART-CS1.PC (A9), EZ80F93.12 (A9), RAM-CS0.26 (A9)
A10: ADDRESS_BUS.11, CART-CS1.PB (A10), EZ80F93.13 (A10), RAM-CS0.23 (A10)
A11: ADDRESS_BUS.12, CART-CS1.P2 (A11), EZ80F93.14 (A11), RAM-CS0.25 (A11)
A12: ADDRESS_BUS.13, CART-CS1.P3 (A12), EZ80F93.15 (A12), RAM-CS0.4 (A12)
A13: ADDRESS_BUS.14, CART-CS1.P4 (A13), EZ80F93.16 (A13), RAM-CS0.28 (A13)
A14: ADDRESS_BUS.15, CART-CS1.P5 (A14), EZ80F93.17 (A14), RAM-CS0.3 (A14)
A15: ADDRESS_BUS.16, CART-CS1.P6 (A15), EZ80F93.20 (A15), RAM-CS0.31 (A15)
A16: ADDRESS_BUS.17, CART-CS1.P7 (A16), EZ80F93.21 (A16), RAM-CS0.2 (A16)
A17: ADDRESS_BUS.18, CART-CS1.P8 (A17), EZ80F93.22 (A17)
A18: ADDRESS_BUS.19, CART-CS1.P9 (A18), EZ80F93.23 (A18)
A19: ADDRESS_BUS.20, CART-CS1.P10 (A19), EZ80F93.24 (A19)
A20: ADDRESS_BUS.21, CART-CS1.P11 (A20), EZ80F93.25 (A20)
A21: ADDRESS_BUS.22, CART-CS1.P12 (A21), EZ80F93.26 (A21)
A22: EZ80F93.27 (A22)
A23: EZ80F93.28 (A23)
D0: AY-3-8912-CS2.28 (DA0), CART-CS1.PM (D0), DATA_BUS.1, EZ80F93.35 (D0), RAM-CS0.13 (DQ0)
D1: AY-3-8912-CS2.27 (DA1), CART-CS1.PN (D1), DATA_BUS.2, EZ80F93.36 (D1), RAM-CS0.14 (DQ1)
D2: AY-3-8912-CS2.26 (DA2), CART-CS1.PO (D2), DATA_BUS.3, EZ80F93.37 (D2), RAM-CS0.15 (DQ2)
D3: AY-3-8912-CS2.25 (DA3), CART-CS1.PP (D3), DATA_BUS.4, EZ80F93.38 (D3), RAM-CS0.17 (DQ3)
D4: AY-3-8912-CS2.24 (DA4), CART-CS1.P16 (D4), DATA_BUS.5, EZ80F93.39 (D4), RAM-CS0.18 (DQ4)
D5: AY-3-8912-CS2.23 (DA5), CART-CS1.P15 (D5), DATA_BUS.6, EZ80F93.40 (D5), RAM-CS0.19 (DQ5)
D6: AY-3-8912-CS2.22 (DA6), CART-CS1.P14 (D6), DATA_BUS.7, EZ80F93.41 (D6), RAM-CS0.20 (DQ6)
D7: AY-3-8912-CS2.21 (DA7), CART-CS1.P13 (D7), DATA_BUS.8, EZ80F93.42 (D7), RAM-CS0.21 (DQ7)
GND: AY-3-8912-CS2.6 (VSS), C1.2, C2.2, C3.2, C4.2, C5.2, C6.2, C7.2, C8.2, C9.2, C10.2, CART-CS1.P18 (GND), EZ80F93.8 (GND), EZ80F93.19 (GND), EZ80F93.34 (GND), EZ80F93.44 (GND), EZ80F93.57 (GND), EZ80F93.61 (GND), EZ80F93.84 (GND), EZ80F93.97 (GND), GNDOUT.1, GNDOUT.2, GNDOUT.3, IC1.7 (GND), IC1.9 (I0), IC1.10 (I1), IC1.12 (I0), IC1.13 (I1), IC2.5 (I), IC2.7 (GND), IC2.9 (I), IC2.11 (I), IC2.13 (I), ISPZDI.3, ISPZDI.5, LED2.K (C), OSCDIL14.7 (VSS), PS2KEYB.2, PWRIN1.4, PWROUT1.4, RAM-CS0.16 (VSS), S1.1, SPKR.4
HALT_SLP: BOBMISC.2, EZ80F93.55 (HALT_SLP)
unnamed: C3.1, R2.2, R4.2, Z-OSC.2
unnamed: LED2.A, R5.2
unnamed: AY-3-8912-CS2.4 (CHANNEL_B), SPKR.2
unnamed: AY-3-8912-CS2.1 (CHANNEL_C), SPKR.3
unnamed: AY-3-8912-CS2.5 (CHANNEL_A), SPKR.1
unnamed: AY-3-8912-CS2.15 (CLK), OSCDIL14.8 (OUT)
NMI: BOBMISC.1, EZ80F93.52 (NMI), R12.2
NRST: EZ80F93.51 (RESET), R3.1, S1.3 (2)
PB0: BOBGPIOB.1, EZ80F93.88 (PB0/T0_IN)
PB1: BOBGPIOB.2, EZ80F93.89 (PB1/T1_IN)
PB2: BOBGPIOB.3, EZ80F93.90 (PB2/SS)
PB3: BOBGPIOB.4, EZ80F93.91 (PB3/SCK)
PB4: BOBGPIOB.5, EZ80F93.92 (PB4/T4_OUT)
PB5: BOBGPIOB.6, EZ80F93.93 (PB5/T5_OUT)
PB6: BOBGPIOB.7, EZ80F93.94 (PB6/MISO)
PB7: BOBGPIOB.8, EZ80F93.95 (PB7/MOSI)
PC0: EZ80F93.76 (PC0/TXD1), GPIOC-JOY0.1, R11.1
PC1: EZ80F93.77 (PC1/RXD1), GPIOC-JOY0.2, R10.1
PC2: EZ80F93.78 (PC2/RTS1), GPIOC-JOY0.3, R9.1
PC3: EZ80F93.79 (PC3/CTS1), GPIOC-JOY0.4, R8.1
PC4: EZ80F93.80 (PC4/DTR1), GPIOC-JOY0.5, R7.1
PC5: EZ80F93.81 (PC5/DSR1), GPIOC-JOY0.6
PC6: EZ80F93.82 (PC6/DCD1), GPIOC-JOY0.7
PC7: EZ80F93.83 (PC7/RI1), GPIOC-JOY0.8
PD0: EZ80F93.68 (PD0/TXD0), GPIOD-JOY1.1, R23.1
PD1: EZ80F93.69 (PD1/RXD0), GPIOD-JOY1.2, R22.1
PD2: EZ80F93.70 (PD2/RTS0), GPIOD-JOY1.3, R21.1
PD3: EZ80F93.71 (PD3/CTS0), GPIOD-JOY1.4, R20.1
PD4: EZ80F93.72 (PD4/DTR0), GPIOD-JOY1.5, R14.1
PD5: EZ80F93.73 (PD5/DSR0), GPIOD-JOY1.6
PD6: EZ80F93.74 (PD6/DCD0), GPIOD-JOY1.7, PS2KEYB.4
PD7: EZ80F93.75 (PD7/RI0), GPIOD-JOY1.8, PS2KEYB.1
PHI: EZ80F93.100 (PHI), PHI.1
RTC_VDD: BOBMISC.6, EZ80F93.60 (RTC_VDD)
RTC_XIN: BOBMISC.8, EZ80F93.58 (RTC_XIN)
RTC_XOUT: BOBMISC.7, EZ80F93.59 (RTC_XOUT)
SCL: BOBI2C.1, EZ80F93.99 (SCL)
SDA: BOBI2C.2, EZ80F93.98 (SDA)
TCK_ZCL: BOBJTAG+.1, EZ80F93.63 (TCK/ZCL), ISPZDI.4, R1.2
TDI_ZDA: BOBJTAG+.3, EZ80F93.65 (TDI/ZDA), ISPZDI.6, R6.2
TDO: BOBJTAG+.4, EZ80F93.66 (TDO)
TMS: BOBJTAG+.2, EZ80F93.62 (TMS)
TRIGOUT: BOBJTAG+.5, EZ80F93.64 (TRIGOUT)
VCC: PWRIN1.1, PWROUT1.1
XIN: C1.1, EZ80F93.85 (XIN), R4.1, Z-OSC.1
XOUT: EZ80F93.86 (XOUT), R2.1

Notes on the sheet:
- Big Question: V-in-low and V-in-high from eZ80 to 74HC32-at-3.3 are close --> could bodge 5v into 73LS32 and it should work - GPIO PB unused -> sent to BoB for LEDs/switches - rev2: IOREQ, handle OUT for something/BoB? - rev2: amplifier 2n2222 as per http below? mix all 3 channels together to ano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
Power-In header - VCC - 5 - 3.3 - GND
Power Our duplicates - VCC - 5 - 3.3 - GND
Power LED 5V
Note that GPIO C and D have serial on them; instead of 2nd joystick, use it for serial debugging, forex. Just don't populate the pullup resistors in that case or serial fail.
joy up joy down joy left joy right joy fire2/unused GND ps2 clk ps2 data
joy up joy down joy left joy right joy fire joy fire2 or unused vblank in frame rdy out
No need for Chip Select lines on ctrl-bus from GPU, since eZ80 will maintain Chip Select lines during BUSACK period. - put them anyway, even though gpu doesn't use them, in case we want to manually do them from other guys GPIO say..
Assignments: GPIO PB: unused GPIO PC: 6 for joy1 2 for vbl/frameready GPIO PD: 6 for joy-2 2 for keyb
Jeff Mitchell 2014 www.zikzak.ca
.. and lame 1 pin headers, to save me from routing the basketweave.. maybe clean up later

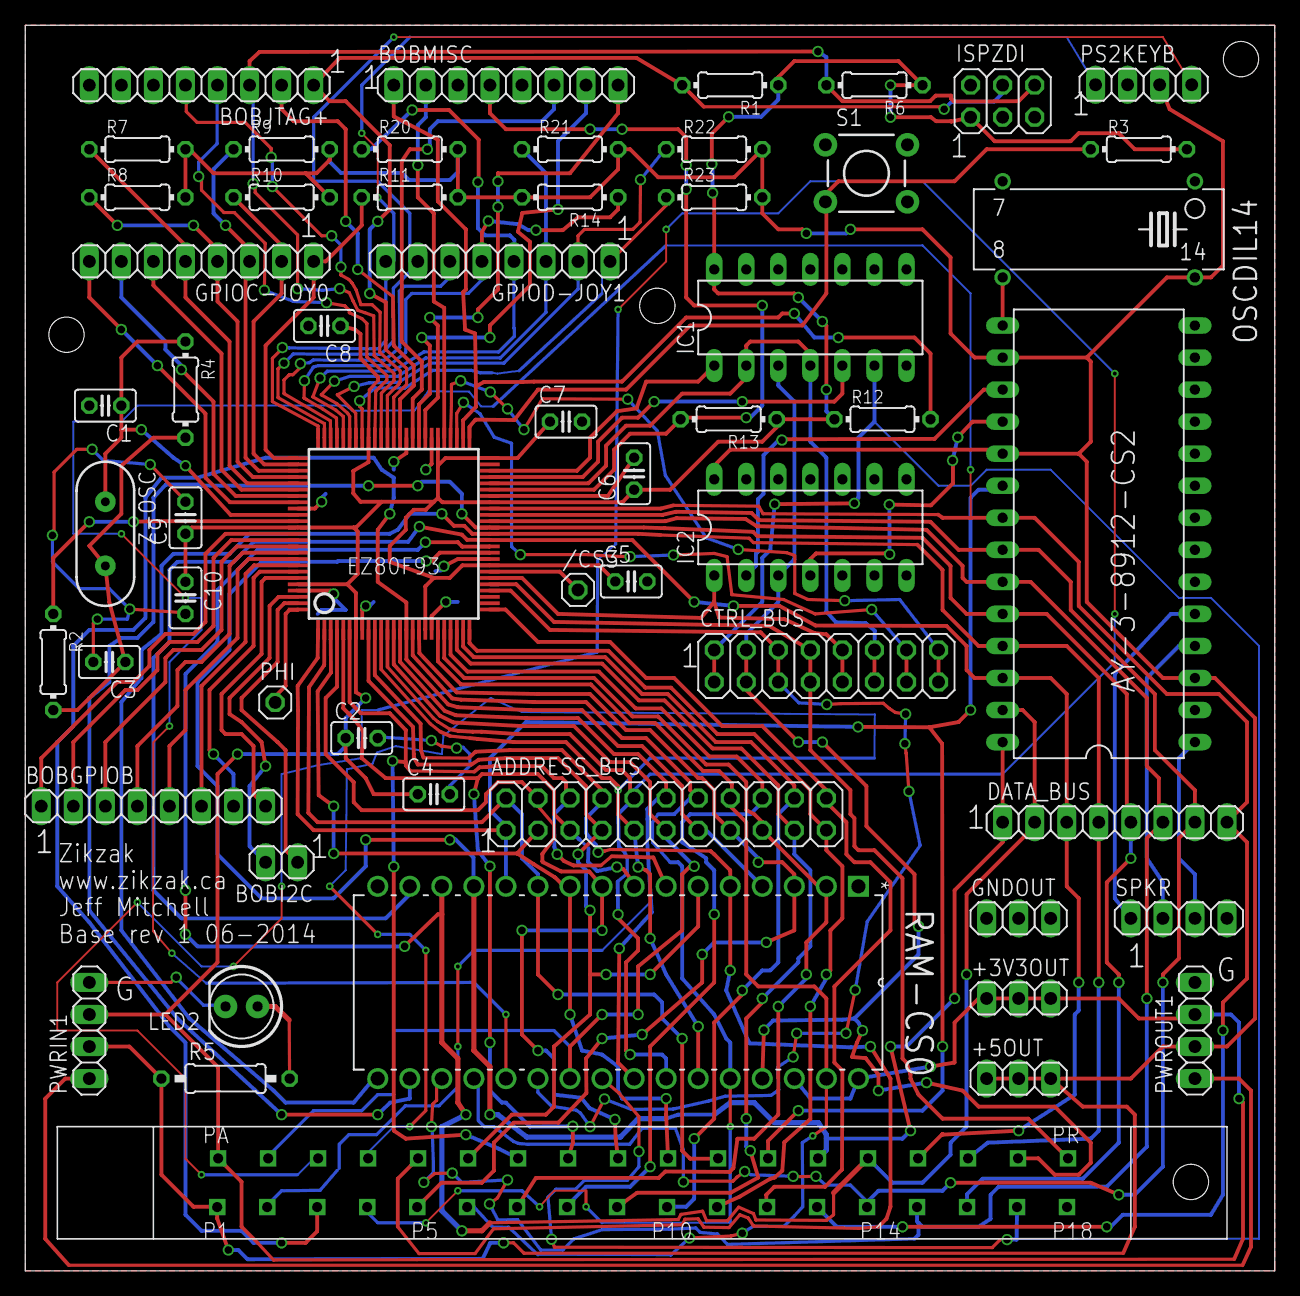
[picture p104: board zik-pcb-base-bussed.brd from above]

Board: 2 copper layers, 99.0 x 98.7 mm, 57 parts (0 on the bottom side), 94 nets.
