skeezix/zikzak/zik80/schem/zik-pcb-gpu-f407.brd

## EAGLE design zik80/schem/zik-pcb-gpu-f407.brd (2014-06-18)

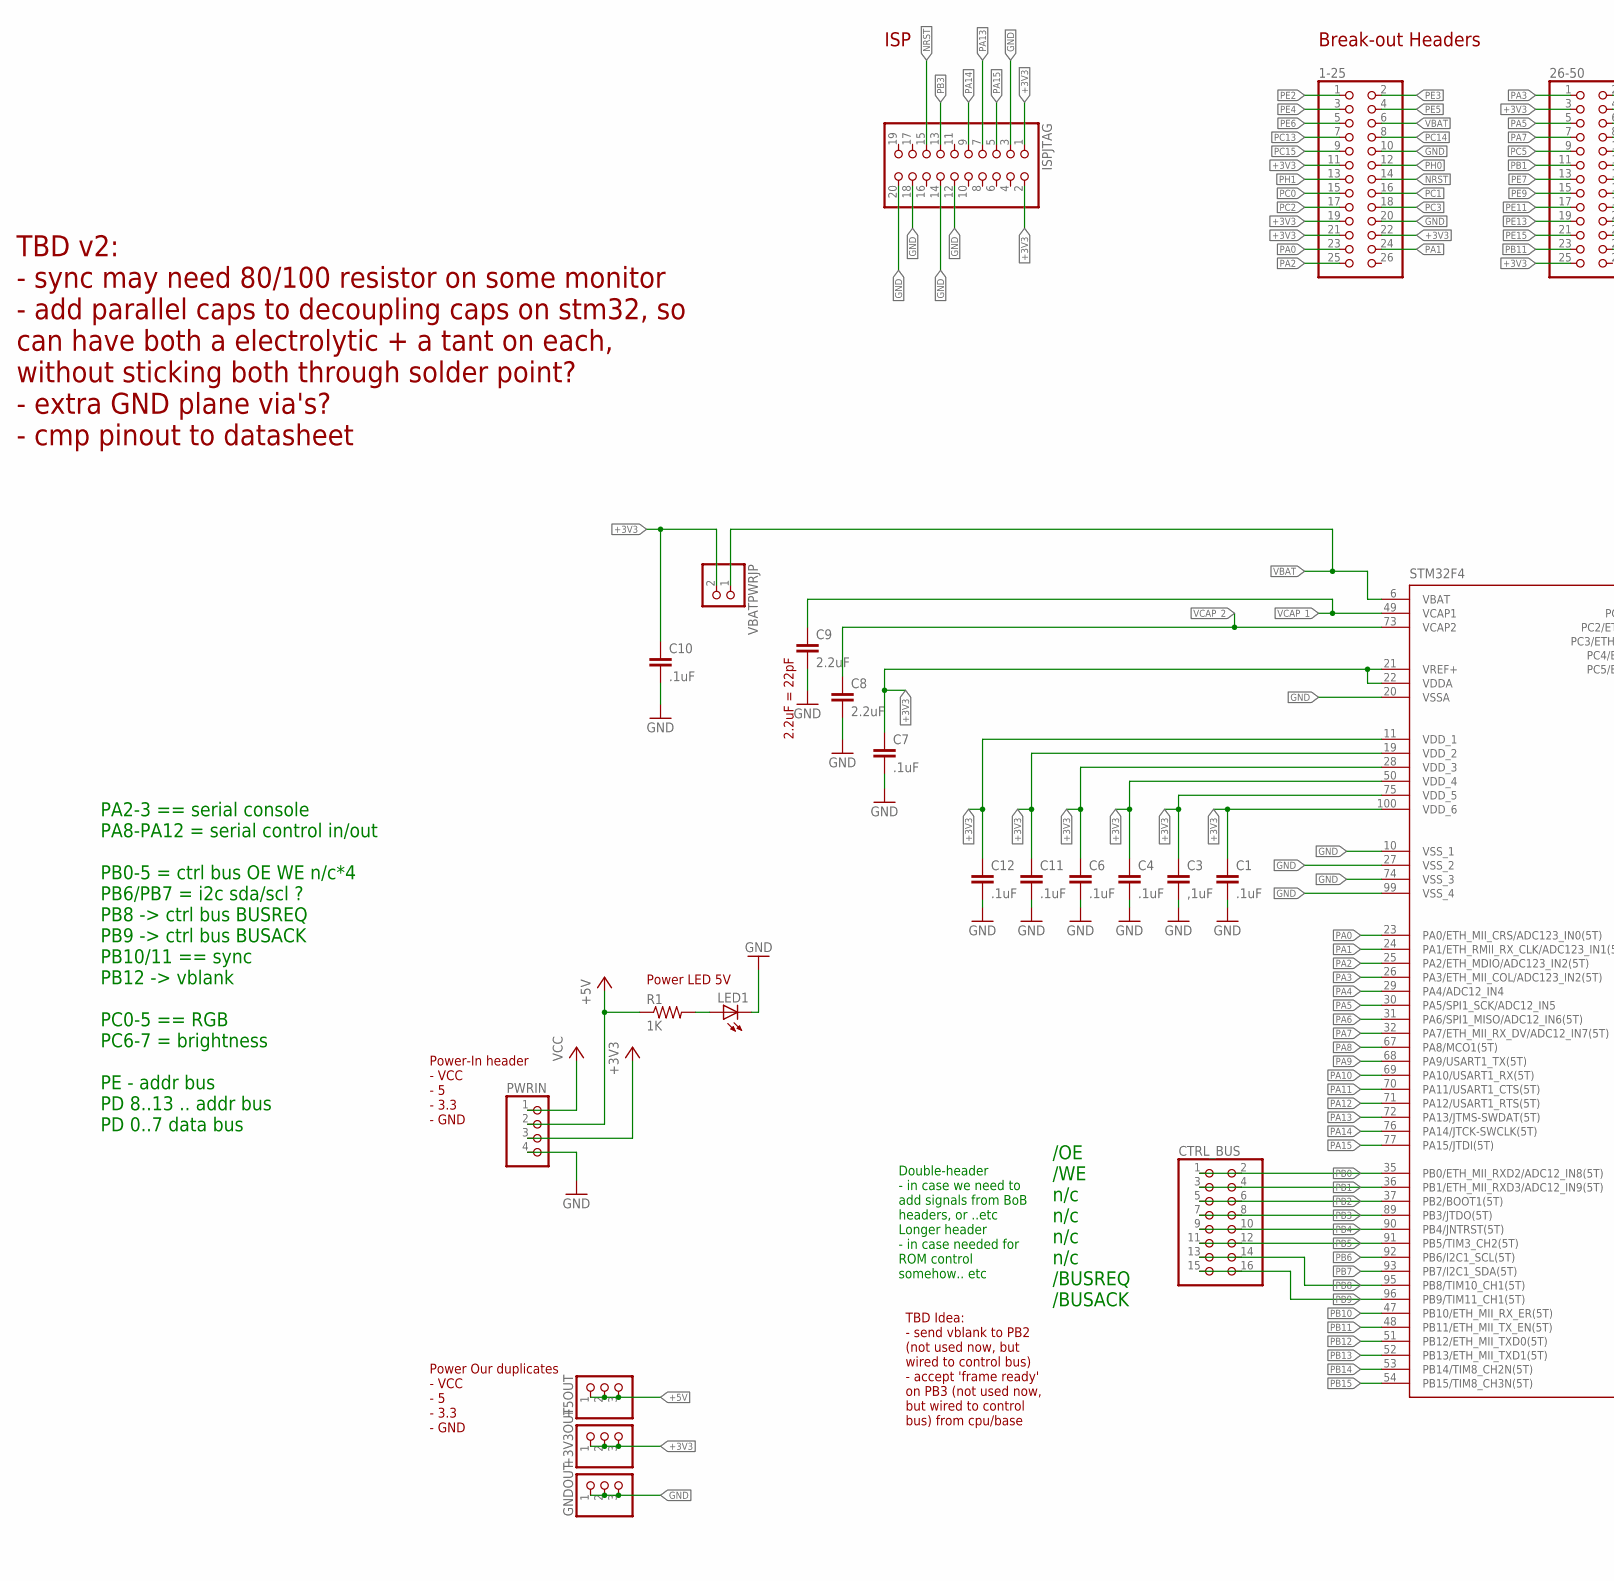
[picture p105: schematic zik-pcb-gpu-f407.sch, part in row 1, column 1]

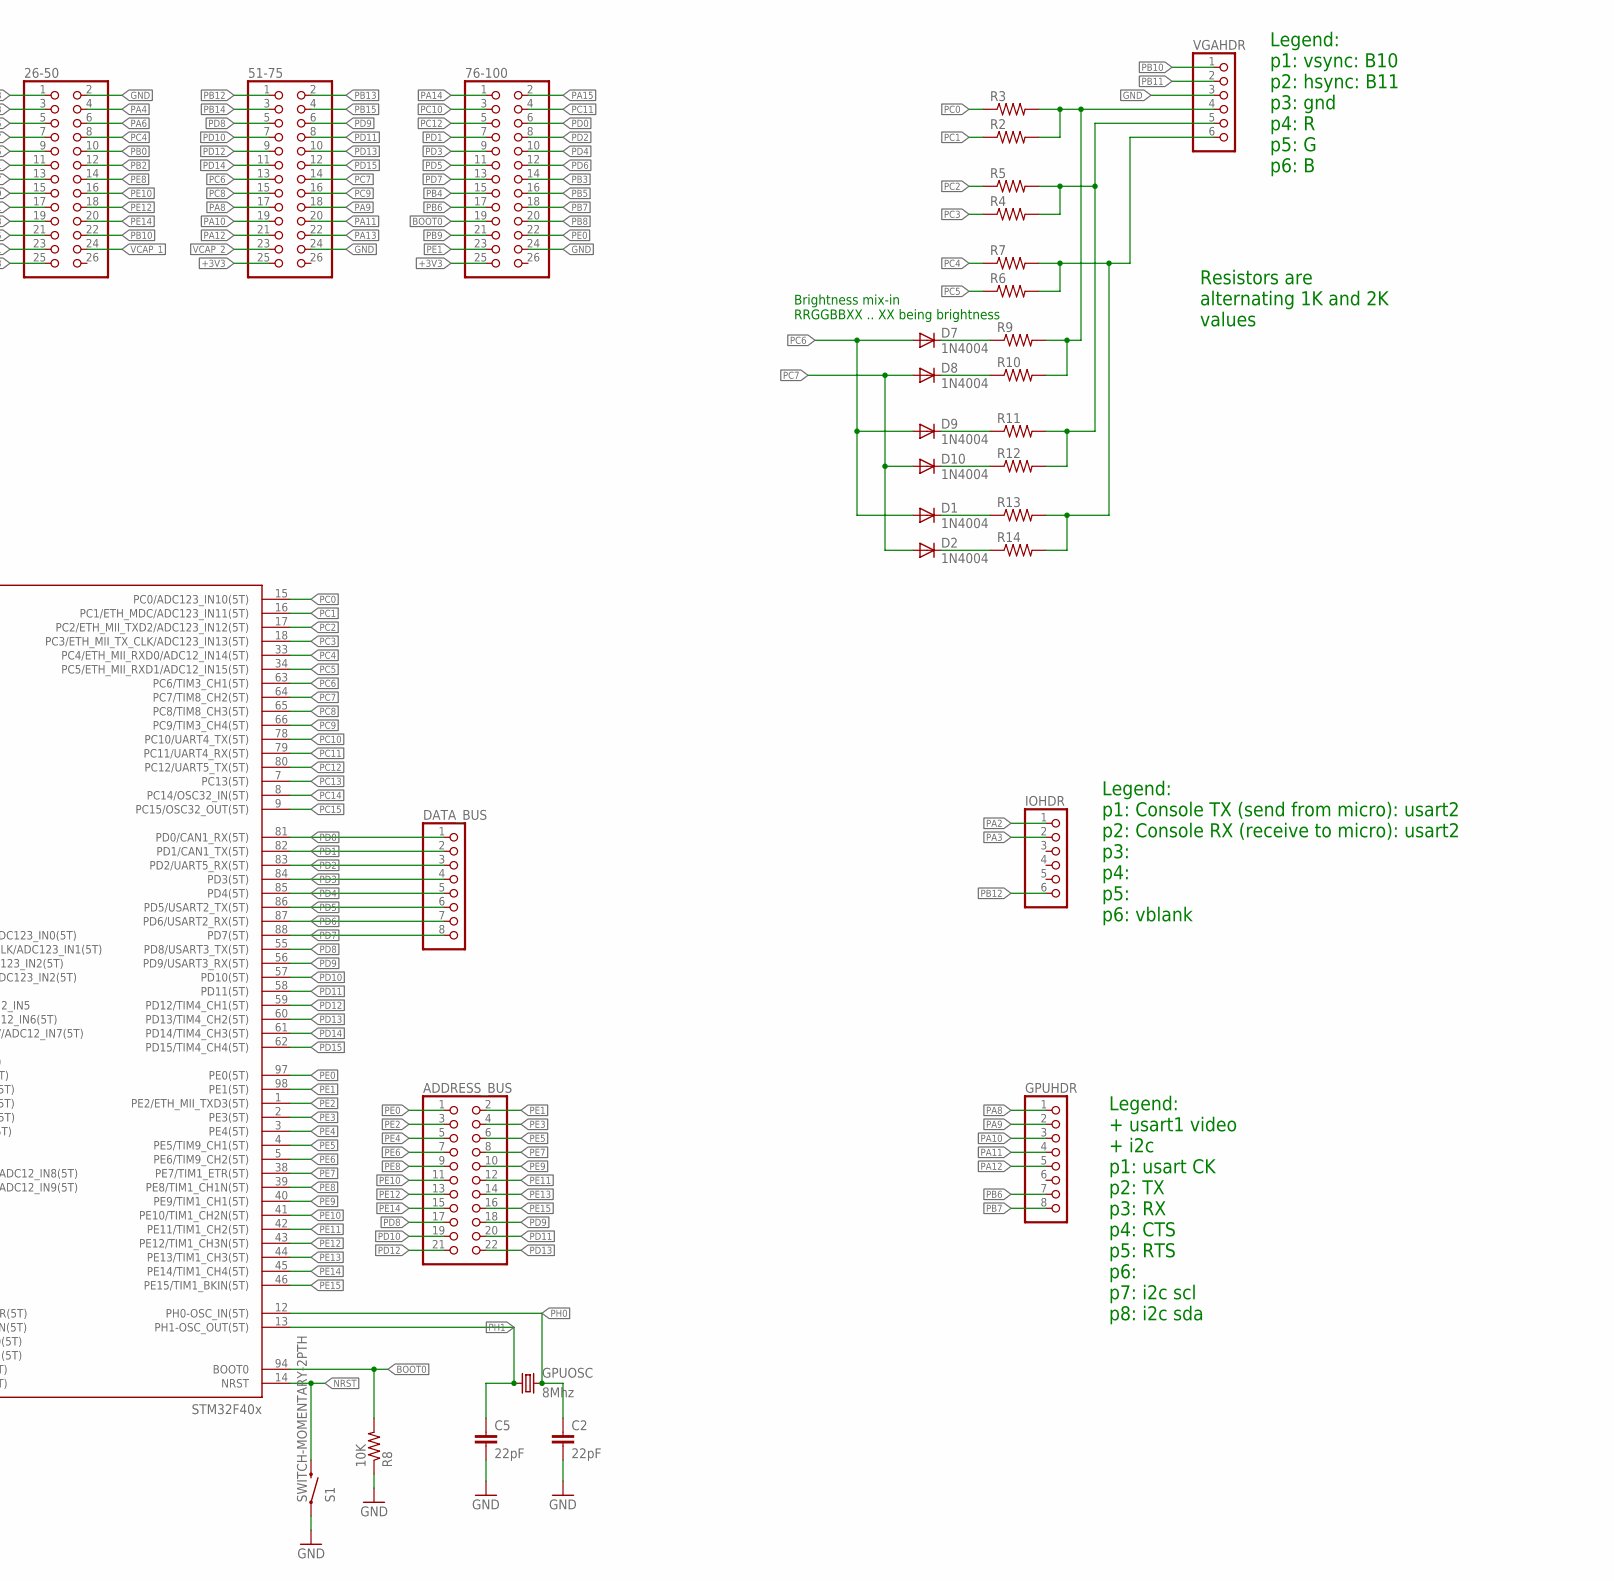
[picture p106: schematic zik-pcb-gpu-f407.sch, part in row 1, column 2]

Parts:
1-25, 26-50, 51-75, 76-100: PINHD-2X13; 2X13
+3V3OUT, +5OUT: PINHD-1X3; 1X03
ADDRESS_BUS: PINHD-2X11; 2X11
C1, C4, C6, C7, C10, C11, C12: .1uF; C025-025X050
C2, C5: 22pF; C025-025X050
C3: ,1uF; C025-025X050
C8, C9: 2.2uF; C025-025X050
CTRL_BUS: PINHD-2X8; 2X08
D1, D2, D7, D8, D9, D10: 1N4004; DO41-10
DATA_BUS: PINHD-1X8; 1X08
GNDOUT: PINHD-1X3; 1X03
GPUHDR: PINHD-1X8; 1X08
GPUOSC: 8Mhz; HC49US
IOHDR: PINHD-1X6; 1X06
ISPJTAG: PINHD-2X10; 2X10
LED1: LED5MM
PWRIN: PINHD-1X4; 1X04
R1: 1K; 0207/10
R2, R3, R4, R5, R6, R7, R9, R10, R11, R12, R13, R14: R-US_0207/10; 0207/10
R8: 10K; 0207/10
S1: SWITCH-MOMENTARY-2PTH; TACTILE-PTH
STM32F4: STM32F407V; TQFP100
VBATPWRJP: PINHD-1X2; 1X02
VGAHDR: PINHD-1X6; 1X06

Connections:
+3V3: 1-25.11, 1-25.19, 1-25.21, 1-25.22, 26-50.3, 26-50.25, 51-75.25, 76-100.25, +3V3OUT.1, +3V3OUT.2, +3V3OUT.3, C1.1, C3.1, C4.1, C6.1, C7.1, C10.1, C11.1, C12.1, ISPJTAG.1, ISPJTAG.2, PWRIN.3, STM32F4.11 (VDD_1), STM32F4.19 (VDD_2), STM32F4.21 (VREF+), STM32F4.22 (VDDA), STM32F4.28 (VDD_3), STM32F4.50 (VDD_4), STM32F4.75 (VDD_5), STM32F4.100 (VDD_6), VBATPWRJP.2
+5V: +5OUT.1, +5OUT.2, +5OUT.3, PWRIN.2, R1.1
BOOT0: 76-100.19, R8.2, STM32F4.94 (BOOT0)
GND: 1-25.10, 1-25.20, 26-50.2, 51-75.24, 76-100.24, C1.2, C2.2, C3.2, C4.2, C5.2, C6.2, C7.2, C8.2, C9.2, C10.2, C11.2, C12.2, GNDOUT.1, GNDOUT.2, GNDOUT.3, ISPJTAG.3, ISPJTAG.12, ISPJTAG.14, ISPJTAG.18, ISPJTAG.20, LED1.K (C), PWRIN.4, R8.1, S1.1, STM32F4.10 (VSS_1), STM32F4.20 (VSSA), STM32F4.27 (VSS_2), STM32F4.74 (VSS_3), STM32F4.99 (VSS_4), VGAHDR.3
unnamed: LED1.A, R1.2
unnamed: D7.C, R9.1
unnamed: R4.2, R5.2, R11.2, R12.2, VGAHDR.5
unnamed: D8.C, R10.1
unnamed: R6.2, R7.2, R13.2, R14.2, VGAHDR.6
unnamed: R2.2, R3.2, R9.2, R10.2, VGAHDR.4
unnamed: D9.C, R11.1
unnamed: D10.C, R12.1
unnamed: D1.C, R13.1
unnamed: D2.C, R14.1
NRST: 1-25.14, ISPJTAG.15, S1.3 (2), STM32F4.14 (NRST)
PA0: 1-25.23, STM32F4.23 (PA0/ETH_MII_CRS/ADC123_IN0(5T))
PA1: 1-25.24, STM32F4.24 (PA1/ETH_RMII_RX_CLK/ADC123_IN1(5T))
PA2: 1-25.25, IOHDR.1, STM32F4.25 (PA2/ETH_MDIO/ADC123_IN2(5T))
PA3: 26-50.1, IOHDR.2, STM32F4.26 (PA3/ETH_MII_COL/ADC123_IN2(5T))
PA4: 26-50.4, STM32F4.29 (PA4/ADC12_IN4)
PA5: 26-50.5, STM32F4.30 (PA5/SPI1_SCK/ADC12_IN5)
PA6: 26-50.6, STM32F4.31 (PA6/SPI1_MISO/ADC12_IN6(5T))
PA7: 26-50.7, STM32F4.32 (PA7/ETH_MII_RX_DV/ADC12_IN7(5T))
PA8: 51-75.17, GPUHDR.1, STM32F4.67 (PA8/MCO1(5T))
PA9: 51-75.18, GPUHDR.2, STM32F4.68 (PA9/USART1_TX(5T))
PA10: 51-75.19, GPUHDR.3, STM32F4.69 (PA10/USART1_RX(5T))
PA11: 51-75.20, GPUHDR.4, STM32F4.70 (PA11/USART1_CTS(5T))
PA12: 51-75.21, GPUHDR.5, STM32F4.71 (PA12/USART1_RTS(5T))
PA13: 51-75.22, ISPJTAG.7, STM32F4.72 (PA13/JTMS-SWDAT(5T))
PA14: 76-100.1, ISPJTAG.9, STM32F4.76 (PA14/JTCK-SWCLK(5T))
PA15: 76-100.2, ISPJTAG.5, STM32F4.77 (PA15/JTDI(5T))
PB0: 26-50.10, CTRL_BUS.1, CTRL_BUS.2, STM32F4.35 (PB0/ETH_MII_RXD2/ADC12_IN8(5T))
PB1: 26-50.11, CTRL_BUS.3, CTRL_BUS.4, STM32F4.36 (PB1/ETH_MII_RXD3/ADC12_IN9(5T))
PB2: 26-50.12, CTRL_BUS.5, CTRL_BUS.6, STM32F4.37 (PB2/BOOT1(5T))
PB3: 76-100.14, CTRL_BUS.7, CTRL_BUS.8, ISPJTAG.13, STM32F4.89 (PB3/JTDO(5T))
PB4: 76-100.15, CTRL_BUS.9, CTRL_BUS.10, STM32F4.90 (PB4/JNTRST(5T))
PB5: 76-100.16, CTRL_BUS.11, CTRL_BUS.12, STM32F4.91 (PB5/TIM3_CH2(5T))
PB6: 76-100.17, GPUHDR.7, STM32F4.92 (PB6/I2C1_SCL(5T))
PB7: 76-100.18, GPUHDR.8, STM32F4.93 (PB7/I2C1_SDA(5T))
PB8: 76-100.20, CTRL_BUS.13, CTRL_BUS.14, STM32F4.95 (PB8/TIM10_CH1(5T))
PB9: 76-100.21, CTRL_BUS.15, CTRL_BUS.16, STM32F4.96 (PB9/TIM11_CH1(5T))
PB10: 26-50.22, STM32F4.47 (PB10/ETH_MII_RX_ER(5T)), VGAHDR.1
PB11: 26-50.23, STM32F4.48 (PB11/ETH_MII_TX_EN(5T)), VGAHDR.2
PB12: 51-75.1, IOHDR.6, STM32F4.51 (PB12/ETH_MII_TXD0(5T))
PB13: 51-75.2, STM32F4.52 (PB13/ETH_MII_TXD1(5T))
PB14: 51-75.3, STM32F4.53 (PB14/TIM8_CH2N(5T))
PB15: 51-75.4, STM32F4.54 (PB15/TIM8_CH3N(5T))
PC0: 1-25.15, R3.1, STM32F4.15 (PC0/ADC123_IN10(5T))
PC1: 1-25.16, R2.1, STM32F4.16 (PC1/ETH_MDC/ADC123_IN11(5T))
PC2: 1-25.17, R5.1, STM32F4.17 (PC2/ETH_MII_TXD2/ADC123_IN12(5T))
PC3: 1-25.18, R4.1, STM32F4.18 (PC3/ETH_MII_TX_CLK/ADC123_IN13(5T))
PC4: 26-50.8, R7.1, STM32F4.33 (PC4/ETH_MII_RXD0/ADC12_IN14(5T))
PC5: 26-50.9, R6.1, STM32F4.34 (PC5/ETH_MII_RXD1/ADC12_IN15(5T))
PC6: 51-75.13, D1.A, D7.A, D9.A, STM32F4.63 (PC6/TIM3_CH1(5T))
PC7: 51-75.14, D2.A, D8.A, D10.A, STM32F4.64 (PC7/TIM8_CH2(5T))
PC8: 51-75.15, STM32F4.65 (PC8/TIM8_CH3(5T))
PC9: 51-75.16, STM32F4.66 (PC9/TIM3_CH4(5T))
PC10: 76-100.3, STM32F4.78 (PC10/UART4_TX(5T))
PC11: 76-100.4, STM32F4.79 (PC11/UART4_RX(5T))
PC12: 76-100.5, STM32F4.80 (PC12/UART5_TX(5T))
PC13: 1-25.7, STM32F4.7 (PC13(5T))
PC14: 1-25.8, STM32F4.8 (PC14/OSC32_IN(5T))
PC15: 1-25.9, STM32F4.9 (PC15/OSC32_OUT(5T))
PD0: 76-100.6, DATA_BUS.1, STM32F4.81 (PD0/CAN1_RX(5T))
PD1: 76-100.7, DATA_BUS.2, STM32F4.82 (PD1/CAN1_TX(5T))
PD2: 76-100.8, DATA_BUS.3, STM32F4.83 (PD2/UART5_RX(5T))
PD3: 76-100.9, DATA_BUS.4, STM32F4.84 (PD3(5T))
PD4: 76-100.10, DATA_BUS.5, STM32F4.85 (PD4(5T))
PD5: 76-100.11, DATA_BUS.6, STM32F4.86 (PD5/USART2_TX(5T))
PD6: 76-100.12, DATA_BUS.7, STM32F4.87 (PD6/USART2_RX(5T))
PD7: 76-100.13, DATA_BUS.8, STM32F4.88 (PD7(5T))
PD8: 51-75.5, ADDRESS_BUS.17, STM32F4.55 (PD8/USART3_TX(5T))
PD9: 51-75.6, ADDRESS_BUS.18, STM32F4.56 (PD9/USART3_RX(5T))
PD10: 51-75.7, ADDRESS_BUS.19, STM32F4.57 (PD10(5T))
PD11: 51-75.8, ADDRESS_BUS.20, STM32F4.58 (PD11(5T))
PD12: 51-75.9, ADDRESS_BUS.21, STM32F4.59 (PD12/TIM4_CH1(5T))
PD13: 51-75.10, ADDRESS_BUS.22, STM32F4.60 (PD13/TIM4_CH2(5T))
PD14: 51-75.11, STM32F4.61 (PD14/TIM4_CH3(5T))
PD15: 51-75.12, STM32F4.62 (PD15/TIM4_CH4(5T))
PE0: 76-100.22, ADDRESS_BUS.1, STM32F4.97 (PE0(5T))
PE1: 76-100.23, ADDRESS_BUS.2, STM32F4.98 (PE1(5T))
PE2: 1-25.1, ADDRESS_BUS.3, STM32F4.1 (PE2/ETH_MII_TXD3(5T))
PE3: 1-25.2, ADDRESS_BUS.4, STM32F4.2 (PE3(5T))
PE4: 1-25.3, ADDRESS_BUS.5, STM32F4.3 (PE4(5T))
PE5: 1-25.4, ADDRESS_BUS.6, STM32F4.4 (PE5/TIM9_CH1(5T))
PE6: 1-25.5, ADDRESS_BUS.7, STM32F4.5 (PE6/TIM9_CH2(5T))
PE7: 26-50.13, ADDRESS_BUS.8, STM32F4.38 (PE7/TIM1_ETR(5T))
PE8: 26-50.14, ADDRESS_BUS.9, STM32F4.39 (PE8/TIM1_CH1N(5T))
PE9: 26-50.15, ADDRESS_BUS.10, STM32F4.40 (PE9/TIM1_CH1(5T))
PE10: 26-50.16, ADDRESS_BUS.11, STM32F4.41 (PE10/TIM1_CH2N(5T))
PE11: 26-50.17, ADDRESS_BUS.12, STM32F4.42 (PE11/TIM1_CH2(5T))
PE12: 26-50.18, ADDRESS_BUS.13, STM32F4.43 (PE12/TIM1_CH3N(5T))
PE13: 26-50.19, ADDRESS_BUS.14, STM32F4.44 (PE13/TIM1_CH3(5T))
PE14: 26-50.20, ADDRESS_BUS.15, STM32F4.45 (PE14/TIM1_CH4(5T))
PE15: 26-50.21, ADDRESS_BUS.16, STM32F4.46 (PE15/TIM1_BKIN(5T))
PH0: 1-25.12, C2.1, GPUOSC.2, STM32F4.12 (PH0-OSC_IN(5T))
PH1: 1-25.13, C5.1, GPUOSC.1, STM32F4.13 (PH1-OSC_OUT(5T))
VBAT: 1-25.6, STM32F4.6 (VBAT), VBATPWRJP.1
VCAP_1: 26-50.24, C9.1, STM32F4.49 (VCAP1)
VCAP_2: 51-75.23, C8.1, STM32F4.73 (VCAP2)
VCC: PWRIN.1

Notes on the sheet:
Power-In header - VCC - 5 - 3.3 - GND
Break-out Headers
ISP
Power Our duplicates - VCC - 5 - 3.3 - GND
2.2uF = 22pF
TBD v2: - sync may need 80/100 resistor on some monitor - add parallel caps to decoupling caps on stm32, so can have both a electrolytic + a tant on each, without sticking both through solder point? - extra GND plane via's? - cmp pinout to datasheet
Power LED 5V
Legend: p1: vsync: B10 p2: hsync: B11 p3: gnd p4: R p5: G p6: B
PA2-3 == serial console PA8-PA12 = serial control in/out PB0-5 = ctrl bus OE WE n/c*4 PB6/PB7 = i2c sda/scl ? PB8 -> ctrl bus BUSREQ PB9 -> ctrl bus BUSACK PB10/11 == sync PB12 -> vblank PC0-5 == RGB PC6-7 = brightness PE - addr bus PD 8..13 .. addr bus PD 0..7 data bus
Legend: p1: Console TX (send from micro): usart2 p2: Console RX (receive to micro): usart2 p3: p4: p5: p6: vblank
Legend: + usart1 video + i2c p1: usart CK p2: TX p3: RX p4: CTS p5: RTS p6: p7: i2c scl p8: i2c sda
Brightness mix-in RRGGBBXX .. XX being brightness
Resistors are alternating 1K and 2K values
/OE /WE n/c n/c n/c n/c /BUSREQ /BUSACK
Double-header - in case we need to add signals from BoB headers, or ..etc Longer header - in case needed for ROM control somehow.. etc
TBD Idea: - send vblank to PB2 (not used now, but wired to control bus) - accept 'frame ready' on PB3 (not used now, but wired to control bus) from cpu/base

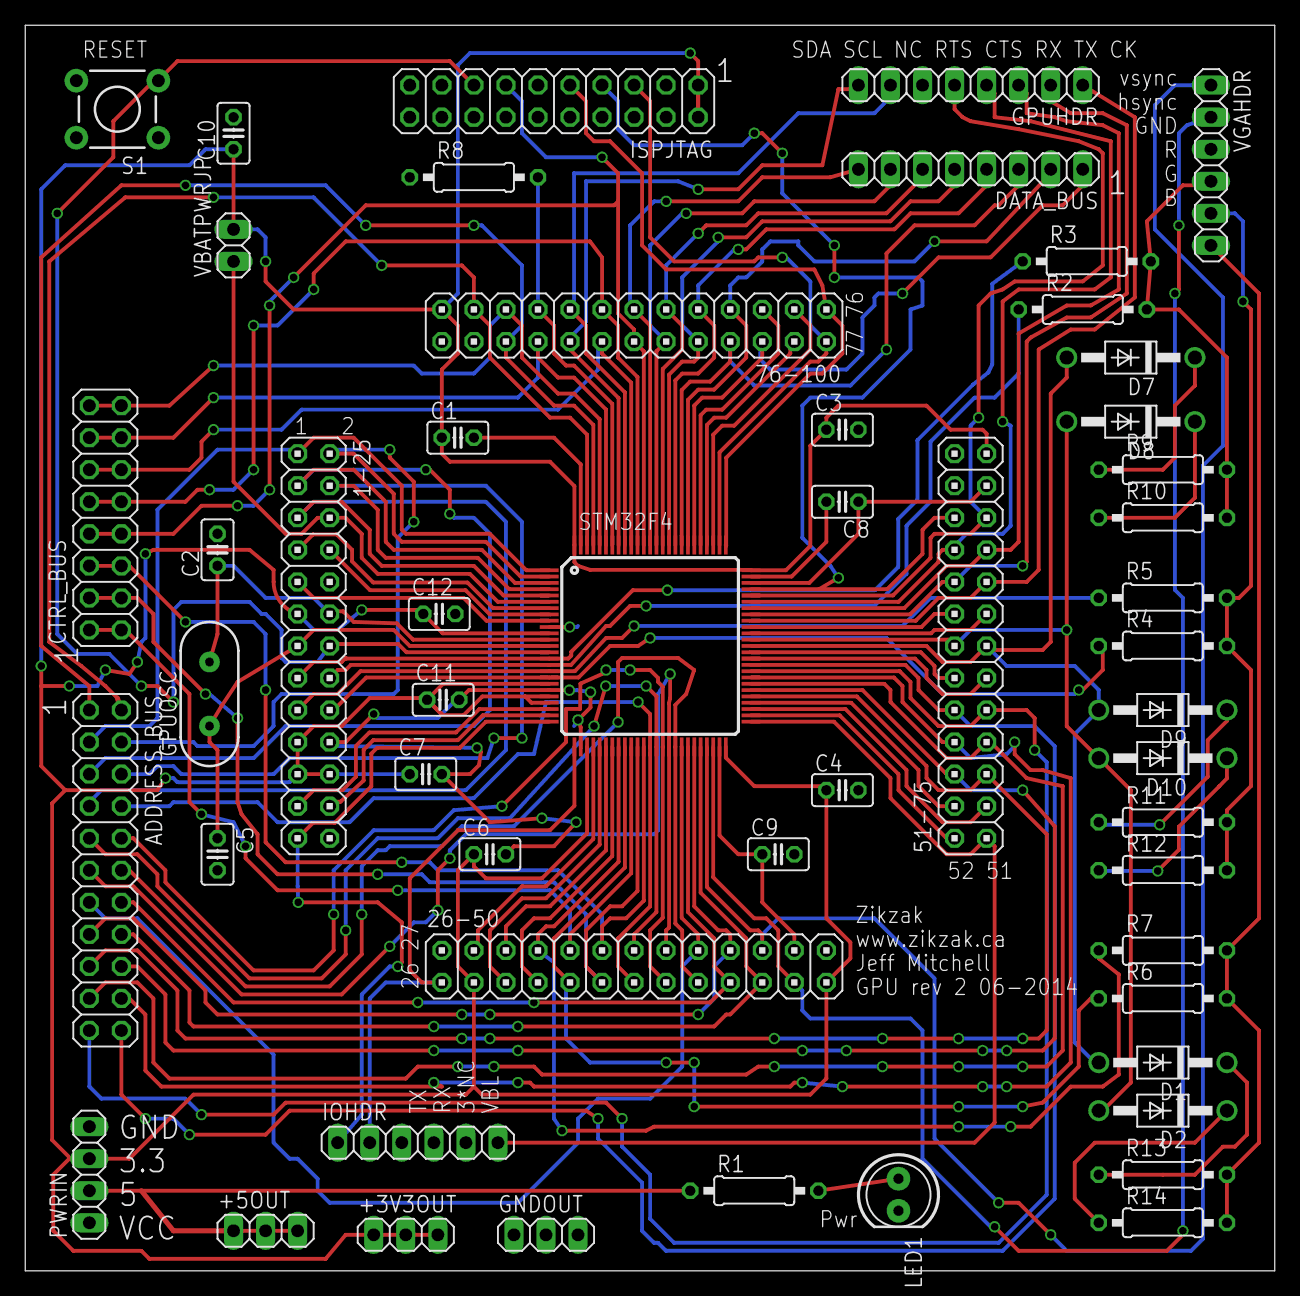
[picture p107: board zik-pcb-gpu-f407.brd from above]

Board: 2 copper layers, 99.0 x 98.7 mm, 52 parts (0 on the bottom side), 100 nets.
