skeezix/zikzak/zik80/schem/zik-pcb-power.brd

## EAGLE design zik80/schem/zik-pcb-power.brd (2014-06-04)

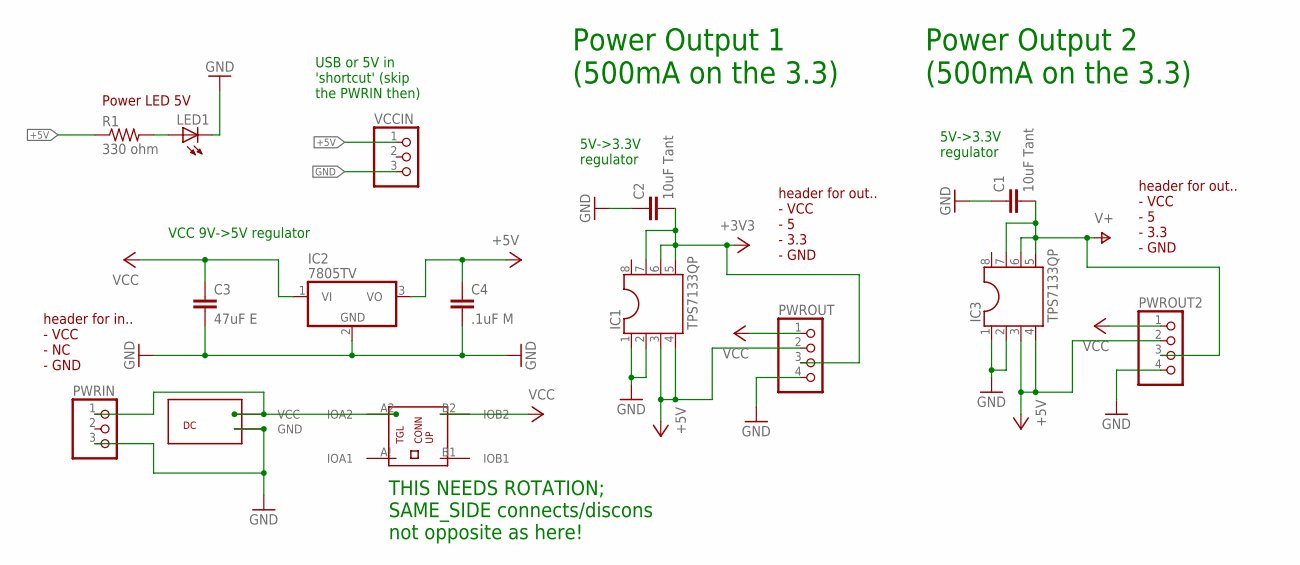
[picture p108: schematic zik-pcb-power.sch]

Parts:
C1, C2: 10uF Tant; C025-025X050
C3: 47uF E; C025-025X050
C4: .1uF M; C025-025X050
IC1, IC3: TPS7133QP; DIL08
IC2: 7805TV; TO220V
LED1: LED5MM
PWRIN: PINHD-1X3; 1X03
PWROUT, PWROUT2: PINHD-1X4; 1X04
R1: 330 ohm; 0207/10
U$1: DCJACKZIK
U$2: TOGGLE-CYAN-L-ZIK; TOGGLE-CYAN-LG-ZIK
VCCIN: PINHD-1X3; 1X03

Connections:
+3V3: C2.2, IC1.5, IC1.6, IC1.7, PWROUT.3
+5V: C4.1, IC1.3, IC1.4, IC2.3 (VO), IC3.3, IC3.4, PWROUT.2, PWROUT2.2, R1.1, VCCIN.1
GND: C1.1, C2.1, C3.2, C4.2, IC1.1, IC1.2, IC2.2 (GND), IC3.1, IC3.2, LED1.K (C), PWRIN.3, PWROUT.4, PWROUT2.4, U$1.JACKET (GND), VCCIN.3
unnamed: PWRIN.1, U$1.CPIN (VCC), U$2.A2 (IOA2)
unnamed: LED1.A, R1.2
V+: C1.2, IC3.5, IC3.6, IC3.7, PWROUT2.3
VCC: C3.1, IC2.1 (VI), PWROUT.1, PWROUT2.1, U$2.B2 (IOB2)

Notes on the sheet:
5V->3.3V regulator
VCC 9V->5V regulator
header for out.. - VCC - 5 - 3.3 - GND
header for in.. - VCC - NC - GND
Power Output 1 (500mA on the 3.3)
Power Output 2 (500mA on the 3.3)
USB or 5V in 'shortcut' (skip the PWRIN then)
Power LED 5V
THIS NEEDS ROTATION; SAME_SIDE connects/discons not opposite as here!

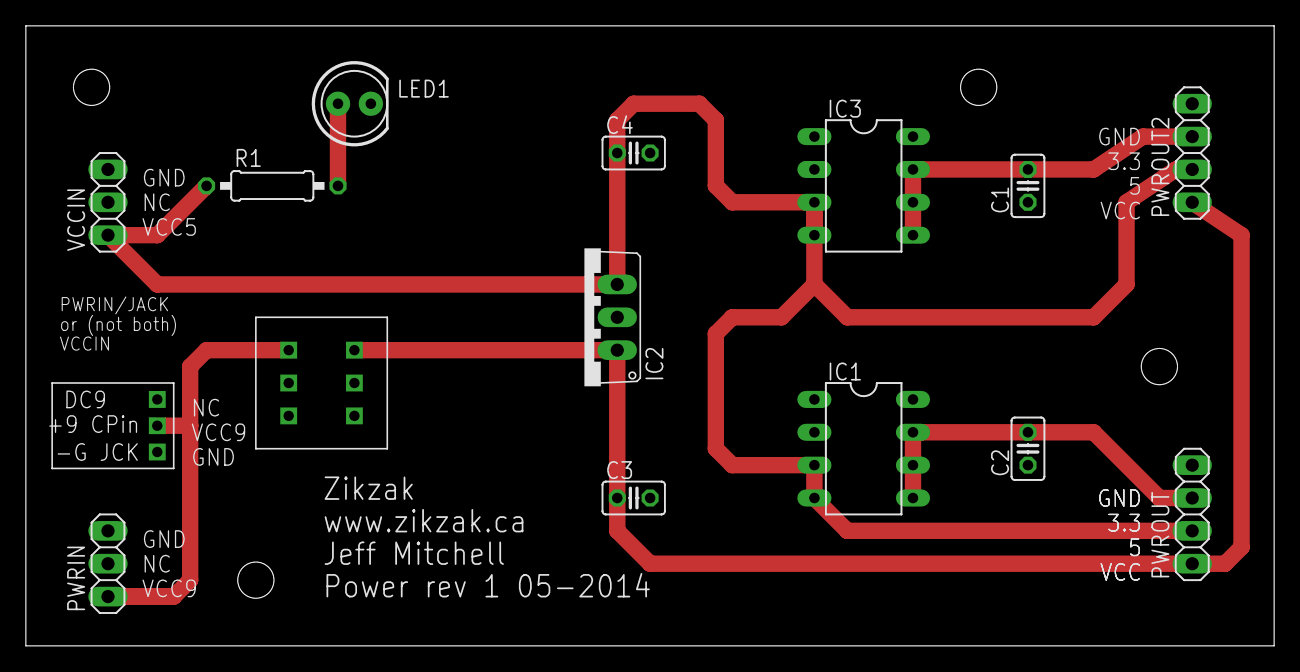
[picture p109: board zik-pcb-power.brd from above]

Board: 2 copper layers, 96.5 x 47.9 mm, 15 parts (0 on the bottom side), 7 nets.
