skeezix/zikzak/zikcart/protocard_2x18/zikcart/zikcart-atc256-001.brd

## EAGLE design zikcart/protocard_2x18/zikcart/zikcart-atc256-001.brd (2014-02-28)

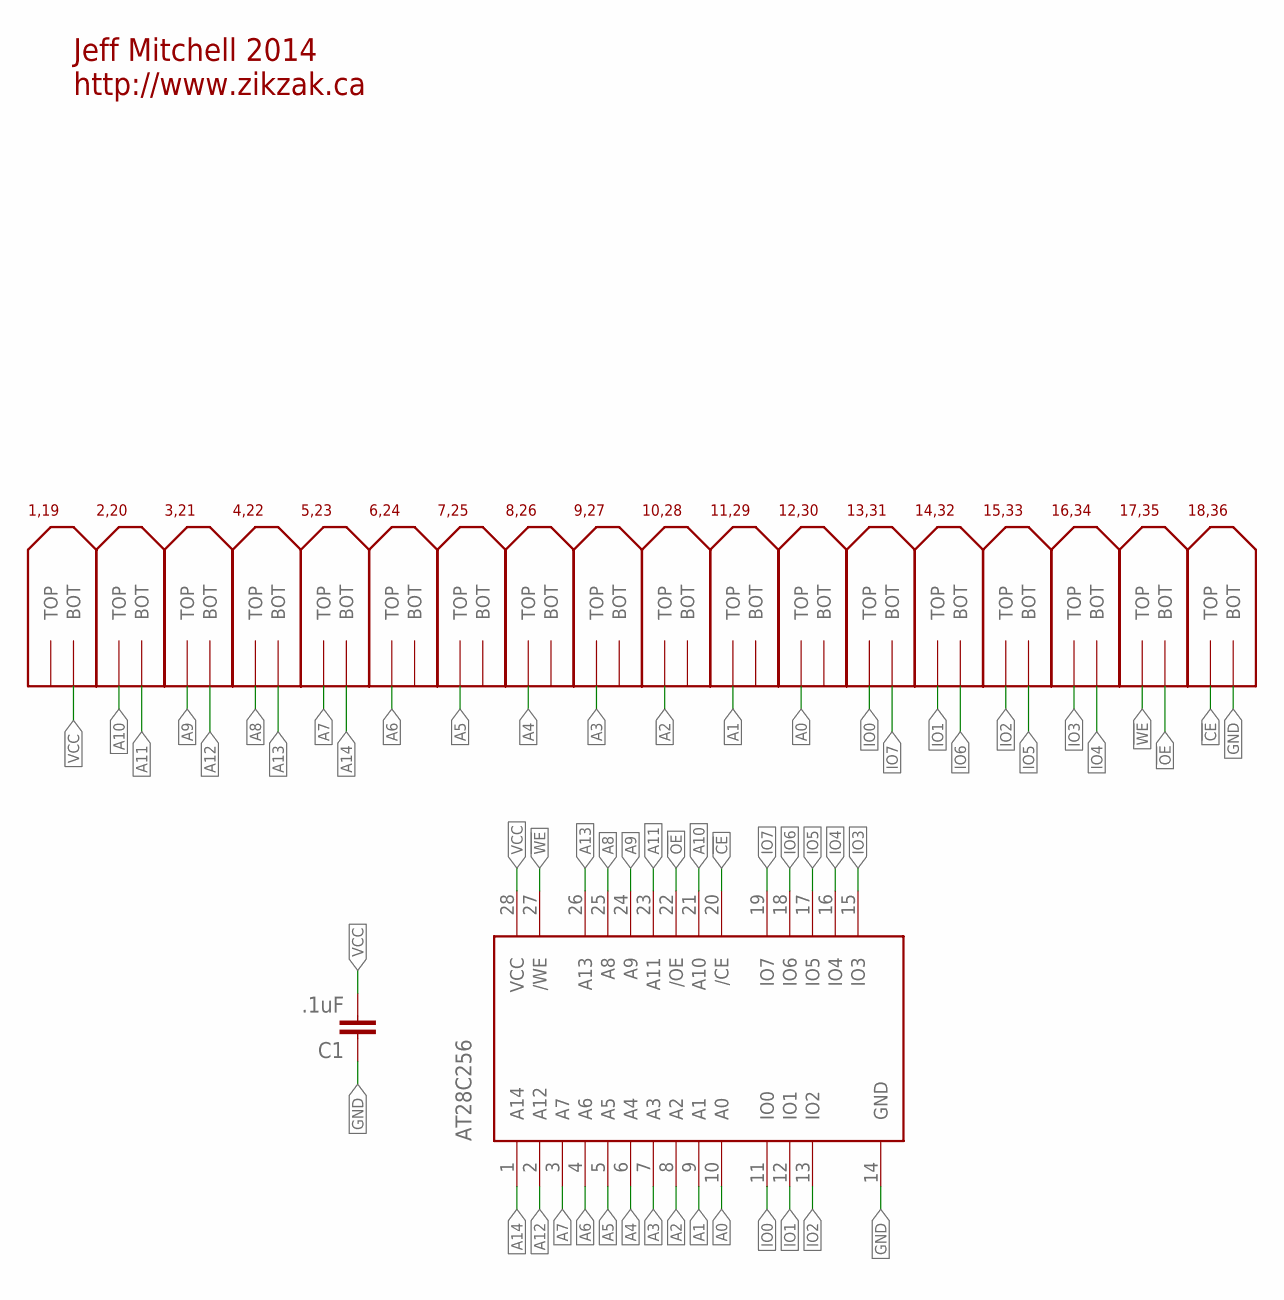
[picture p110: schematic zikcart-atc256-001.sch]

Parts:
1,19, 2,20, 3,21, 4,22, 5,23, 6,24, 7,25, 8,26, 9,27, 10,28, 11,29, 12,30, 13,31, 14,32, 15,33, 16,34, 17,35, 18,36: ZIKZAKFINGERPAIR2X18
AT28C256: AT28C256; DIL28-6
C1: .1uF; C025-030X050

Connections:
!CE!: 18,36.P$1 (TOP), AT28C256.20 (/CE)
!OE!: 17,35.P$2 (BOT), AT28C256.22 (/OE)
!WE!: 17,35.P$1 (TOP), AT28C256.27 (/WE)
A0: 12,30.P$1 (TOP), AT28C256.10 (A0)
A1: 11,29.P$1 (TOP), AT28C256.9 (A1)
A2: 10,28.P$1 (TOP), AT28C256.8 (A2)
A3: 9,27.P$1 (TOP), AT28C256.7 (A3)
A4: 8,26.P$1 (TOP), AT28C256.6 (A4)
A5: 7,25.P$1 (TOP), AT28C256.5 (A5)
A6: 6,24.P$1 (TOP), AT28C256.4 (A6)
A7: 5,23.P$1 (TOP), AT28C256.3 (A7)
A8: 4,22.P$1 (TOP), AT28C256.25 (A8)
A9: 3,21.P$1 (TOP), AT28C256.24 (A9)
A10: 2,20.P$1 (TOP), AT28C256.21 (A10)
A11: 2,20.P$2 (BOT), AT28C256.23 (A11)
A12: 3,21.P$2 (BOT), AT28C256.2 (A12)
A13: 4,22.P$2 (BOT), AT28C256.26 (A13)
A14: 5,23.P$2 (BOT), AT28C256.1 (A14)
GND: 18,36.P$2 (BOT), AT28C256.14 (GND), C1.1
IO0: 13,31.P$1 (TOP), AT28C256.11 (IO0)
IO1: 14,32.P$1 (TOP), AT28C256.12 (IO1)
IO2: 15,33.P$1 (TOP), AT28C256.13 (IO2)
IO3: 16,34.P$1 (TOP), AT28C256.15 (IO3)
IO4: 16,34.P$2 (BOT), AT28C256.16 (IO4)
IO5: 15,33.P$2 (BOT), AT28C256.17 (IO5)
IO6: 14,32.P$2 (BOT), AT28C256.18 (IO6)
IO7: 13,31.P$2 (BOT), AT28C256.19 (IO7)
VCC: 1,19.P$2 (BOT), AT28C256.28 (VCC), C1.2

Notes on the sheet:
Jeff Mitchell 2014 http://www.zikzak.ca

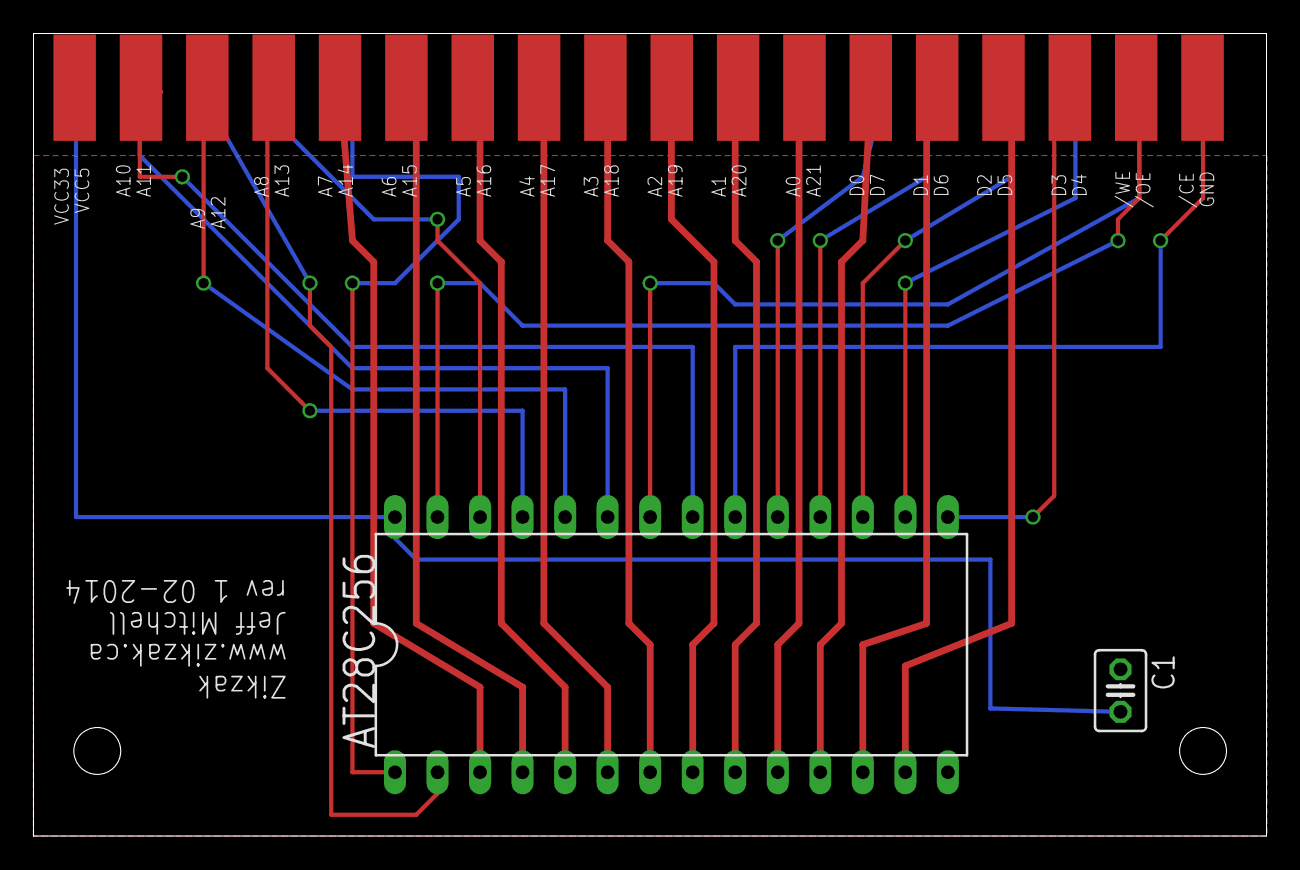
[picture p111: board zikcart-atc256-001.brd from above]

Board: 2 copper layers, 73.6 x 47.9 mm, 20 parts (0 on the bottom side), 28 nets.
