skeezix/zikzak/zikzak3/zikzak3-modules-gpu.brd

## EAGLE design zikzak3/zikzak3-modules-gpu.brd (2013-06-28)

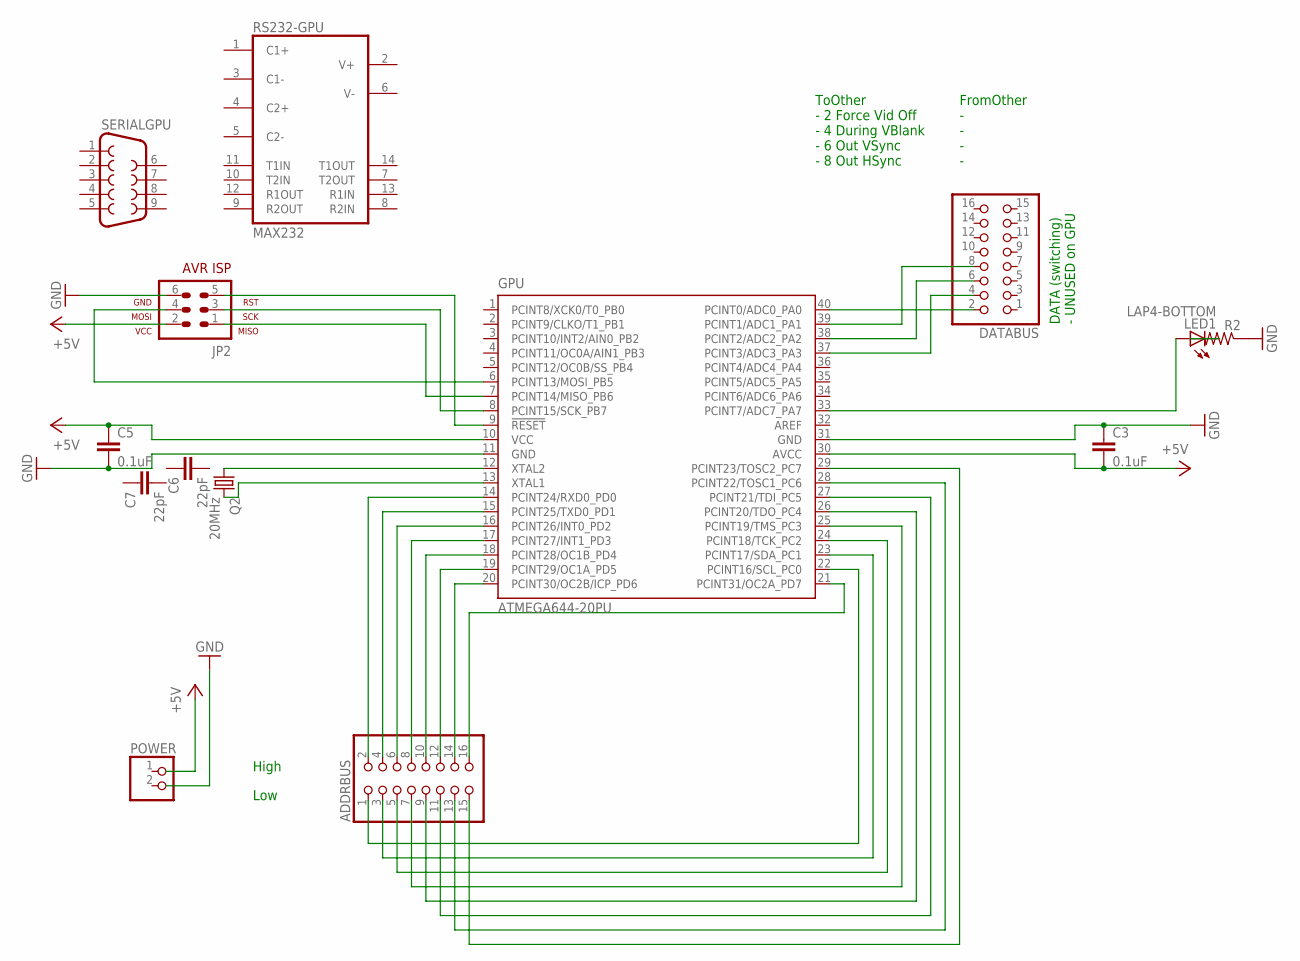
[picture p112: schematic zikzak3-modules-gpu.sch]

Parts:
ADDRBUS: PINHD-2X8/90; 2X08/90
C3, C5: 0.1uF; C2.5-3
C6, C7: 22pF; C2.5-3
DATABUS: PINHD-2X8/90; 2X08/90
GPU: ATMEGA644-20PU; DIL40
JP2: AVR-ISP-6VERT; AVR-ISP-6
LED1: LAP4-BOTTOM; P47F-BOTTOM
POWER: PINHD-1X2; 1X02
Q2: 20MHz; TC38H
R2: R-US_0204/2V; 0204V
RS232-GPU: MAX232; DIL16
SERIALGPU: F09H

Connections:
+5V: C3.2, C5.1, GPU.10 (VCC), GPU.30 (AVCC), JP2.2
GND: C3.1, C5.2, GPU.11 (GND), GPU.31 (GND), JP2.6, R2.1, RS232-GPU.15 (GND)
unnamed: ADDRBUS.16, GPU.21 (PCINT31/OC2A_PD7)
unnamed: ADDRBUS.14, GPU.20 (PCINT30/OC2B/ICP_PD6)
unnamed: ADDRBUS.12, GPU.19 (PCINT29/OC1A_PD5)
unnamed: ADDRBUS.2, GPU.14 (PCINT24/RXD0_PD0)
unnamed: ADDRBUS.4, GPU.15 (PCINT25/TXD0_PD1)
unnamed: ADDRBUS.6, GPU.16 (PCINT26/INT0_PD2)
unnamed: ADDRBUS.8, GPU.17 (PCINT27/INT1_PD3)
unnamed: ADDRBUS.10, GPU.18 (PCINT28/OC1B_PD4)
unnamed: GPU.12 (XTAL2), Q2.1
unnamed: GPU.13 (XTAL1), Q2.2
unnamed: ADDRBUS.1, GPU.22 (PCINT16/SCL_PC0)
unnamed: ADDRBUS.3, GPU.23 (PCINT17/SDA_PC1)
unnamed: ADDRBUS.5, GPU.24 (PCINT18/TCK_PC2)
unnamed: ADDRBUS.7, GPU.25 (PCINT19/TMS_PC3)
unnamed: ADDRBUS.9, GPU.26 (PCINT20/TDO_PC4)
unnamed: ADDRBUS.11, GPU.27 (PCINT21/TDI_PC5)
unnamed: ADDRBUS.13, GPU.28 (PCINT22/TOSC1_PC6)
unnamed: ADDRBUS.15, GPU.29 (PCINT23/TOSC2_PC7)
unnamed: LED1.C, R2.2
unnamed: GPU.33 (PCINT7/ADC7_PA7), LED1.A
unnamed: DATABUS.2, GPU.40 (PCINT0/ADC0_PA0)
unnamed: DATABUS.4, GPU.37 (PCINT3/ADC3_PA3)
unnamed: DATABUS.6, GPU.38 (PCINT2/ADC2_PA2)
unnamed: DATABUS.8, GPU.39 (PCINT1/ADC1_PA1)
unnamed: GPU.6 (PCINT13/MOSI_PB5), JP2.4
unnamed: GPU.7 (PCINT14/MISO_PB6), JP2.1
unnamed: GPU.8 (PCINT15/SCK_PB7), JP2.3
unnamed: GPU.9 (!RESET), JP2.5
VCC: RS232-GPU.16 (VCC)

Notes on the sheet:
DATA (switching) - UNUSED on GPU
ToOther - 2 Force Vid Off - 4 During VBlank - 6 Out VSync - 8 Out HSync
Low
High
FromOther - - - -

Board: 2 copper layers, 14 parts (1 on the bottom side), 30 nets, no tracks yet.
