skeezix/zikzak/zik80/stm-f2-vga/stateoftheart.c

/* GIMP RGB C-Source image dump (stateoftheart.c) */

#include "stateoftheart.h"

gimp_image_t gimp_image = {
  320, 200, 3,
  "=\22&\14\0\4\1\0\0\16\0\10.\1\40Y\26Br\23mz\24j~\26a}\30R\201\30C~\34""3"
  "a,&@=\36&i\14\17i\7\5k\5\22a\6""0D\0U,\0r\"\7~\37\13\217\27\30\214\30\31"
  "\211\35\33\200\37\31i!\22N8\21""0T\24\25b\20\12`\27\34S\34B:%n!3\203\25B"
  "\200\27O\201\27Y\212\21^z\32b}\30Zj\22B<\6\36\13\0\4\0\4\0\4\5\11\24\4\21"
  "/\20""0_\26Nv\17`v\22lz\26n\207\23d\211\30V{\34Hb&0G-\40,B\24#_\25%k\25/"
  "[\20BA\13T2\14n\37\22\177\27\24\204\26\31}\33\32z\40\30y$\20b3\11ED\4\"X"
  "\2\25`\1\11f\0\16c\0+W\2H<\2d%\4v\37\14\210\30\24\211\31\25\212\31\25\212"
  "\27\22\201\33\15j+\14L?\13""6O\13\26Z\7\20`\11\35W\13F<\11p$\12\205\36\15"
  "\207\35\15\205\32\12\206\26\24\201\23\22w\34\27d,\33D@\33,Y\40\33h\40\14"
  "k\31\7f\25\24`\30.Q\33P;\36s%!\210\30&\220\26+\217\31/\205\25%\206\26$\201"
  "\36#p*\40U<\35<N\32+\\\32%e\33'U\25<D\25]-\31z\37\36\206\31\37\203\31\35"
  "\201\35\33\200#\34\212\33+y!\40_0\26DG\20,[\13\31f\6\15h\1\7f\0\37U\7-K\3"
  "H<\0f+\0~\40\4\206\33\7\203\34\15}\35\17\203\32\27\200\32\25q#\17Q6\13)M"
  "\3\15_\0\6h\0\12k\0\37V\3""6F\5Y2\11x#\17\206\33\23\205\30\21\200\30\17~"
  "\30\14\206\32\16s!\13X3\11=I\13%Z\12\24c\10\15f\10\15k\12\31]\20,S\20JG\22"
  "b<\30q2#}'0\205\31""9\207\14;\212\25I\207\22F\201\27Gq!HQ#=/\30(\26\11\23"
  "\15\0\11\22\7\15\16\1\10\16\0\6\26\0\15(\4\40J\14?m\23]\201\24o\201\23Z\177"
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
  "'\311\273\24\321\231,\2365\30\202\22\20~\23\11r\32\2a'\0H8\0/I\2\36W\12\27"
  "`\17\11f\13!V\16""6A\26""4!\23S\31""1\201!`\202\31nv\27u\177\22\207\207\22"
  "\207\211\15\177\203\15my\32\\W\37""84$\25""5?\32\32T\0\25b\4\13p\6\0k\0\3"
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
