skeezix/zikzak/zikzak3-gpu-c-linedemo/main.c

#define F_CPU 20000000UL  /* 20 MHz CPU clock */

#include <avr/pgmspace.h>
#include <avr/io.h>
#include <avr/interrupt.h>
#include <avr/sleep.h>
#include <util/delay.h>

#include <string.h>
#include <stdlib.h>

#include "main.h"
#include "nop.h"

// skee board
// PC 01 RR
// PC 23 GG
// PC 45 BB
// PB 0 vsync (pin 1)
// PB 1 hsync (pin 2)

#define LED_OFF      PORTA &= ~(1<<7)
#define LED_ON       PORTA |= (1<<7)
#define LED          (PORTA & (1<<7))

#define VBLANK_LOW   PORTA &= ~_BV(3)
#define VBLANK_HIGH  PORTA |= _BV(3)

#define VSYNC_LOW    PORTA &= ~_BV(2) /* sync pulse is LOW */
#define VSYNC_HIGH   PORTA |= _BV(2)  /* should be high all the rest of the time */

#define HSYNC_LOW    PORTA &= ~_BV(1) /* sync pulse is LOW */
#define HSYNC_HIGH   PORTA |= _BV(1)  /* should be high all the rest of the time */

#define VGA_ON       PORTA &= ~_BV(0)
#define VGA_OFF      PORTA |= _BV(0)

#define REGION2(ymax,on,off)                                                                   \
    i=0;                                                                                      \
    /* 200 Lines */                                                                           \
    while ( i < ymax ) {                                                                      \
                                                                                              \
      on;                                                                                     \
                                                                                              \
      /* 20uS Color Data */                                                                   \
      _delay_us ( 19 ); /* 1uS */                                                             \
                                                                                              \
      off;                                                                                    \
                                                                                              \
      /* 1uS Front Porch */                                                                   \
      _delay_us ( 1 ); /* 1uS */                                                              \
                                                                                              \
      /* 3.2uS Horizontal Sync */                                                             \
      HSYNC_LOW;                                                                              \
      _delay_us ( 3 );                                                                        \
      NOP4;                                                                                   \
                                                                                              \
      /* 2.2uS Back Porch */                                                                  \
      HSYNC_HIGH;                                                                             \
      _delay_us ( 2 );                                                                        \
      NOP4;                                                                                   \
                                                                                              \
      i++;                                                                                    \
      /* 26.4uS Total */                                                                      \
    }

#define REGION(ymax,on,off)                                                                   \
    i=0;                                                                                      \
    PORTC=0;                                                                                  \
    /* 200 Lines */                                                                           \
    while ( i < ymax ) {                                                                      \
                                                                                              \
      on;                                                                                     \
                                                                                              \
      /* 20uS Color Data */                                                                   \
      _delay_us ( 19 ); /* 1uS */                                                             \
                                                                                              \
      off;                                                                                    \
                                                                                              \
      /* 1uS Front Porch */                                                                   \
      _delay_us ( 1 ); /* 1uS */                                                              \
                                                                                              \
      /* 3.2uS Horizontal Sync */                                                             \
      HSYNC_LOW;                                                                              \
      _delay_us ( 3 );                                                                        \
      NOP4;                                                                                   \
                                                                                              \
      /* 2.2uS Back Porch */                                                                  \
      HSYNC_HIGH;                                                                             \
      _delay_us ( 2 );                                                                        \
      NOP3;                                                                                   \
                                                                                              \
      i++;                                                                                    \
      PORTC++;                                                                                \
      /* 26.4uS Total */                                                                      \
    }


void main ( void ) {
  int i = 0;

  cli();

  DDRA = 0xFF; // B out
  DDRB = 0xFF; // B out
  DDRC = 0xFF; // C out
  DDRD = 0xFF; // C out

  HSYNC_HIGH;
  VSYNC_HIGH;

  PORTD = 37;

  LED_ON;

  while ( 1 ) {

    // -------------------------------------------------------------------------------
    // Horizontal line business
    // -------------------------------------------------------------------------------

    REGION(150,VGA_ON,VGA_OFF);
    REGION(150,VGA_ON,VGA_OFF);
    REGION(150,VGA_ON,VGA_OFF);
    REGION(150,VGA_ON,VGA_OFF);

    // -------------------------------------------------------------------------------
    // Vertical sync business
    // -------------------------------------------------------------------------------

    REGION(1,NOP,NOP); /* front porch -> 1 line */
    VSYNC_LOW;
    REGION(4,NOP,NOP); /* sync pulse -> 4 lines */
    VSYNC_HIGH;
    VBLANK_HIGH;
    REGION(23,NOP,NOP); /* back porch -> 23 lines */
    VBLANK_LOW;

  } // while forever

} // main
