skeezix/zikzak/zik80/zz-sbc-r3-stm407-firmware/lib_vga_cm3.c

#include <libopencm3/stm32/rcc.h>
#include <libopencm3/stm32/gpio.h>
#include <libopencm3/stm32/timer.h>

#include <libopencm3/cm3/nvic.h>
#include <libopencm3/stm32/exti.h>

#include <libopencm3/cm3/cortex.h>

#include "config.h"
#include "framebuffer.h"
#include "system.h"
#include "lib_vga_cm3.h"
#include "lib_vga_pixelclock.h"
#include "lib_dma_memcpy.h"

#define RENDER_ATALL 1

// VGA
//
// 800x600 60hz, see timings:
// http://tinyvga.com/vga-timing/800x600@60Hz
// 640x480 60hz: <--------------
// http://tinyvga.com/vga-timing/640x480@60Hz
//
// Remember that VGA is line-oriented.
//
// Each line is line-data plus a horizontal pulse at the end (or begin) of each line (not per pixel)
// Each page ends with a vertical pulse (expressed in lines of duration).
//
// ie: line/hpulse/line/hpulse/.../line/hpulse/vpulse/...repeat
// vpulse is front porch, pluse, back porch
//
// milli: .001          (m)
// micro: .000 001      (u)
// nano:  .000 000 001  (n)
//
//
// 800x600 mode:
// - a line is 26.4uS in total (800 pixels at 20uS, plus front porch 40->1, sync 128 -> 3.2, back porch 88->2.2)
//   --> a pixel is 20uS/800 = 0.000 000 025/px or 25ns/px
//   --> 120Mhz = 0.000 000 008 or 8ns/px
// - 600 lines * 26.4uS == 15840uS or 16mS
//   --> 1000ms / 16mS == 62.5fps
// theres actually 24 lines in the vblank period.. so 624 long.
//   --> 624 * 26.4uS = 16474uS or 16.5mS
//   --> 1000ms / 16.5mS == 60.5fps .. nice and close to 60!
//
//
// 640x480 60hz:
// Screen refresh rate      60 Hz
// Vertical refresh         31.46875 kHz
// Pixel freq.              25.175 MHz   -> 0.000 000 040      (00000004*800=32 .. the time for whole line)
//
// horizontal:
// visible        640        25.42 uS
// Front porch    16         0.63
// Sync pulse     96         3.81
// Back porch     48         1.90
// Whole line     800       31.77
//
// vertical:
// Frame partLinesTime [ms]
// Visible area  480  15.25
// Front porch   10   0.31
// Sync pulse    2    0.06
// Back porch    33   1.04
// Whole frame   525  16.68
//
//
// sync are normally high, and drop to gnd during pulse
// 5V and 3.3V are okay for sync levels!
//
// colour is 0v through 0.7v for each analog brightness level

// wiring:
// vsync  PB10 -> pin 29
// hsync  PB11 -> pin 30
// red1   PC0 -> pin 8
// red2   PC1 -> pin 9
// green1 PC2 -> pin 10
// green2 PC3 -> pin 11
// blue1  PC4 -> pin 24
// blue2  PC5 -> pin 25
// brightness PC6
// brightness PC7

//
// at 120MHz..
// 1 cycle is 0.000000008 or 8ns
// line = 15840uS or 15840000ns means 15840000/8 = 1,980,000cycles per line
// lines per second is 624*60 == 37440

// vsync
unsigned int back_porch_togo = 0;  // remaining lines of back porch
unsigned int front_porch_togo = 0; // remaining lines of front porch
unsigned int vsync_togo = 0;       // remaining lines of vsync
// etc
volatile unsigned char vblank = 0;          // changed to 1 when end of screen starts
unsigned int line_count = 0;       // how many lines done so far this page
#define VISIBLE_ROWS 480

static inline void vblank_active ( void ) {
#ifdef INVERT_VBLANK
  gpio_clear ( GPIOB, GPIO12 );
#else
  gpio_set ( GPIOB, GPIO12 );
#endif
  vblank = 1;
}

static inline void vblank_inactive ( void ) {
#ifdef INVERT_VBLANK
  gpio_set ( GPIOB, GPIO12 );
#else
  gpio_clear ( GPIOB, GPIO12 );
#endif
  vblank = 0;
}

static void vga_gpio_setup ( void ) {

  /* Enable GPIO clock. */
  rcc_peripheral_enable_clock ( &RCC_AHB1ENR, RCC_AHB1ENR_IOPBEN ); // hsync, vsync, vblank, vga out, pixel clock
  rcc_peripheral_enable_clock ( &RCC_AHB1ENR, RCC_AHB1ENR_IOPCEN ); // hsync, vsync, vblank, vga out, pixel clock

  // VGA
  //
  // sync lines
  gpio_mode_setup ( GPIOB, GPIO_MODE_OUTPUT, GPIO_PUPD_NONE, GPIO10 ); // vsync
  gpio_mode_setup ( GPIOB, GPIO_MODE_OUTPUT, GPIO_PUPD_NONE, GPIO11 ); // hsync
  gpio_mode_setup ( GPIOB, GPIO_MODE_OUTPUT, GPIO_PUPD_NONE, GPIO12 ); // vblank to CPU
  gpio_mode_setup ( GPIOB, GPIO_MODE_INPUT, GPIO_PUPD_PULLUP, GPIO13 ); // frameready from CPU
  // colour
  gpio_mode_setup ( GPIOC, GPIO_MODE_OUTPUT, GPIO_PUPD_NONE, GPIO0 ); // red
  gpio_mode_setup ( GPIOC, GPIO_MODE_OUTPUT, GPIO_PUPD_NONE, GPIO1 ); // red
  gpio_mode_setup ( GPIOC, GPIO_MODE_OUTPUT, GPIO_PUPD_NONE, GPIO2 ); // green
  gpio_mode_setup ( GPIOC, GPIO_MODE_OUTPUT, GPIO_PUPD_NONE, GPIO3 ); // green
  gpio_mode_setup ( GPIOC, GPIO_MODE_OUTPUT, GPIO_PUPD_NONE, GPIO4 ); // blue
  gpio_mode_setup ( GPIOC, GPIO_MODE_OUTPUT, GPIO_PUPD_NONE, GPIO5 ); // blue
  // speed
  gpio_set_output_options ( GPIOB, GPIO_OTYPE_PP, GPIO_OSPEED_100MHZ, GPIO10 | GPIO11 );
  gpio_set_output_options ( GPIOC, GPIO_OTYPE_PP, GPIO_OSPEED_2MHZ, GPIO0 | GPIO1 | GPIO2 | GPIO3 | GPIO4 | GPIO5 );

  // reset
  //
  gpio_set ( GPIOB, GPIO10 ); // vsync
  gpio_set ( GPIOB, GPIO11 ); // hsync
  gpio_clear ( GPIOC, GPIO0 | GPIO1 ); // red
  gpio_clear ( GPIOC, GPIO2 | GPIO3 ); // green
  gpio_clear ( GPIOC, GPIO4 | GPIO5 ); // blue

}

unsigned char vga_is_frameready ( void ) {
  return ( GPIO_IDR ( GPIOB ) & (1<<13) );
}

static inline void vsync_go_high ( void ) {
  gpio_set ( GPIOB, GPIO10 );
}

static inline void vsync_go_low ( void ) {
  gpio_clear ( GPIOB, GPIO10 );
}

static inline void hsync_go_high ( void ) {
  gpio_set ( GPIOB, GPIO11 );
}

static inline void hsync_go_low ( void ) {
  gpio_clear ( GPIOB, GPIO11 );
}


static void timer2_setup ( void ) {

  //timer_reset ( TIM2 );
  //timer_set_mode
  //timer_continuous_mode ( TIM2 );

  /* Set timer start value. */
  TIM_CNT(TIM2) = 1;

  /* Set timer prescaler. 72MHz/1440 => 50000 counts per second. */
  TIM_PSC(TIM2) = 300; // 280K/s or 0.000 003 571

  /* End timer value. If this is reached an interrupt is generated. */
  TIM_ARR(TIM2) = 8; //

  // o-scope reports:
  // prescale 2000, 1->600 should be 100/sec; in fact, we're exactly 20ms between which is exactly 50 .. so callback is 60MHz, not 120MHz
  // manual says:
  //  The reference manual (see page 133) states that the GPIO is capable of:
  //  Fast toggle capable of changing every two clock cycles
  // --> okay so at 120MHz, the best we can do is 60MHz of GPIO. But thats different than here, where the timer seems halved..

  /* Update interrupt enable. */
  TIM_DIER(TIM2) |= TIM_DIER_UIE;

  //timer_set_repetition_counter ( TIM2, 100 );

  /* Start timer. */
  TIM_CR1(TIM2) |= TIM_CR1_CEN;

  return;
}

unsigned int i = 0;
unsigned char done_sync;
volatile unsigned long int _vblank_count = 0; // can be used for timing
void tim2_isr ( void ) {

  //TIM2_SR &= ~TIM_SR_UIF;    //clearing update interrupt flag
  TIM_SR(TIM2) &= ~TIM_SR_UIF; /* Clear interrrupt flag. */

  /* ISR HAS TO DO SOMRTHING A LITTLE HEAVY
  // https://my.st.com/public/STe2ecommunities/mcu/Lists/cortex_mx_stm32/Flat.aspx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
  // ie: after setting SR, you need to pause read/writes
  // ie: if the ISR is too quick, there may be a spurious re-invocation (tail chain), so you need to do a little something to avoid cpu race condition
  // -- another way to do it, is to do a SR read (which blocks until its 'set' finishes), thus stalling until the ISR is 'done':
  //void SPI2_IRQHandler(void)
  //{
  //  volatile unsigned int dummy;
  //  ... some code...
  //  SPI2_CR2 &= ~SPI_CR2_RXNEIE;  // Turn off RXE interrupt enable
  //  ...some code...
  //  dummy = SPI2_SR; // Prevent tail-chaining.
  //  return;
  //}
  */

  // VGA line logic
  //
  // line1
  // line2
  // ..
  // line600
  // front porch blank            1 line
  // vsync pulse                  4 lines
  // back porch blank             23 lines
  // \__> back to top
  //

  // handle vblank stuff
  // - front porch, leads to
  //  - vsync, leads to
  //   - back porch
  // vsync is normally HIGH, but goes to LOW during pulse
  done_sync = 0;
  if ( front_porch_togo ) {
    front_porch_togo --;
    vblank_active();

    if ( ! front_porch_togo ) { // on exit front porch, start vsync pulse
      vsync_go_low();
      vsync_togo = 2;
    }

    done_sync = 1;
    goto hsync;
    //return; // do nothing..
  }

  if ( vsync_togo ) {
    vsync_togo --;

    if ( ! vsync_togo ) { // on exit vsync pulse, start back porch
      vsync_go_high();
      back_porch_togo = 33;
    }

    done_sync = 1;
    goto hsync;
    //return;
  }

  if ( back_porch_togo ) {
    back_porch_togo --;

    if ( ! back_porch_togo ) {
      line_count = 1;
      vblank_inactive();
    }

    done_sync = 1;
    goto hsync;
    //return; // do nothing..
  }

 hsync:
  // hsync period..
  // should use timer/interupt to 'end the line' and go hsync?
  //

  /* horiz Front Porch */
  i = 16;
  while ( i-- ) {
    __asm__("nop");
  }

  /* Horizontal Sync pulse (low)  */
  hsync_go_low();
  i = 103;
  while ( i-- ) {
    __asm__("nop");
  }

  /* horiz Back Porch */
  hsync_go_high();
  i = 50;
  while ( i-- ) {
    __asm__("nop");
  }

  if ( done_sync ) {
    return;
  }

  // center horizontally; burn some time so image isn't fully on left
#ifndef VGA_DMA
  i = 40;
  while ( i-- ) {
    __asm__("nop");
  }
#endif

  // actual line data
  //
  // line data on/off/on/off..
  // off for hsync/porch business!

#if RENDER_ATALL // pull from array

  // center vertically .. dma seems blurry with this so only for non-DMA
#if 1
  if ( line_count < 40 ) {
    goto scanline_done;
  }
  i = (line_count-40)/2;
#else
  i = (line_count)/2;
#endif

  // done?
  if ( i >= FBHEIGHT ) {
    goto scanline_done;
  }

#ifdef VGA_DMA
  uint8_t *p = fb_active + ( i * FBWIDTH );

  dma_memcpy ( p, (unsigned char*) &(GPIO_ODR(GPIOC)) /*&GPIOC->ODR*/, FBWIDTH, DMA_MEMCPY_INCSRC );

 scanline_done:
#else

#define OLD_EMIT_PIXEL()      \
  GPIO_ODR(GPIOC) = *p++; \
  __asm__("nop");         \
  __asm__("nop");         \
  __asm__("nop");         \
  __asm__("nop");         \
  __asm__("nop");         \
  __asm__("nop");         \
  __asm__("nop");         \
  __asm__("nop");         \
  __asm__("nop");         \
  __asm__("nop");         \
  __asm__("nop");
 // 11 NOP's is pretty ideal

 unsigned char c;
#define EMIT_PIXEL()      \
  c = *p++;               \
  GPIO_ODR(GPIOC) = c;    \
  GPIO_ODR(GPIOC) = c;    \
  GPIO_ODR(GPIOC) = c;    \
  GPIO_ODR(GPIOC) = c;    \
  GPIO_ODR(GPIOC) = c;    \
  GPIO_ODR(GPIOC) = c;    \
  GPIO_ODR(GPIOC) = c;    \
  GPIO_ODR(GPIOC) = c;    \
  GPIO_ODR(GPIOC) = c;    \
  GPIO_ODR(GPIOC) = c;    \
  GPIO_ODR(GPIOC) = c;

  // paint the image
  uint8_t *p = fb_active + ( i * FBWIDTH );

  i = (FBWIDTH) / 16;
  while ( i-- ) {

    EMIT_PIXEL();
    EMIT_PIXEL();
    EMIT_PIXEL();
    EMIT_PIXEL();
    EMIT_PIXEL();
    EMIT_PIXEL();
    EMIT_PIXEL();
    EMIT_PIXEL(); // 8

    EMIT_PIXEL();
    EMIT_PIXEL();
    EMIT_PIXEL();
    EMIT_PIXEL();
    EMIT_PIXEL();
    EMIT_PIXEL();
    EMIT_PIXEL();
    EMIT_PIXEL(); // 8

  }

  // disable all colour pins (dma does it itself in its isr)
  //GPIO_BSRR(GPIOC) = 0x00;

 scanline_done:
  gpio_clear ( GPIOC, GPIO0 | GPIO1 | GPIO2 | GPIO3 | GPIO4 | GPIO5 );

#endif // DMA?

#endif

  // entering vblank period?
  //

  if ( line_count > VISIBLE_ROWS ) {
    front_porch_togo = 10;
    _vblank_count++; // entering vblank
    return; // entering front porch
  }

  line_count++;
}

void vga_setup ( unsigned char use_dma ) {

  /* Enable TIM2 clock. */
  rcc_peripheral_enable_clock(&RCC_APB1ENR, RCC_APB1ENR_TIM2EN);

  //__enable_irq();
  //cm_enable_interrupts();

  /* Without this the timer interrupt routine will never be called. */
  nvic_enable_irq ( NVIC_TIM2_IRQ );
  //nvic_set_priority(NVIC_TIM2_IRQ, 0);

  timer2_setup();

  vga_gpio_setup();

  if ( use_dma ) {
    dma_setup();
    vga_pixelclock_setup();
  }

  return;
}
