skeezix/zikzak/zik80/_reference/stm32f4-vga-build/BitBinTables.h

#ifndef __BITBIN_TABLES_H__
#define __BITBIN_TABLES_H__

#include <stdint.h>

static const uint32_t BitBin11kTable[12*16+1]=
{
	11025,
	0x184cb7,0x186337,0x1879cb,0x189075,0x18a733,0x18be06,
	0x18d4ef,0x18ebec,0x1902ff,0x191a28,0x193166,0x1948b9,
	0x196022,0x1977a0,0x198f35,0x19a6df,0x19be9f,0x19d675,
	0x19ee61,0x1a0663,0x1a1e7c,0x1a36aa,0x1a4ef0,0x1a674b,
	0x1a7fbd,0x1a9846,0x1ab0e6,0x1ac99c,0x1ae269,0x1afb4e,
	0x1b1449,0x1b2d5b,0x1b4685,0x1b5fc6,0x1b791e,0x1b928e,
	0x1bac15,0x1bc5b4,0x1bdf6b,0x1bf939,0x1c131f,0x1c2d1e,
	0x1c4734,0x1c6163,0x1c7ba9,0x1c9608,0x1cb080,0x1ccb10,
	0x1ce5b9,0x1d007a,0x1d1b54,0x1d3647,0x1d5153,0x1d6c78,
	0x1d87b6,0x1da30d,0x1dbe7e,0x1dda08,0x1df5ab,0x1e1168,
	0x1e2d3f,0x1e4930,0x1e653a,0x1e815e,0x1e9d9d,0x1eb9f5,
	0x1ed668,0x1ef2f5,0x1f0f9d,0x1f2c5f,0x1f493c,0x1f6633,
	0x1f8346,0x1fa073,0x1fbdbb,0x1fdb1e,0x1ff89d,0x201637,
	0x2033ec,0x2051bd,0x206fa9,0x208db1,0x20abd5,0x20ca15,
	0x20e871,0x2106e9,0x21257d,0x21442d,0x2162fa,0x2181e4,
	0x21a0ea,0x21c00c,0x21df4c,0x21fea8,0x221e22,0x223db8,
	0x225d6c,0x227d3d,0x229d2c,0x22bd38,0x22dd62,0x22fdaa,
	0x231e10,0x233e93,0x235f35,0x237ff5,0x23a0d3,0x23c1d0,
	0x23e2eb,0x240425,0x24257e,0x2446f5,0x24688c,0x248a41,
	0x24ac16,0x24ce0a,0x24f01e,0x251251,0x2534a3,0x255716,
	0x2579a8,0x259c5b,0x25bf2d,0x25e220,0x260533,0x262867,
	0x264bbb,0x266f30,0x2692c6,0x26b67d,0x26da55,0x26fe4e,
	0x272268,0x2746a3,0x276b01,0x278f80,0x27b420,0x27d8e3,
	0x27fdc8,0x2822ce,0x2847f8,0x286d43,0x2892b1,0x28b842,
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
	0x0f4761,0x0f5587,0x0f63b9,0x0f71f9,0x0f8046,0x0f8ea0,
	0x0f9d07,0x0fab7c,0x0fb9fe,0x0fc88e,0x0fd72b,0x0fe5d5,
	0x0ff48d,0x100353,0x101227,0x102108,0x102ff7,0x103ef3,
	0x104dfe,0x105d17,0x106c3d,0x107b72,0x108ab4,0x109a05,
	0x10a964,0x10b8d1,0x10c84d,0x10d7d7,0x10e76f,0x10f715,
};

#endif
