skeezix/zikzak/zik80/_reference/stm32f4-vga-build/Sprites.c

#include "Graphics/RLEBitmap.h"
const struct { RLEBitmap rle; Pixel codes[RLECodeCount(21,5,32)]; } Star1_0=
{
	{ 32,32 },
	{
		RLEEndCode(0x20),   RLEEndCode(0x20),   RLEEndCode(0x20),   RLEEndCode(0x20),   
		RLEEndCode(0x20),   RLEEndCode(0x20),   RLEEndCode(0x20),   RLEEndCode(0x20),   
		RLEEndCode(0x20),   RLEEndCode(0x20),   RLEEndCode(0x20),   RLEEndCode(0x20),   
		RLEEndCode(0x20),   RLECode(0x0e,0x03), RGB(0xc1,0x00,0x00),RGB(0xff,0x00,0x00),
		RGB(0xc1,0x00,0x00),RLEEndCode(0x0f),   RLECode(0x0d,0x05), RGB(0xc1,0x00,0x00),
		RGB(0xff,0x5c,0x68),RGB(0xff,0xc1,0xb7),RGB(0xff,0x5c,0x68),RGB(0xc1,0x00,0x00),
		RLEEndCode(0x0e),   RLECode(0x0d,0x05), RGB(0xff,0x00,0x00),RGB(0xff,0xc1,0xb7),
		RGB(0xff,0xff,0xff),RGB(0xff,0xc1,0xb7),RGB(0xff,0x00,0x00),RLEEndCode(0x0e),   
		RLECode(0x0d,0x05), RGB(0xc1,0x00,0x00),RGB(0xff,0x5c,0x68),RGB(0xff,0xc1,0xb7),
		RGB(0xff,0x5c,0x68),RGB(0xc1,0x00,0x00),RLEEndCode(0x0e),   RLECode(0x0e,0x03), 
		RGB(0xc1,0x00,0x00),RGB(0xff,0x00,0x00),RGB(0xc1,0x00,0x00),RLEEndCode(0x0f),   
		RLEEndCode(0x20),   RLEEndCode(0x20),   RLEEndCode(0x20),   RLEEndCode(0x20),   
		RLEEndCode(0x20),   RLEEndCode(0x20),   RLEEndCode(0x20),   RLEEndCode(0x20),   
		RLEEndCode(0x20),   RLEEndCode(0x20),   RLEEndCode(0x20),   RLEEndCode(0x20),   
		RLEEndCode(0x20),   RLEEndCode(0x20),   
	}
};
const struct { RLEBitmap rle; Pixel codes[RLECodeCount(21,5,32)]; } Star1_1=
{
	{ 32,32 },
	{
		RLEEndCode(0x20),   RLEEndCode(0x20),   RLEEndCode(0x20),   RLEEndCode(0x20),   
		RLEEndCode(0x20),   RLEEndCode(0x20),   RLEEndCode(0x20),   RLEEndCode(0x20),   
		RLEEndCode(0x20),   RLEEndCode(0x20),   RLEEndCode(0x20),   RLEEndCode(0x20),   
		RLEEndCode(0x20),   RLECode(0x0e,0x03), RGB(0x00,0xc1,0x00),RGB(0x00,0xff,0x00),
		RGB(0x00,0xc1,0x00),RLEEndCode(0x0f),   RLECode(0x0d,0x05), RGB(0x00,0xc1,0x00),
		RGB(0x68,0xff,0x5c),RGB(0xb7,0xff,0xc1),RGB(0x68,0xff,0x5c),RGB(0x00,0xc1,0x00),
		RLEEndCode(0x0e),   RLECode(0x0d,0x05), RGB(0x00,0xff,0x00),RGB(0xb7,0xff,0xc1),
		RGB(0xff,0xff,0xff),RGB(0xb7,0xff,0xc1),RGB(0x00,0xff,0x00),RLEEndCode(0x0e),   
		RLECode(0x0d,0x05), RGB(0x00,0xc1,0x00),RGB(0x68,0xff,0x5c),RGB(0xb7,0xff,0xc1),
		RGB(0x68,0xff,0x5c),RGB(0x00,0xc1,0x00),RLEEndCode(0x0e),   RLECode(0x0e,0x03), 
		RGB(0x00,0xc1,0x00),RGB(0x00,0xff,0x00),RGB(0x00,0xc1,0x00),RLEEndCode(0x0f),   
		RLEEndCode(0x20),   RLEEndCode(0x20),   RLEEndCode(0x20),   RLEEndCode(0x20),   
		RLEEndCode(0x20),   RLEEndCode(0x20),   RLEEndCode(0x20),   RLEEndCode(0x20),   
		RLEEndCode(0x20),   RLEEndCode(0x20),   RLEEndCode(0x20),   RLEEndCode(0x20),   
		RLEEndCode(0x20),   RLEEndCode(0x20),   
	}
};
const struct { RLEBitmap rle; Pixel codes[RLECodeCount(21,5,32)]; } Star1_2=
{
	{ 32,32 },
	{
		RLEEndCode(0x20),   RLEEndCode(0x20),   RLEEndCode(0x20),   RLEEndCode(0x20),   
		RLEEndCode(0x20),   RLEEndCode(0x20),   RLEEndCode(0x20),   RLEEndCode(0x20),   
		RLEEndCode(0x20),   RLEEndCode(0x20),   RLEEndCode(0x20),   RLEEndCode(0x20),   
		RLEEndCode(0x20),   RLECode(0x0e,0x03), RGB(0x00,0x00,0xc1),RGB(0x00,0x00,0xff),
		RGB(0x00,0x00,0xc1),RLEEndCode(0x0f),   RLECode(0x0d,0x05), RGB(0x00,0x00,0xc1),
		RGB(0x5c,0x68,0xff),RGB(0xc1,0xb7,0xff),RGB(0x5c,0x68,0xff),RGB(0x00,0x00,0xc1),
		RLEEndCode(0x0e),   RLECode(0x0d,0x05), RGB(0x00,0x00,0xff),RGB(0xc1,0xb7,0xff),
		RGB(0xff,0xff,0xff),RGB(0xc1,0xb7,0xff),RGB(0x00,0x00,0xff),RLEEndCode(0x0e),   
		RLECode(0x0d,0x05), RGB(0x00,0x00,0xc1),RGB(0x5c,0x68,0xff),RGB(0xc1,0xb7,0xff),
		RGB(0x5c,0x68,0xff),RGB(0x00,0x00,0xc1),RLEEndCode(0x0e),   RLECode(0x0e,0x03), 
		RGB(0x00,0x00,0xc1),RGB(0x00,0x00,0xff),RGB(0x00,0x00,0xc1),RLEEndCode(0x0f),   
		RLEEndCode(0x20),   RLEEndCode(0x20),   RLEEndCode(0x20),   RLEEndCode(0x20),   
		RLEEndCode(0x20),   RLEEndCode(0x20),   RLEEndCode(0x20),   RLEEndCode(0x20),   
		RLEEndCode(0x20),   RLEEndCode(0x20),   RLEEndCode(0x20),   RLEEndCode(0x20),   
		RLEEndCode(0x20),   RLEEndCode(0x20),   
	}
};
const struct { RLEBitmap rle; Pixel codes[RLECodeCount(21,5,32)]; } Star1_3=
{
	{ 32,32 },
	{
		RLEEndCode(0x20),   RLEEndCode(0x20),   RLEEndCode(0x20),   RLEEndCode(0x20),   
		RLEEndCode(0x20),   RLEEndCode(0x20),   RLEEndCode(0x20),   RLEEndCode(0x20),   
		RLEEndCode(0x20),   RLEEndCode(0x20),   RLEEndCode(0x20),   RLEEndCode(0x20),   
		RLEEndCode(0x20),   RLECode(0x0e,0x03), RGB(0xc1,0xc1,0x00),RGB(0xff,0xff,0x00),
		RGB(0xc1,0xc1,0x00),RLEEndCode(0x0f),   RLECode(0x0d,0x05), RGB(0xc1,0xc1,0x00),
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
		RLECode(0x0f,0x01), RGB(0xc1,0xc1,0x00),RLEEndCode(0x10),   RLECode(0x0f,0x01), 
		RGB(0x5c,0x5c,0x00),RLEEndCode(0x10),   RLEEndCode(0x20),   RLEEndCode(0x20),   
		RLEEndCode(0x20),   RLEEndCode(0x20),   
	}
};
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
