skeezix/zikzak/zik80/audio-gen/song_hacked.c

// Data payload offset is 80 50
// Data payload in file is 82000 bytes
// Module 16 -> 0
/* interleaved */
#include <avr/pgmspace.h>
unsigned int framelimit = 2000;
const unsigned char song_hacked_ym[] PROGMEM = {
  0xb3, 0x03, 0x6f, 0x07, 0xdb, 0x01, 0x01, 0xd0, 0x0f, 0x0f, 0x0e, 0x00, 0x00, 0xff, 0x00, 0x00, 
  0xab, 0x03, 0x6f, 0x07, 0xed, 0x00, 0x04, 0xd8, 0x0e, 0x0e, 0x0d, 0x00, 0x00, 0xff, 0x00, 0x00, 
  0xab, 0x03, 0x77, 0x07, 0xdd, 0x01, 0x04, 0xd8, 0x0e, 0x0e, 0x0d, 0x00, 0x00, 0xff, 0x00, 0x00, 
  0xb3, 0x03, 0x7f, 0x07, 0xef, 0x00, 0x04, 0xd8, 0x0d, 0x0c, 0x0c, 0x00, 0x00, 0xff, 0x00, 0x00, 
  0xbb, 0x03, 0x77, 0x07, 0xdd, 0x01, 0x04, 0xd8, 0x0d, 0x0c, 0x0c, 0x00, 0x00, 0xff, 0x00, 0x00, 
  0xc3, 0x03, 0x6f, 0x07, 0xc7, 0x00, 0x04, 0xd8, 0x0c, 0x0b, 0x0e, 0x00, 0x00, 0xff, 0x00, 0x00, 
  0xcb, 0x03, 0x6f, 0x07, 0x8f, 0x01, 0x07, 0xd8, 0x0c, 0x0b, 0x0d, 0x00, 0x00, 0xff, 0x00, 0x00, 
  0xc3, 0x03, 0x77, 0x07, 0xc8, 0x00, 0x07, 0xd8, 0x0b, 0x0d, 0x0d, 0x00, 0x00, 0xff, 0x00, 0x00, 
  0xbb, 0x03, 0x7f, 0x07, 0x93, 0x01, 0x07, 0xd8, 0x0b, 0x0d, 0x0c, 0x00, 0x00, 0xff, 0x00, 0x00, 
  0xb3, 0x03, 0x77, 0x07, 0xc8, 0x00, 0x07, 0xd8, 0x0d, 0x0c, 0x0c, 0x00, 0x00, 0xff, 0x00, 0x00, 
  0xab, 0x03, 0xb7, 0x03, 0x3c, 0x01, 0x07, 0xd8, 0x0d, 0x0f, 0x0e, 0x00, 0x00, 0xff, 0x00, 0x00, 
  0xab, 0x03, 0xb7, 0x03, 0x9e, 0x00, 0x0b, 0xd8, 0x0c, 0x0e, 0x0d, 0x00, 0x00, 0xff, 0x00, 0x00, 
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
  0x13, 0x03, 0xbf, 0x03, 0xef, 0x00, 0x10, 0xd8, 0x0b, 0x0d, 0x0c, 0x00, 0x00, 0xff, 0x00, 0x00, 
  0x1b, 0x03, 0xbb, 0x03, 0x77, 0x00, 0x10, 0xd8, 0x0d, 0x0c, 0x0c, 0x00, 0x00, 0xff, 0x00, 0x00, 
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
};
unsigned long int song_hacked_fullym_len = 82000;
unsigned int song_hacked_ym_len = 32000;
