skeezix/zikzak/zik80/vga-gen/screen-font-rev.h

// bit patterns for the CP437 font, ROTATED, INVERTED

// To save rendering time, they are ordered by line (ie. line 1, line 2) and then 
//  indexed by character.

const byte screen_font [8] [256] PROGMEM = {
  // Row 1
  { 
	0x00, 0x3F, 0x3F, 0x36, 0x08, 0x1C, 0x08, 0x00, 0x7F, 0x00, 0x7F, 0x07, 0x1E, 0x1F, 0x3F, 0x4C, 
	0x40, 0x01, 0x0C, 0x33, 0x3F, 0x1F, 0x00, 0x0C, 0x0C, 0x0C, 0x00, 0x00, 0x00, 0x00, 0x00, 0x00, 
	0x00, 0x18, 0x36, 0x36, 0x18, 0x00, 0x1C, 0x30, 0x0C, 0x30, 0x00, 0x00, 0x00, 0x00, 0x00, 0x03, 
	0x3E, 0x18, 0x3C, 0x3C, 0x0E, 0x7E, 0x1C, 0x7E, 0x3C, 0x3C, 0x00, 0x00, 0x0C, 0x00, 0x30, 0x3C, 
	0x3E, 0x18, 0x7E, 0x1E, 0x7C, 0x7F, 0x7F, 0x1E, 0x66, 0x3C, 0x0F, 0x73, 0x78, 0x63, 0x63, 0x1C, 
	0x7E, 0x3C, 0x7E, 0x3C, 0x7E, 0x66, 0x66, 0x63, 0x63, 0x66, 0x7F, 0x3C, 0x60, 0x3C, 0x08, 0x00, 
	0x18, 0x00, 0x70, 0x00, 0x0E, 0x00, 0x1C, 0x00, 0x70, 0x18, 0x06, 0x70, 0x38, 0x00, 0x00, 0x00, 
	0x00, 0x00, 0x00, 0x00, 0x08, 0x00, 0x00, 0x00, 0x00, 0x00, 0x00, 0x0E, 0x0C, 0x70, 0x3B, 0x00, 
	0x3C, 0x00, 0x0E, 0x3F, 0x66, 0x70, 0x18, 0x00, 0x3F, 0x66, 0x70, 0x66, 0x3E, 0x70, 0x63, 0x18, 
	0x0E, 0x00, 0x1F, 0x3C, 0x00, 0x00, 0x3C, 0x00, 0x00, 0x61, 0x66, 0x0C, 0x1C, 0x66, 0x7C, 0x07, 
	0x0E, 0x1C, 0x00, 0x00, 0x00, 0x7E, 0x1E, 0x1C, 0x18, 0x00, 0x00, 0x61, 0x61, 0x0C, 0x00, 0x00, 
	0x11, 0x2A, 0x6D, 0x0C, 0x0C, 0x0C, 0x1B, 0x00, 0x00, 0x1B, 0x1B, 0x00, 0x1B, 0x1B, 0x0C, 0x00, 
	0x0C, 0x0C, 0x00, 0x0C, 0x00, 0x0C, 0x0C, 0x1B, 0x1B, 0x00, 0x1B, 0x00, 0x1B, 0x00, 0x1B, 0x0C, 
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
	0x00, 0x60, 0x00, 0x00, 0x00, 0x00, 0x60, 0x00, 0x7E, 0x00, 0x00, 0x00, 0x00, 0x60, 0x00, 0x00, 
	0x00, 0x00, 0x00, 0x00, 0x0C, 0x38, 0x00, 0x00, 0x00, 0x00, 0x00, 0x0E, 0x00, 0x00, 0x00, 0x00, 
  }, 

};  //  end of screen_font
