skeezix/zikzak/zik80/zz-sbc-r3-stm407-firmware/command.c

#include <stm32f4xx.h>
#include <string.h>

#include "config.h"
#include "lib_serial.h"

#include "command.h"
#include "commandqueue.h"
#include "logger.h"
#include "framebuffer.h"
#include "framebuffer_demo.h"
#include "lib_bus_ram.h"
#include "skeelib.h"
#include "lib_i2c.h"
#include "HAL.h"

static void lamecopy ( uint8_t *dest, char *src, uint16_t len ) {

  while ( len ) {
    *dest++ = *src++;
    len--;
  }

  return;
}

void command_queue_run ( void ) {
  char *c;

  while ( ( c = queuepull() ) ) {

    //switch ( *((uint16_t*)c) ) {
    switch ( c[0] + (c[1]<<8) ) {

    case LF:
      usart_puts_optional_set ( 0 );
      break;

    case LO:
      usart_puts_optional_set ( 1 );
      break;

    case DL:
      zl_render_line ( fb_active, c [ 2 ], c [ 3 ], c [ 4 ], c [ 5 ], c [ 6 ] );
      USART_puts_optional ( USART2, "+OK DL\n" );
      break;

    case DF:
      fb_render_rect_filled ( fb_active, c [ 3 ], c [ 4 ], c [ 5 ], c [ 6 ], c [ 2 ] );
      USART_puts_optional ( USART2, "+OK DF\n" );
      break;

    case CB:
      fb_render_rect_filled ( fb_active, 0, 0, FBWIDTH - 1, FBHEIGHT - 1, 0x00 );
      USART_puts_optional ( USART2, "+OK CB\n" );
      break;

    case DP:
      fb_test_pattern ( fb_active, fbt_offset_squares );
      USART_puts_optional ( USART2, "+OK DP\n" );
      break;

    case RD:
      {
        char b [ 100 ] = "\0\0\0\0\0\0\0\0\0\0\0\0\0\0\0\0\0\0\0\0\0\0\0\0\0\0";
        uint32_t i;
        uint32_t addr = EXTRAM_BASE;
        uint8_t v;

        bus_grab_and_wait();
        bus_perform_read ( addr ); // discard .. just getting /CS set

        //addr += 1000;

        lame_itoa ( addr, b );

        USART_puts ( USART2, "addr " );
        USART_puts ( USART2, b );
        USART_puts ( USART2, "\n" );

        for ( i = 0; i < 10; i++ ) {
          v = bus_perform_read ( addr );

          b [ 0 ] = '\0';
          b [ 1 ] = '\0';
          b [ 2 ] = '\0';
          b [ 3 ] = '\0';
          b [ 4 ] = '\0';
          lame_itoa ( v, b );

          USART_puts ( USART2, b );
          USART_puts ( USART2, "\n" );

          addr ++;
        }

        bus_release();

        USART_puts ( USART2, "+OK RD\n" );
      }
      break;

    case ID:
      fb_render_rect_filled ( fb_active, 0, 0, FBWIDTH - 1, FBHEIGHT - 1, 0x00 ); // busy loop needed??!
      {
        char b [ 100 ] = "\0\0\0\0\0\0\0\0\0\0\0\0\0\0\0\0\0\0\0\0\0\0\0\0\0\0";
        int retval;
        char retvalb [ 30 ] = "rv: \0\0\0\0\0\0\0\0\0\0\0\0\0\0\0\0\0\0\0\0\0\0\0";

        I2C_BusInit();

        retval = I2C_ReadTransfer ( 0xe8, (uint8_t*)b, 5, 0, 0 );

        lame_itoa ( retval, retvalb + 4 );
        USART_puts_optional ( USART2, retvalb );

        USART_puts_optional ( USART2, b );

        USART_puts_optional ( USART2, "\n" );

      }
      break;
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
