skeezix/zikzak/(commit log)

2013-05-06 setting git remote up
    [zikzak2-001.sch]
2013-05-07 Fixed makefile; lcd builds properly now, including libc
    [main.c]
2013-05-11 messing around
    [zikzak2-001.sch]
2013-05-11 nearly working line-based VGA demo :)
    [zikzak2-001.sch, ~zikzak2-001.sch]
2013-05-15 updating sram test.. still not working :(
    [main.c, main.h, sram.c]
2013-05-17 first cut of inventory
    [general-inventory.ods]
2013-05-18 inventory update
    [general-inventory.ods]
2013-05-22 added csv exported inventory
    [general-inventory.csv]
2013-05-25 added preliminary inkscape drawing of memory switcher
2013-05-26 added lazarus-64 pics in case I need them
2013-05-27 moved LED
2013-05-28 Inventory update, and preliminary memswitcher schematic (address lines are in)
    [general-inventory.ods, zikzak3-memswitch.sch, zikzak3-memswitch2.sch]
2013-05-29 Inventory; fiddled with blinkdemo to convert to atmega128
    [general-inventory.ods]
2013-05-30 schematic update
    [zikzak3-memswitch3.sch]
2013-05-31 updated schematic
    [zikzak3-memswitch3.sch]
2013-05-31 schematic update; added DAC details
    [zikzak3-memswitch3.sch]
2013-06-01 inventory update (used parts up), added a gpu blinker
    [general-inventory.ods]
2013-06-05 Some new code for cpu and gpu, clarified schematic
    [zikzak3-memswitch3.sch]
2013-06-05 updated schematic image
2013-06-11 inventory; added d type flipflops, among others
    [general-inventory.ods]
2013-06-18 VRAM schematic update, nailing pins down
    [zikzak3-memswitch3.sch]
2013-06-28 Split off gpu onto its own board..
    [zikzak3-modules-gpu.brd, zikzak3-modules-gpu.sch]
2013-07-14 added z80a find :)
    [general-inventory.ods]
2013-08-03 Updating inventory
    [general-inventory.ods]
2013-08-13 removed inventory from git, so can publish publicly
    [general-inventory.csv, general-inventory.ods]
2013-10-18 Kicked off zikzak-z80 schematic
    [zikzak-z80-1.sch]
2013-10-22 Added resistor values to zz r3 schem
    [zikzak3-memswitch3.sch]
2013-10-23 Fiddling around with various extra VGA options, and try some ideas from other people; pretty much cannot get around the basic limitations of these low end mcu's, though some approaches using UART and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
2013-10-23 Instead of my own text dump variant, using this version which steals a lot from Nick Gammon; works better due to interupt driving. Funny how interupts were too latent for my earlier experiments; that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
2013-10-23 Added basic wiring notes for future reference
2013-11-03 basic z80 schematic nearly done (missing video and atmega basics like xtal etc)
    [zikzak-z80-1.sch]
2013-11-04 Updated schem to complete atmega; added joystick and speaker; populated vga
    [zikzak-z80-1.sch]
2013-11-04 Fix, changed a 5v->GND on a LED
    [zikzak-z80-1.sch]
2013-11-06 basic joystick sensing.. works! corrections to schematic (pull up, not down, on joystick.)
    [zikzak-z80-1.sch]
2013-11-06 first cut at capturing keyboard clock interupt
2013-11-07 you know, keyb, joystick and audio on the side of VGA gen on 16MHz is too much; its causing too much display distortion and not even got to audio yet; also, it means we are very limited .. but if we 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
    [TimerHelpers.h, main.C, main.h, screen-font-rev.h, screen-font.h]
2013-11-15 Update to add IO mcu to zik80 design
    [zikzak-z80-2.sch]
2013-11-15 Updated schem
    [zikzak-z80-2.sch]
2013-11-19 vga- turn led on; io skeleton added - blinks led
2013-11-19 breadboard: added joy port; joy-up raises/lowers the IO LED as appropriate, woowoo
2013-11-20 moving schems to more convenient location, for r5 design WIP
    [zikzak-z80-1.sch, zikzak-z80-2.sch]
2013-11-20 Added skeleton for '3w' 3-wire-interface, but not using it; updated schem to move VGA stuff more to one side, opening up full side for something else..
    [zikzak-z80-2.sch]
2014-01-06 first setup of audio experiment, atmega644 driving ay-3-8910 (8912 in this case); same as ST YM2149 :) .. just LED blinker so far, and hookup notes .. BB is hooked up!
2014-01-11 okay, got stm32 chip fired up and working :) blinkenlight ftw.
2014-01-15 stm32: working interupt based blinker; some nasty lessons learnt, and now trying to work out how fast we can do these in reality.
2014-01-16 Basic VGA is working; a little shakey, need to tweak timings, etc etc, buy hey.. it does _Something_, which is not bad for a couple hours.
2014-01-17 perfectly straight bars works fine, straight out of C; looks like 180x600 or something. Should DMA it. But w-t-f is going on, with =1 does nothing, but =i works.
2014-01-17 Perfectly sharp vga to the composite adaptor; no wiggles or distortion, RGB supported. Approx 120*600 resolution, and not using DMA yet.
2014-01-17 unrolled the loop, and with RGB array reading, in straight bloring non-DMA c, we're getting about 180x600 :)
2014-01-17 Working on DMA transfer .. not so much luck yet
2014-01-19 Thrashing around trying to get dma to gpio working..
2014-01-19 DMA screwing around.. seems like it never finishes.. never starts? even in the provided CMSIS sample :/
2014-01-19 DMA working! Little shimmery, and interupt delay and startup delay show .. but getting there; very fast!
2014-01-19 DMA based VGA is working very nicely.. full colour at 320x200 up to 600x600 and more .. aweesome!
2014-01-20 DMA working pretty well; trying on real monitor.. too much jitter when pixels change colour .. hmm.. need SPI maybe?
    [dma_memcpy.c, vgatest.c]
2014-01-27 Was screwiung around with pulling in code from doodles stuff (see _reference) but it is not something you can do quickly to get some timing info from; it is too comprehensive. So I think, back to my 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
2014-01-27 Fiddling with DMA setup
2014-01-28 Screwing with associating timer to dma; I don't really 'get it' at all yet, obviously. Mixing in StdPeriph library API with libopencm3 is annoying. Still, with the limited time I get, I'm getting.. w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
    [dma_memcpy.c, vgatest.c]
2014-01-30 VGA is working solid! stm32-f4-vga dir; sharp, no jiggle, bullet proof!
2014-01-30 Some examples from stm32 forum; being stuck on timing, I was bugging clive et al for assistance
    [dmatest.c, vgatest.c]
2014-01-30 alight anim improvement; worry: doing too much during 'vblank' borks up the top few lines of the display; am I cpu locked here? shouldn't interupts take over from main painlessly without sync issues?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
    [framebuffer.c, vgatest.c]
2014-01-31 Fiddling with dma settings
2014-01-31 Disable the dma deinit/cmd before dma setup, since its already finished if we're doing our jobs right; some minor optimization in the pixel pushing, so we can go faster.. not fast enough yet, but not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
2014-02-01 Super sharp crystal clear VGA, with very high bandwidth of screen update.. thanks to CCM memory. The big remaining question is how much input pressure can it take, via interupts or some other mechani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
2014-02-01 Added basic 'torture'; turns up a timer, hits 100 times a sec, and shows some flicker on display :/
2014-02-02 For lulz, added a (commented out) dma-from-SRAM2 option, and gltching still occurs; the problem is twofols .. hitting SRAM1 during DMA, or hitting GPIO during DMA, will glitch. Use FSMC memory contro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
    [vgatest.c]
2014-02-03 VGA fiddling more .. slightly optimize non-DMA approach, so its pretty workable; less glitchign when GPIOs going on, so maybe workable without intermediary; still lots of avenues to pursue that may a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
    [dma_memcpy.c, dma_memcpy.h, framebuffer.c, framebuffer.h, pixelclock.c, system.h, torture.c, vgatest.c]
2014-02-08 Added basic bitbang server to stm32f4 GPU; added contained avr8 code to push sprite-move requests to stm32 f4, for timing testing, at 8MHz avr8. Not too bad. Little shakey on the protocol due to hsyn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
2014-02-26 very preliminary cart skeleton, and pinout nailed down.. for now
    [cart-slot-pinout.ods]
2014-02-27 zikcart schem at28c256 18x2 is in good shape; just started pcb layout however
    [cart-slot-pinout.ods, zikcart-atc256-001.brd, zikcart-atc256-001.sch]
2014-02-28 zikcart tweaked and brd layout done, and gerbers generated!
    [zikcart-atc256-001.brd, zikcart-atc256-001.sch]
2014-02-28 First board submission to elecrow! (on special, 50% off small boards)
    [zikcart-atc256-001.brd]
2014-03-03 Running arm code from buffer experiments
2014-03-08 Received rev1 zikcart pcb; added pics
2014-03-10 Including copy of all (currently) eagle libs I'm using that are not bundled with Eagle; notably skeezix.lbr
2014-04-26 Just starting the new zikzak base board; 5V and 3.3V power supply nearly done.. need to add Vcc Vss Posts and DC jack
    [zik-base-with-gpu-001.sch]
2014-05-05 import eagle libs; update base schematic
    [zik-base-with-gpu-001.sch]
2014-05-06 Added pinheaders to power section of board
    [zik-base-with-gpu-001.sch]
2014-05-10 Renaming zik base schem, to pcb-power .. and added pcb-gpu. Going to mnake more little pcbs instead of one biggy, for this stage.. combine them later
    [zik-pcb-gpu-f405.sch, zik-pcb-power.sch]
2014-05-10 Updating schem for gpu
    [zik-pcb-gpu-f405.sch]
2014-05-11 minor tweaks to gpu sche.. getting mentally ready for finishing it up, deciding what is pinheader versus actual footprints..
    [zik-pcb-gpu-f405.sch, zik-pcb-power.sch]
2014-05-21 Basic gpu pcb schem is done! Need to verify, and route, and good to go?
    [zik-pcb-gpu-f405.sch]
2014-05-22 GPU schem is 'done'.. just need to read it over, verify against datasheet, etc; then off to routing!
    [zik-pcb-gpu-f405.sch]
2014-05-23 few mods to the power pcb schem; finalizing the gpu pcb schem; started power pcb board layout.. woowoo!
    [zik-pcb-gpu-f405.sch, zik-pcb-power.brd, zik-pcb-power.sch]
2014-05-24 rev1 of both power and gpu boards finalized, and elecrow gerber files generated!
    [zik-pcb-gpu-f405.GBL, zik-pcb-gpu-f405.GBO, zik-pcb-gpu-f405.GBP, zik-pcb-gpu-f405.GBS, zik-pcb-gpu-f405.GTL, zik-pcb-gpu-f405.GTO, zik-pcb-gpu-f405.GTP, zik-pcb-gpu-f405.GTS]
2014-06-02 Added photos of recently arrived pcbs!
2014-06-04 Made a couple notes on power and gpu schems, of things needing correction; fiddled with vga out on real pcb.. works!
    [zik-pcb-gpu-f405.sch, zik-pcb-power.brd, zik-pcb-power.sch]
2014-06-04 Added note to gpu schem
    [zik-pcb-gpu-f405.sch]
2014-06-05 Started fiddling with serial server and serial client (stm32, atmega644, respectively)
2014-06-08 Got serial working, avr->gpu, and gpu console -> ftdi -> pc; works great. Forgot that gpu is routing usart1 protocol serial over to different AF-GPIO choices. Love the alternate function routing opti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
2014-06-09 Added skeleton for serial+VGA; vga working nice, put together 640x480x60hz timings with 2* 256x192 framebuffers; serial is screwy due to clock change, need to sort it
2014-06-10 Fix for serial; set HSE_VALUE .. did it in Makefile, to make sure it applies everywhere
    [main.c]
2014-06-11 Image with 1px-wide colours is now solid; DMA is now render option again; serial logging doesn't impact render now; great foundation for working on animation
    [framebuffer.h, framebuffer_demo.c, framebuffer_demo.h, lib_dma_memcpy.c, lib_dma_memcpy.h, lib_serial.c, lib_vga_cm3.c, lib_vga_cm3.h]
2014-06-11 Added basic demo (lines and boxes) from PC over serial; figured out where serial was causing sync problem .. memset (and strcpy, etc) in lib all use DMa or something and collide with interupts
    [command.c, command.h, lib_vga_cm3.c, lib_vga_pixelclock.c, linedemo.py, main.c]
2014-06-18 GPU rev2 designed, ready to send up to elecrow .. *fear*
    [zik-pcb-gpu-f405.brd, zik-pcb-gpu-f405.sch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]
2014-06-20 Initial kickoff of zik80 base pcb
    [zik-pcb-base-bussed.sch]
2014-06-24 Base PCB coming along nicely..
    [zik-pcb-base-bussed.sch]
2014-06-24 base pcb with built in ez80 is more or less ready; time to make pcb..
    [zik-pcb-base-bussed.sch]
2014-06-26 Working on base pcb .. nearly there, but last few traces will take hours..
    [zik-pcb-base-bussed.brd, zik-pcb-base-bussed.sch]
2014-06-27 Working on base pcb .. only about 20 more traces to go/cheat. Whew. Terrible mess, but maybe it'll work.. really needs larger pcb or more planes :O
    [zik-pcb-base-bussed.brd, zik-pcb-base-bussed.sch]
2014-06-28 zikzak base pcb rev1 sent to boardhouse :)
    [zik-pcb-base-bussed.GBL, zik-pcb-base-bussed.GBO, zik-pcb-base-bussed.GBP, zik-pcb-base-bussed.GBS, zik-pcb-base-bussed.GTL, zik-pcb-base-bussed.GTO, zik-pcb-base-bussed.GTP, zik-pcb-base-bussed.GTS]
2014-07-02 Renamed 407 to 429 dir, since actually using f429 in testing; f429 so far seems to glitch display on usart2 (serial) transmit, so added command to turn on/off the responses, which alleviates it; stil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
    [command.c, command.h, commandqueue.c, commandqueue.h, config.h, demo.c, framebuffer.c, framebuffer.h]
2014-07-05 minor fiddling; new photos of gpu rev2 + base rev1, and tweak to serial-bug-vga on f429 (due to debug serial -> vga glitch)
    [lib_serial.c, linedemo.py]
2014-07-07 schem image for base pcb added rev1
2014-07-09 Fiddling with hooking up the gpu and cpu buses .. need more IDC connector!
    [zik-pcb-base-bussed.sch, zik-pcb-gpu-f407.sch]
2014-07-17 Full success! eZ80 -> RAM -> GPU
    [zik-pcb-base-bussed.sch, zik-pcb-gpu-f407.sch]
2014-07-25 Added a 'sbc' single-board-computer version of zikzak; work in progress, but schem is 95% .. just need to fix drill holes sizes, and verify all the connections and part-dropages are ok
    [zik-pcb-sbc-ez80stm100p.sch]
2014-07-26 working on first cut of new pcb layout
    [zik-pcb-sbc-ez80stm100p.brd, zik-pcb-sbc-ez80stm100p.sch]
2014-07-28 Fiddling with sbc board layout
    [zik-pcb-sbc-ez80stm100p.brd, zik-pcb-sbc-ez80stm100p.sch]
2014-08-16 Working on SBC (single board computer) version of zik80; solid schem, very earily pcb layout; oddly enough, an auto-route does a pretty good job, so.. tempting .. but naah :)
    [zik-pcb-base-gpu-bridge.sch, zik-pcb-sbc-ez80stm100p.brd]
2014-08-18 Trundling along.
    [zik-pcb-sbc-ez80stm100p.brd]
2014-08-19 Zik80 SBC rev1 submitted to boardhouse .. exciting!
    [zik-pcb-sbc-ez80stm100p.GBL, zik-pcb-sbc-ez80stm100p.GBO, zik-pcb-sbc-ez80stm100p.GBP, zik-pcb-sbc-ez80stm100p.GBS, zik-pcb-sbc-ez80stm100p.GTL, zik-pcb-sbc-ez80stm100p.GTO, zik-pcb-sbc-ez80stm100p.GTP, zik-pcb-sbc-ez80stm100p.GTS]
2014-08-29 zik80 sbc pcb arrived and mostly populated.. photos added, testing commencing
2014-08-30 Photo of bad solder glitch, trying to debug..
    [config.h, main.c]
2014-09-04 zik80 sbc .. more fiddling; lame on screen menu, serial keyboard control; still too slow .. need to use scenegraph approach :/
    [command.c, config.h, demo.c, demo.h, framebuffer_demo.c, lib_bus_ram.c, lib_fontrender.c, main.c]
2014-09-17 SBC pcb design rev2, sprite demo on ARM
    [zik-pcb-base-bussed.sch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]
2014-10-17 ehh, intermediate temp file screwerey
2014-11-06 schem exported image
    [zik-pcb-sbc-ez80stm100p.sch]
2014-11-21 Added sbc rev3 WIP
    [zik-pcb-sbc-ez80stm100p-r3.brd, zik-pcb-sbc-ez80stm100p-r3.sch]
2014-11-22 Final(?) rev3 zikzak sbc; created brand new zok atmega644 BoB design and board, WIP
    [zik-pcb-sbc-ez80stm100p-r3.brd, zok-atmega644-bob.brd, zok-atmega644-bob.sch]
2014-11-25 Finished up zok atmega bob rev1, and zikzak sbc rev3
    [zik-pcb-sbc-ez80stm100p-r3.brd, zik-pcb-sbc-ez80stm100p-r3.sch, zok-atmega644-bob.brd, zok-atmega644-bob.sch]
2014-11-25 Packaged up the files for elecrow ..
    [zik-pcb-sbc-ez80stm100p-r3.GBL, zik-pcb-sbc-ez80stm100p-r3.GBO, zik-pcb-sbc-ez80stm100p-r3.GBP, zik-pcb-sbc-ez80stm100p-r3.GBS, zik-pcb-sbc-ez80stm100p-r3.GTL, zik-pcb-sbc-ez80stm100p-r3.GTO, zik-pcb-sbc-ez80stm100p-r3.GTP, zik-pcb-sbc-ez80stm100p-r3.GTS]
2015-04-07 stm-f4-sensors may not work (or maybe board is flaky for serial, or serial usb adapter...)
    [lib_serial.c, lib_serial.h, main.c, main.h, system_cm3.c]
2015-10-29 Flailing around with eZ80 interupts and ps/2 keyboard handler; why the hell is it not working?
    [lib_ps2_keyboard.c, lib_ps2_keyboard.h, lib_ps2_keymap.h, main.c]
2015-10-30 Succes, ps2 keyboard working with stock zz rev3 sbc board.. so hardware is proven!
2015-10-30 ps/2 protocol and keyboard fiddling (show scancodes), and audio (some standard tones and farty noises)
    [lib_ay-3-8912.c, lib_ay-3-8912.h, lib_ps2_keyboard.c, main.c, skeelib.h]
2015-11-02 Text description changes to zikzak SBC rev3 pcb schematic, for clarification on component values etc. No pcb actual changes or schem changes.
    [zik-pcb-sbc-ez80stm100p-r3.brd, zik-pcb-sbc-ez80stm100p-r3.sch]
2015-11-02 Added gpu 'test cycle' to cycle through some of the palette and graphcis test screen patterns; added a couple patterns for colour testing
2015-11-04 branched from r3 to r4 zikzak sbc .. added mixer and audio amp/volume circuit
    [zik-pcb-sbc-ez80stm100p-r4.brd, zik-pcb-sbc-ez80stm100p-r4.sch]
2015-11-04 adding a audio circuit schem image
    [zik-pcb-sbc-ez80stm100p-r4.brd, zik-pcb-sbc-ez80stm100p-r4.sch]
2015-11-04 GPU now waits for frameready before doing anything (config.h to enable/disable); need to add that to z80 side..
2016-05-03 Added basic -shield schem, as I work on the library parts creation
    [zik-pcb-sbc-ez80stm100p-r4.sch]
2016-05-03 Catching up
    [Adafruit Pro Trinket 5v0.brd, Adafruit Pro Trinket 5v0.sch, zik-pcb-sbc-ez80stm100p-r3-shield-r1.brd, zik-pcb-sbc-ez80stm100p-r3-shield-r1.sch]
2016-05-03 Tweaking skeezix library for ZZ connectors
    [zik-pcb-sbc-ez80stm100p-r3-shield-r1.sch]
2016-05-03 Tweaking library some more
    [zik-pcb-sbc-ez80stm100p-r3-shield-r1.brd, zik-pcb-sbc-ez80stm100p-r3-shield-r1.sch]
2016-05-03 Tweaking libraries
    [zik-pcb-sbc-ez80stm100p-r3-shield-r1.brd, zik-pcb-sbc-ez80stm100p-r3-shield-r1.sch]
2016-05-09 Updated headphone part
    [zik-pcb-sbc-ez80stm100p-r3-shield-r1.brd, zik-pcb-sbc-ez80stm100p-r3-shield-r1.sch]
2016-05-12 Added basic avr FTDI/serial tester (for zok board)
2016-05-12 Dropped TPS7133QP and FTDI onto shield start
    [zik-pcb-sbc-ez80stm100p-r3-shield-r1.brd, zik-pcb-sbc-ez80stm100p-r3-shield-r1.sch]
2016-05-14 shield progress.. about 50%? pcb coming together, working on placement. Schem has most or everything, just need to hook it all up.
    [zik-pcb-sbc-ez80stm100p-r3-shield-r1.brd, zik-pcb-sbc-ez80stm100p-r3-shield-r1.sch]
2016-05-14 shield - Some placement progress
    [zik-pcb-sbc-ez80stm100p-r3-shield-r1.brd, zik-pcb-sbc-ez80stm100p-r3-shield-r1.sch]
2016-05-15 Shield pcb rough layout coming together nicely
    [zik-pcb-sbc-ez80stm100p-r3-shield-r1.brd, zik-pcb-sbc-ez80stm100p-r3-shield-r1.sch]
2016-05-15 Working on the shield and proving jack layouts
    [zik-pcb-sbc-ez80stm100p-r3-shield-r1.brd, zik-pcb-sbc-ez80stm100p-r3-shield-r1.sch]
2016-05-15 Shield incremental
    [zik-pcb-sbc-ez80stm100p-r3-shield-r1.brd, zik-pcb-sbc-ez80stm100p-r3-shield-r1.sch]
2016-05-16 Shield schem nearly final, just need to lay down traces on pcb
    [zik-pcb-sbc-ez80stm100p-r3-shield-r1.brd, zik-pcb-sbc-ez80stm100p-r3-shield-r1.sch]
2016-05-16 Shield Routing..
    [zik-pcb-sbc-ez80stm100p-r3-shield-r1.brd]
2016-05-17 Shield routing
    [zik-pcb-sbc-ez80stm100p-r3-shield-r1.brd, zik-pcb-sbc-ez80stm100p-r3-shield-r1.sch]
2016-05-17 Shield is routed and checked... ready for boardhouse!
    [zik-pcb-sbc-ez80stm100p-r3-shield-r1.brd, zik-pcb-sbc-ez80stm100p-r3-shield-r1.sch]
2016-05-17 Made gerber files and ready to upload zip ..
    [zik-pcb-sbc-ez80stm100p-r3-shield-r1.GBL, zik-pcb-sbc-ez80stm100p-r3-shield-r1.GBO, zik-pcb-sbc-ez80stm100p-r3-shield-r1.GBP, zik-pcb-sbc-ez80stm100p-r3-shield-r1.GBS, zik-pcb-sbc-ez80stm100p-r3-shield-r1.GTL, zik-pcb-sbc-ez80stm100p-r3-shield-r1.GTO, zik-pcb-sbc-ez80stm100p-r3-shield-r1.GTP, zik-pcb-sbc-ez80stm100p-r3-shield-r1.GTS]
2016-05-26 Testing zikshield r1 on zzr3 .. so far so good ps/2 keyb, usb power/serial, VGA jacks; beautiful :)
2016-05-27 Started working on case desig for 3d printing
    [zikcase-all.scad, zikcase-left-top-back-1.stl, zikcase-right-bottom-front-1.stl]
2016-05-27 Added invert option to scad script
    [zikcase-all.scad]
2016-05-27 Exported STLs in mini-format
    [zikcase-left-top-back-1.stl, zikcase-right-bottom-front-1.stl]
2016-05-29 Added new 2U type case, nearly done, out of batteries :)
    [_assert.scad, _fanholes.scad, zikcase-Ubox-all.scad]
2016-05-29 Second try at case, using U-panels to make a box, coming along very well; test print ongoing..
    [zikcase-Ubox-all.scad]
2016-05-31 quickie photo of case top
2016-06-03 For ZZ ez80 firmware, got project settings sorted so can Debug (to RAM) or Release (to flash) on the ZZ board; save on those precious few writes, and also a faster turnaround cycle for testing.. winw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
